zxs18261/GIM6010/1、SguanFOC库文件/docs/adr/0002-use-encoder-direction-as-mechanical-reference.md

# 以编码器方向作为机构机械正方向基准

编码器方向由安装关系决定，并可作为电机和最终机构统一的机械方向参考。项目决定装配校准以编码器定义的机械正方向为基准修正电机/PWM方向；相序、电流通道映射、Clarke/Park符号和电角度偏置仍作为独立变量验证，不能仅凭一次正向旋转同时推断全部方向正确。
