zxs18261/GIM6010/2、SguanFOC库文件/DOC/GIM6010.md

# GIM6010 关节控制器 — 总体设计文档

> **工程路径**：当前工作副本 `D:\Desktop\临时\2、SguanFOC库文件`
> **适用硬件**：GIM6010 V0.0 驱动板 + 伺泰威 GIM6010-8（24V 版）电机 + MT6816 磁编码器
> **文档版本**：v1.1（2026-09-05，四模式静态整改同步）
> **当前阶段目标**：通过 VOFA+/USART1 安全切换开环、电流/转矩、速度和位置四种模式；操作合同以工程根目录 `四模式上位机控制说明.md` 为准
> **验证边界**：本轮仅完成源码、文档和工程元数据静态复核；未重新构建、烧录或进行电机台架验证

---

## 目录

1. [项目目标与边界](#1-项目目标与边界)
2. [MCU 与软件环境](#2-mcu-与软件环境)
3. [硬件资源（原理图 + ioc 整理）](#3-硬件资源)
4. [功率级、PWM 与安全关断](#4-功率级pwm-与安全关断)
5. [电流、母线电压与温度采样](#5-电流母线电压与温度采样)
6. [电机与机械传动参数](#6-电机与机械传动参数)
7. [编码器与位置反馈](#7-编码器与位置反馈)
8. [三种角度、方向与零位约定](#8-三种角度方向与零位约定)
9. [控制架构与中断时基](#9-控制架构与中断时基)
10. [状态机设计](#10-状态机设计)
11. [代码框架（什么内容放什么文件、什么参数在哪定义）](#11-代码框架)
12. [串口与 FDCAN 协议](#12-串口与-fdcan-协议)
13. [单位与显示约定](#13-单位与显示约定)
14. [实施路线](#14-实施路线)

---

## 1. 项目目标与边界

| 项目 | 说明 |
|---|---|
| 用途 | 6 自由度机械臂关节控制器，**单板单轴**，全臂 6 板 6 电机 |
| 本期目标 | 通过 VOFA+/USART1 切换开环、电流/转矩、速度、位置四种模式，并完成单关节静态整改；闭环稳定性仍待台架验证 |
| 后续迭代 | 多轴 FDCAN 同步、重力矩前馈、性能整定、上机械臂联调 |
| 代码边界 1 | **不修改 CubeMX 生成代码**，所有代码写入 `USER CODE BEGIN/END` 段 |
| 代码边界 2 | SguanFOC 库主体结构保留；本次已对 `SguanFOC.c` 的四模式路由与失效安全路径做必要修正，后续改动须同步静态复审 |
| 允许 | 重新生成 CubeMX 工程（`GIM6010_V0.0.ioc`） |
| 状态机参考 | BTB 电机驱动工程（袁雷平台资料）概念 + **SguanFOC 库内置 24 态状态机**（实际采用后者） |

---

## 2. MCU 与软件环境

| 项目 | 配置 |
|---|---|
| MCU | STM32G431CBT6，LQFP48（ioc 实际 CPN，封装 LQFP48） |
| 主频 | 170 MHz（HSE 8 MHz 晶振 ×PLL：/2 ×85 /2） |
| 框架 | HAL 库，**裸机**（无 RTOS） |
| PWM 频率 | 20 kHz（TIM1 中心对齐，ARR=4249） |
| 调试接口 | SWD（PA13/PA14）+ USART1（PB6/PB7，921600-8N1），**共用 CN9 GH1.25-6P 接插件**（CLK/DIO/TX/RX/VCC/GND×2，见网表 CN9） |
| IDE | Keil MDK-ARM V5.32（工程 `MDK-ARM/`） |
| 代码风格 | 参照 SguanFOC：中文注释、`Sguan.xxx` 结构体化参数、static inline 用户层挂钩 |

---

## 3. 硬件资源

### 3.1 引脚分配表（以 ioc + 网表为准，★=关键信号）

| 引脚 | 网络名 | 方向 | 功能 | 外设 |
|---|---|---|---|---|
| PA8 | HIN_W | out | ★W 相上管 PWM | TIM1_CH1 |
| PA9 | HIN_V | out | ★V 相上管 PWM | TIM1_CH2 |
| PA10 | HIN_U | out | ★U 相上管 PWM | TIM1_CH3 |
| PB13 | LIN_W | out | ★W 相下管 PWM | TIM1_CH1N |
| PB14 | LIN_V | out | ★V 相下管 PWM | TIM1_CH2N |
| PB15 | LIN_U | out | ★U 相下管 PWM | TIM1_CH3N |
| PB1 | ADC_IV | in | ★V 相电流（INA181A2 输出） | ADC1_IN12（注入 Rank1） |
| PB0 | ADC_IW | in | ★W 相电流（INA181A2 输出） | ADC1_IN15（注入 Rank2） |
| PB11 | ADC_VBUS | in | ★母线电压（30k/3k 分压） | ADC1_IN14（注入 Rank3 + 规则 Rank1） |
| PA2 | ADC_NTC1 | in | ★板载 NTC（MOS 旁，3950/10k，上拉10k） | ADC1_IN3（规则 Rank2） |
| PA3 | ADC_NTC2 | in | ★电机内部 NTC（外接 P1 焊盘，上拉10k） | ADC1_IN4（规则 Rank3） |
| PB2 | ADC_IBUS | in | 母线电流（R2=5mΩ） | ADC2_IN12（规则） |
| PB3 | MT6816_SCK | out | 编码器 SPI 时钟 | SPI3_SCK（Mode3, 16bit, 5.3125Mbps） |
| PB4 | MT6816_MISO | in | 编码器 SPI 主入 | SPI3_MISO（DMA2_CH1） |
| PB5 | MT6816_MOSI | out | 编码器 SPI 主出 | SPI3_MOSI（DMA2_CH2） |
| PA15 | MT6816_CSN | out | ★编码器片选（软件 CS，经 U3 电平转换） | GPIO_Output（默认高） |
| PA4 | CSN | out | 备用片选（直连 CN47.5 外接编码器口） | GPIO_Output |
| PA12 | RGB | out | WS2812B RGB 灯 | TIM4_CH2（PWM+DMA1_CH1） |
| PA11 | KEY1 | in | 按键（SW2，10k 上拉） | GPIO_Input |
| PB6 | TX | out | 串口发送（CN9.3） | USART1_TX（DMA1_CH2） |
| PB7 | RX | in | 串口接收（CN9.2） | USART1_RX（DMA1_CH4） |
| PB8 | CAN_RX | in | FDCAN 数据（U9 收发器） | FDCAN1_RX |
| PB9 | CAN_TX | out | FDCAN 数据 | FDCAN1_TX |
| PA13/PA14 | SWDIO/SWCLK | — | SWD 调试（CN9.5/4） | SYS |
| PF0/PF1 | OSC | — | HSE 8 MHz 晶振 | RCC |

> **注意**：`TIM1_CH1=W、CH2=V、CH3=U`（引脚标签即丝印），FOC 输出比较映射时必须按此交换（见 `User_PwmDuty_Set`）。

### 3.2 电源架构（网表 U40/U4/U18）

```
VBUS(历史设计标称12~48V；当前台架仅允许24V标称, XT30:U116) ──► U40 Buck ──► 12V ──► U2 栅极驱动器供电
                                    │
                                    └──► U4 LDO ──► VCC 3.3V（MCU/编码器）
1.65V 基准：U18（供 INA181A2 差分基准，实现双向电流检测）
CAN 端接：R96=120Ω（CAN_H/CAN_L 与电源共用 XT30:U116 接插件）
```

### 3.3 调试/烧录接插件 CN9（GH1.25-6P）

| 脚位 | 信号 | 脚位 | 信号 |
|---|---|---|---|
| 1 | GND | 4 | SWCLK (PA14) |
| 2 | USART1_RX (PB7) | 5 | SWDIO (PA13) |
| 3 | USART1_TX (PB6) | 6 | VCC 3.3V |

---

## 4. 功率级、PWM 与安全关断

| 项目 | 参数 | 来源 |
|---|---|---|
| 额定母线电压 | 24 V；当前交付未验证且不允许按 48V 上电 | 24V 电机 + 当前 ADC 量程边界 |
| MOS 管 | VS1804GPH ×6（Q1/Q3/Q7 上管，Q2/Q4/Q13 下管） | 用户需求+网表（PDFN-8） |
| 栅极驱动器 | FD6288Q（U2，QFN-24），三分立自举（D1/D2/D3 + C8/C10/C11）；具体料号仍须以 BOM 与实物复核 | 原理图 PDF + 随附 FD6288 数据手册 |
| PWM 定时器 | TIM1，中心对齐模式 1，PSC=0，**ARR=4249** → **20 kHz** | ioc |
| 死区 | ioc `DeadTime=9`，tDTS=2/170MHz → **约 106 ns**（用户要求 200 ns 时改为 DT=17，待确认是否需要） | ioc 计算 |
| PWM 极性 | `PWM_Dir = -1`（高低电平对应经实测确定） | 旧工程实测 |
| MOE 安全关断 | 显式使能；停机/故障使用 `__HAL_TIM_MOE_DISABLE_UNCONDITIONALLY` 或直接清 BDTR.MOE；Break 未启用（ioc BreakState=DISABLE，后续可启用 BRK 输入） | ioc + 源码 |
| ADC 触发 | TIM1_CC4（PWM2 模式，CCR=ARR-40，**峰值前（下溢附近）触发** → 采样下桥臂电流） | ioc + 旧工程实测 |

> **安全关断路径**：显式停机、通信接收错误/队列溢出、ADC 注入链连续 5 ms 无心跳、20 kHz 电流环连续 3 个周期达到或超过 50 µs、SguanFOC 故障态以及 CPU Fault 均无条件清 TIM1 MOE，使三相桥进入高阻；普通 HAL `__HAL_TIM_MOE_DISABLE` 会因通道仍启用而拒绝清 MOE，本工程禁止将它用于安全停机。连续超期策略只在校准及正常控制状态内累计，恢复后必须重新连续累计 3 次。硬件 Break 尚未启用，仍需后续实机改版验证。

---

## 5. 电流、母线电压与温度采样

### 5.1 相电流采样（下桥臂双电阻 + INA181A2）

```
V相下管(Q2) ── R14(5mΩ) ──┐
W相下管(Q13) ─ R16(5mΩ) ─┼── IBUS+ ── R2(5mΩ) ── PGND
U相下管(Q4) ──────────────┘            │
                                       R17(0Ω) ── AGND（单点连接）

U15(INA181A2): IN+ = IV+(R14压降上端)  IN- = IBUS+  → ADC1_IN12 (V相电流)
U19(INA181A2): IN+ = IW+(R16压降上端)  IN- = IBUS+  → ADC1_IN15 (W相电流)
U16(INA181A2): IN+ = IBUS+             IN- = PGND   → ADC2_IN12 (母线电流)
基准 1.65V(U18) → 双向电流，ADC 中点 = 2048
```

| 参数 | 值 | 说明 |
|---|-----|---|
| 采样电阻 | 5 mΩ（R14/R16） | R1206 |
| 放大器 | INA181A2，**增益 ×20** | 旧工程实测采用 |
| ADC 量程换算 | `I = (ADC-2048)/4096 × 3.3V / (20×0.005Ω)` ≈ (ADC-2048)×0.00806 A | 库自动按 `Amplifier×Sampling_Rs` 计算 |
| 电流通道 | `Current_Num = 2`（BC 相 = IV+IW） | 库定义 0=AB,1=AC,2=BC |
| U 相电流 | 由 `Ia+Ib+Ic=0` 软件重构 | 库内部完成 |

### 5.2 母线电压采样（ADC1_IN14）

分压网络：`VBUS ── R20(30kΩ) ──┬── ADC1_IN14 ── R19(3kΩ) ── AGND`

- **分压比 1/11**：`VBUS = ADC/4096 × 3.3 × 11`
- ⚠️ **硬件量程限制**：ADC 3.3V 满量程对应母线约 **36.3 V**；48V 母线会使 ADC 节点理论上升至约 4.36V，已经超出当前采样链可测范围，禁止据此直接接入 48V。
- 软件阈值按既有配置为 **过压 50V / 欠压 10V**；驱动从约 35.45V（ADC 码 4000）起按过量程失效关断，为器差和噪声留出裕量。此时保护值和 Ch12 会显示 1000V 哨兵（不是实际物理电压），只能表达“已接近或超过量程边界”；若需 50V 定量检测必须修改分压网络并重新标定。

### 5.3 温度采样（双路 NTC 独立保护）

| 通道 | 引脚 | 位置 | 规格 | 过温阈值 | 故障策略 |
|---|---|---|---|---|---|
| 板载 NTC（位号 NTC2） | PA2 / ADC1_IN3 | **MOS 管旁**（板内焊接） | 3950 / 10kΩ / 0603，上拉 R3=10k→3.3V | **100 ℃**（用户要求） | 开路/短路 → 等效 **+120 ℃**（fail-safe 直接过温锁定） |
| 电机 NTC（外接 P1 焊盘） | PA3 / ADC1_IN4 | **电机绕组内部**（经连接器外接） | 暂按 3950/10k 假定（⚠️ 厂家未给规格，待确认），上拉 R4=10k→3.3V | **80 ℃**（电机额定工作温度上限，规格书 −20~+80℃） | 开路/短路/**未接** → **通道旁路**（不参与保护，台架可不接） |

- 换算（B 常数法，`T0=298.15K`，两路独立 B 值/R25 宏）：
  `R_ntc = 10k × Vadc/(3.3−Vadc)`；`T[K] = 1 / (1/298.15 + ln(R_ntc/R25)/B)`
- **库单比较点归一化**：SguanFOC 库只有一个 `Temp_MAX` 比较点 → `BSP_ADC_GetTemp()` 返回严重度归一化值：
  `severity = max( T_board×100/100 , T_motor×100/80 )`，库 `Temp_MAX=100` 时**任一通道达到自身阈值即触发过温锁定**
- 当前 24 通道 VOFA 帧不再直接显示两路物理温度；温度保护仍在运行。需要观测温度时应在受控调试固件中另加诊断通道，不能把当前 Ch21/Ch22（d/q 电流控制器输出）误当温度。
- ⚠️ 电机 NTC 实际 B 值/阻值拿到厂家规格后改 `BSP_ADC.h` 中 `BSP_ADC_NTC_MOTOR_*` 宏

### 5.4 采样调度

| 信号 | 通道 | 触发 | 频率 | 用途 |
|---|---|---|---|---|
| IV / IW / VBUS | ADC1 注入 Rank1-3 | TIM1_CC4 硬件触发 | 20 kHz | 电流环 + VBUS 快速监视 |
| VBUS / NTC1 / NTC2 | ADC1 规则 Rank1-3 | 主循环软件轮询（HAL tick 门控） | 100 Hz | 慢速保护（温升慢） |
| IBUS | ADC2 规则 | 软件按需 | 低 | 调试观测（本期不参与保护） |

---

## 6. 电机与机械传动参数

> 完整数据见 `资料/文档/GIM6010_电机参数规格书(24V).md`（厂家 24V 版），此处为直接引用摘要。

| 参数 | 值 | 参数 | 值 |
|---|-----|---|-----|
| 极对数 | **14** | 额定电压 | 24 V |
| 线电阻 Rs | 0.44 Ω | 额定功率 | 158.4 W |
| 线电感 Ld/Lq | 230.77 mH（厂家标称，疑似 230.77µH，待 LCR 实测） | 额定电流 | 6.6 A |
| 磁链 Flux | ≈0.02905 Wb（Kt=0.61/(1.5×14) 估算） | 堵转电流 | 30.47 A |
| 减速比 | **8:1** 行星（钢齿轮） | 输出轴背隙 | 15 arcmin |
| 转矩常数 Kt | 0.61 N·m/A | 额定/峰值转矩 | 4.85 / 12.39 N·m（输出轴） |
| 输出轴额定转速 | 245 rpm（25.66 rad/s） | 电机轴额定转速 | 1960 rpm（205.3 rad/s） |
| 速度上限（软件） | 输出轴 30.79 rad/s（额定×1.2） | 工作温度 | −20~+80 ℃（驱动板过温阈值另设 100℃） |

**换算关系**（单位约定见 §13）：
- 电机轴转速 = 输出轴转速 × 8
- 输出轴角度 = 电机轴角度 / 8
- 上位机单位：串口位置命令与 VOFA 角度通道使用 **rad**，串口速度命令使用输出轴 **rad/s**，VOFA/CAN 速度遥测使用输出轴 **rpm**；当前活动合同不使用 deg

---

## 7. 编码器与位置反馈

| 项目 | 配置 |
|---|---|
| 型号 | MT6816（磁编码器，安装在**电机转子轴**上，非减速器输出轴） |
| 接口 | SPI3（Mode3 CPOL=1/CPHA=2Edge，16bit 帧，5.3125 Mbps），CS = PA15 软件控制，经 U3 电平转换接 CN47 外接口 |
| 类型 | **绝对式、单圈** |
| 分辨率 | **14 bit = 16384 CPR**（ANGLE 寄存器有效位，手册确认） |
| 采样方式 | 主循环调用 `BSP_MT6816_PollBlocking()`，以 HAL tick 门控为约 **1 kHz**；每次阻塞完成 SPI 双帧（命令 0x3000/0x3100 + 数据回读），带奇偶校验 + 无磁检测 |
| 无第二编码器 | 输出轴位置 = 转子位置 ÷ 8（软件折算） |
| 数据缓存 | 阻塞读取完成后发布快照（角度/速度/多圈计数），**20 kHz 电流环 ISR 只读缓存，绝不轮询 SPI**；旧 DMA 请求/服务 API 仅保留为停用实验路径 |

> BSP 层（`BSP/BSP_MT6816.c`）提供 `mech_rad`（转子单圈 0~2π）、`mech_cont_rad`（连续角）、`elec_rad`（电角度）、`mech_omega_rpm`（转子 rpm）、`shaft_*`（输出轴折算量）全套接口，含 DWT 时戳与失效超时检测。活动路径是主循环约 1 kHz 阻塞读取后发布缓存，不得依据保留的 DMA API 注释恢复 ISR 投递。

---

## 8. 三种角度、方向与零位约定

### 8.1 三种角度定义

| 角度 | 符号 | 定义 | 来源 |
|---|---|---|---|
| 机械角（转子） | `Real_Rad` | MT6816 单圈原始角，**0~2π**，以 **MT6816 增大方向为正** | 编码器直读 |
| 机械角（连续/多圈） | `Real_Pos` | 机械角累计圈数展开，PLL 平滑 | 库 PLL |
| 电角度 | `Real_Erad` | `机械角 × 极对数(14)`，归一化 0~2π，供 Park/SVPWM | 库计算 |

- **一切以转子机械角度（MT6816 值）为准**：判断电机正/反转、判断电角度方向、判断零位。
- 单圈范围统一 **0~2π**；`Real_Pos` 多圈连续。
- 输出轴角度 = 转子角 / 8（仅用于上位机显示与关节层面命令，控制环内部始终用转子角）。

### 8.2 方向约定与相序校准流程

**正方向定义：MT6816 读数增大的方向 = 关节正方向。**

上电校准流程（首次带载验证时执行，流程写入 §10 应用状态机 CALIBRATE 态）：

1. 上电读 MT6816 原始角 → 记录 `enc_start`
2. 以小 Uq 开环拖动电机正转（`Motor_Dir=+1`）
3. 若 `enc_end > enc_start`（增加）→ **相序正确**，`Motor_Dir=+1`、`Encoder_Dir` 保持
4. 若 `enc_end < enc_start`（减少）→ **三相焊反**：物理调换任意两相线，或软件置 `Motor_Dir=-1`（临时），最终以硬件调线为准
5. 电流方向同理验证：正 Iq 应产生正转矩（编码器读数增大），否则翻转 `Current_Dir0/1`
6. 结果写入 `UserData_Motor.h` 并记录到本文档 §15 台架记录

### 8.3 电角度零位（编码器-转子对齐）

- 库 INITIALIZING/CALIBRATING 流程执行：经用户层缩放后的 `Ud = 0.04×VBUS` 拉 d 轴 → 保持 1200 ms → 采样 MT6816 角为 `Pos_offset` → 撤压并等待 800 ms
- `Real_Erad = (mech_rad − Pos_offset) × 14`，软件自动完成
- 零位值断电丢失（无 Flash 保存），每次上电重新对齐（绝对编码器使对齐过程确定性可重复）

---

## 9. 控制架构与中断时基

### 9.1 控制环结构（SguanFOC 三环）

```
主循环：BSP_MT6816_PollBlocking() 约1kHz → 发布角度/速度缓存
                               │
┌──────────────── 20 kHz（ADC 注入完成 ISR）──────────────────────────┐
│ 读编码器缓存 → PLL/角度；Clarke/Park → Id/Iq                         │
│ 电流环 PI(D/Q) 每周期执行 → Ud/Uq → Park逆 → SVPWM → TIM1 CCR       │
│ 速度环每 Response=20 周期执行一次：约 1 kHz                          │
│ 位置环每 Response²=400 周期执行一次：约 50 Hz                         │
└────────────────────────────────────────────────────────────────────┘
TIM2 ISR（1 kHz）：状态机、保护和 ADC High_Loop 心跳监视
主循环：VOFA JustFloat 发送（500 Hz）/ FDCAN / RGB / UART 命令解析 / 慢 ADC（100 Hz）
```

### 9.2 中断优先级（NVIC，ioc 已定）

| 优先级 | 中断 | 功能 | 频率 |
|---|---|---|---|
| 0 | ADC1_2_IRQn | 电流环 High_Loop | 20 kHz |
| 2 | TIM2_IRQn | Low_Loop（状态机、保护、ADC 心跳监视） | 1 kHz |
| 3 | USART1、DMA1 | 串口 VOFA 收发 | 500 Hz/921600bps |
| 0(未启) | TIM1_BRK 等 | 预留刹车保护 | — |

> TIM2 的 `Low_Loop` 负责状态机和保护，不直接执行速度/位置控制器。SPI3/DMA2 中断和旧异步 API 仍保留在工程中，但当前活动采样路径不投递 DMA 请求。

### 9.3 环路频率分配（库 Response=20 分频机制）

| 环 | 频率 | 驱动 |
|----|---|---|
| 电流环 | 20 kHz | ADC1 注入完成回调 |
| 编码器采样 | 约 1 kHz | 主循环 `BSP_MT6816_PollBlocking()`，HAL tick 自限速 |
| 速度环 | 1 kHz | 20kHz/Response(20) |
| 位置环 | 50 Hz | 20kHz/Response²(400) |
| 状态机+保护 | 1 kHz | TIM2 ISR |
| VOFA 上报 | 500 Hz | 主循环节拍 |

---

## 10. 状态机设计

### 10.1 两级状态机架构

```
┌────────────────────────────────────────────────────────────────┐
│ 应用层状态机 APP_JointState（APP/app_joint.c，主循环+命令驱动）     │
│  管理命令源(串口/CAN)、模式切换请求、标定流程触发、LED 主题           │
└───────────────┬────────────────────────────────────────────────┘
                │ 写 Sguan.mode / Sguan.status / Sguan.foc.Target_*
┌───────────────▼────────────────────────────────────────────────┐
│ FOC 内核状态机 Sguan.status（SguanFOC.c，1kHz Low_Loop 驱动，24态） │
│  保护转移(过压/欠压/过温/过流/编码器错) + 运行态细分                 │
└────────────────────────────────────────────────────────────────┘
```

应用层不重复实现保护逻辑（库已含），只做**命令仲裁 + 模式管理 + 上层协议**。

### 10.2 FOC 内核状态机（库内置，`Sguan_MotorStatus.h`，禁止修改）

| 编号 | 状态 | 含义 | 退出 |
|---|---|---|---|
| 0x00 | STANDBY | 待机（未初始化） | 解锁信号→0x01 |
| 0x01 | UNINITIALIZED | 等待初始化触发 | 自动→0x02 |
| 0x02 | INITIALIZING | 参数加载、外设启动、**编码器零位对齐** | 自动→0x03 |
| 0x03 | CALIBRATING | 校准（SVPWM 可用，转子校正） | 自动→0x04 |
| 0x04 | IDLE | 空闲（MOE 关闭，高阻等待目标） | 有效运动目标→运行态；模式0～2近零保持高阻，位置 `AO=0?` 也可有效 |
| 0x05/0x06 | TORQUE_INC/DEC | 力矩增大/减小中（电流模式） | 稳态→0x07 |
| 0x07 | TORQUE_CONTROL | 力矩保持（电流模式稳态） | — |
| 0x08/0x09 | ACC/DEC | 加/减速中（速度模式） | 稳态→0x0A |
| 0x0A | CONST_SPEED | 恒速（速度模式稳态） | — |
| 0x0B/0x0C | POSITION_INC/DEC | 位置增/减中（**位置模式**） | 到位→0x0D |
| 0x0D | POSITION_HOLD | 位置保持（**位置模式稳态**） | — |
| 0x0E | OVERVOLTAGE | 过压（**锁定**） | 手动解除→0x00 |
| 0x0F | UNDERVOLTAGE | 欠压（**锁定**） | 手动解除→0x00 |
| 0x10 | OVERTEMPERATURE | 过温>100℃（**锁定**） | 手动解除→0x00 |
| 0x11 | UNDERTEMPERATURE | 低温（锁定） | 手动解除→0x00 |
| 0x12 | OVERCURRENT | 过流（当前实现锁定并立即关 PWM） | 条件恢复后手动 `CO=1?` |
| 0x13 | ENCODER_ERROR | 编码器故障（锁定） | 手动解除→0x00 |
| 0x14 | SENSOR_ERROR | 传感器故障（锁定） | 手动解除→0x00 |
| 0x15 | PWM_CALC_FAULT | PWM 计算错误/连续 3 个 50 µs 周期超期（锁定） | 手动解除→0x00 |
| 0x16 | EMERGENCY_STOP | 急停（立即关 PWM，锁定） | 手动解除→0x00 |
| 0x17 | DISABLED | 软失能（缓慢停止） | 自动→0x00 |

**状态转移图（运行主线）**：

```
0x00 STANDBY ─解锁─► 0x01 ─自动─► 0x02 INITIALIZING(对齐Ud) ─► 0x03 CALIBRATING ─► 0x04 IDLE
                                                                    │
             ┌──────────────────────────────────────────────────────┤
             ▼                                                      ▼
模式=电流: 0x05/0x06 ⇄ 0x07        模式=速度: 0x08/0x09 ⇄ 0x0A     模式=位置(本期): 0x0B/0x0C → 0x0D
             │                                                      │
             └─────────── 任意运行态 ──► 故障态 0x0E~0x17 ◄──────────┘
                              故障态 ──条件消失后显式 CO=1? ──► 0x01（重新初始化/对齐）
```

### 10.3 应用层关节状态机（`APP/app_joint.c`，新增）

| 状态 | LED（WS2812B） | 进入条件 | 动作 |
|---|---|---|---|
| APP_INIT | 白色呼吸 | 上电 | 外设自检、FDCAN 上线、等待 500ms |
| APP_STANDBY | 绿色慢闪 | APP_INIT 完成 | **不自动使能闭环**（防首次闭环方向符号未知导致过流），等串口 `CO=1?` 或 CAN 使能 |
| APP_IDLE | 绿色呼吸 | FOC 0x04 | MOE 关闭，等待当前模式的显式目标 |
| APP_CALIBRATING | 黄色闪烁 | FOC 0x02~0x03 | 观察对齐过程（可扩展相序自检 §8.2） |
| APP_RUNNING | 青色呼吸 | FOC ≥0x04 且收到目标 | 按当前模式执行目标；位置命令与 Ch9 反馈均为电机轴 rad |
| APP_FAULT | 红色快闪 | FOC 故障态(0x0E~0x17) | 记录故障码，等待清除命令 |
| APP_DISABLED | 蓝色慢闪 | 收到失能命令 | 置 DISABLED 信号，FOC 软停 |

应用层命令由串口 VOFA 或 FDCAN 统一仲裁。串口使用 `BO=0..3?`、`AO=<有限十进制>?`、`VO=<有限十进制>?`、`CO=0/1?`；FDCAN 使用 §12.2 的模式/使能/停机位。位置零点只由显式初始化后的对齐建立，CAN bit5 保留且必须写 0。

---

## 11. 代码框架

### 11.1 目录结构（什么内容放在什么文件）

```
2、SguanFOC库文件/
├── GIM6010_V0.0.ioc          # CubeMX 工程（允许重新生成；引脚/外设/中断优先级唯一事实源）
├── Core/                     # CubeMX 生成代码 —— 只写 USER CODE 段
│   ├── Src/main.c            # [USER 2] 外设启动顺序+APP初始化；[WHILE] 主循环调 APP 层
│   ├── Src/fdcan.c           # Init 结构体配置 1Mbps 位时序 + 标准滤波器数量
│   ├── Src/stm32g4xx_it.c    # FDCAN IRQ 转交 HAL；CPU Fault 直接清 TIM1 MOE
│   └── Inc/main.h            # [USER] 引脚标签由 CubeMX 生成，extern 声明
├── APP/                      # 应用层（手写，业务逻辑）
│   ├── app_callbacks.c/.h    # ★HAL 回调聚合：TIM2(1kHz Low_Loop)、ADC注入(20kHz High_Loop)、
│   │                            UART(VOFA命令)、FDCAN(RX)——旧工程 Hardware/Timer.c 的角色
│   ├── app_joint.c/.h        # ★应用层关节状态机(§10.3)+命令仲裁+CAN/VOFA 单位边界
│   └── canfd.c/.h            # FDCAN 协议：节点ID、命令帧、遥测帧、多轴时隙
├── BSP/                      # 板级支持包（手写，与硬件一一对应）
│   ├── BSP_MT6816.c/.h       # 编码器：活动路径为主循环约1kHz阻塞采样；DMA实验接口停用保留
│   ├── BSP_WS2812B.c/.h      # RGB 灯效：PWM+DMA、呼吸/闪烁预设（旧工程恢复）
│   └── BSP_ADC.c/.h          # ★慢速采样：VBUS 分压换算、NTC 3950 温度换算、IBUS（本期新增）
├── SguanFOC v3.0.1/          # FOC 库（四模式与安全修正需同步复审）
│   ├── SguanFOC.c/h          # 三环计算+内核状态机+高低主循环
│   ├── Sguan_SVPWM/PID/PLL/STA/Filter/IQmath/MotorStatus/printf/Optimize  # 算法，只读
│   ├── UserData_Config.h     # ★功能开关+时基宏+GIM6010 机械常量；当前集成编译期禁止 Q31
│   ├── UserData_Motor.h      # ★电机实体参数+量化参数+安全阈值（本文件=电机身份证）
│   ├── UserData_Parameter.h  # ★三环 PID/滤波/PLL 参数
│   ├── UserData_Function.h   # ★HAL 绑定层：PWM启动/ADC读取/编码器角度/PWM映射/通信发送
│   ├── UserData_Status.h     # ★状态机挂钩：故障信号输入+各状态 LED/上报动作
│   └── UserData_UserControl.h# ★VOFA 实时调参(AO/BO/CO)+JustFloat 发送通道定义
├── DOC/GIM6010.md            # 本文档
├── MDK-ARM/                  # Keil 工程（源文件增删需同步 uvprojx）
├── VOFA控件/                 # 上位机控件
└── 资料/                     # 原厂手册、原理图、旧版整理文档（只读参考）
```

### 11.2 参数定义位置总表（什么参数在什么里面定义）

| 参数类别 | 定义位置 | 示例 |
|---|---|---|
| 引脚/外设配置/中断优先级 | `GIM6010_V0.0.ioc`（CubeMX 唯一事实源） | TIM1 ARR=4249、ADC 触发 T1_CC4 |
| 电机电气参数（极对数/Rs/Ld/Flux） | `UserData_Motor.h → Sguan.identify/Sguan.motor` | Poles=14, Rs=0.44 |
| 安全阈值（过压50V/欠压10V/过温100℃/过流30.47A/限幅） | `UserData_Motor.h → Sguan.safe.*` | VBUS_MAX=50 |
| 电流采样量化（增益/采样电阻/通道） | `UserData_Motor.h → Sguan.motor.*` | Amplifier=20, Rs=5mΩ |
| 三环 PID/滤波/PLL 参数 | `UserData_Parameter.h` | Position.Kp=7 |
| 环路频率/分频/Response | `UserData_Config.h` | USER_FOC_CONTROL_HZ=20000 |
| 减速比/额定值/软件限速等机械常量 | `UserData_Config.h` GIM6010_* 宏 | GEAR_RATIO=8 |
| NTC B值/分压比等 ADC 换算系数 | `BSP_ADC.h` 宏 | NTC_B_3950, VBUS_DIV=11 |
| CAN 节点号/波特率/帧 ID | `canfd.h` 宏 | CANFD_NODE_ID |
| VOFA 显示通道（角度 rad、输出轴速度 rpm） | `UserData_UserControl.h → User_UserTX` | Ch9/13/14=rad，Ch1/2=rpm，Ch15～23=电流诊断 |
| 应用状态机枚举/命令码 | `app_joint.h` | APP_JointState_t |
| LED 灯效预设 | `BSP_WS2812B.h` | BREATH_GREEN |

### 11.3 数据流与调用关系

```
main() [USER 2]
 ├─ APP_JointInit()            // app_joint: 状态机初值、CAN 滤波器、灯效
 ├─ APP_UartRxStart()          // VOFA ReceiveToIdle DMA 启动并检查结果
 └─ HAL_TIM_Base_Start_IT(&htim2)       // 1kHz Low_Loop 起点
while(1) [WHILE]
 ├─ SguanFOC_main_Loop()       // 库主循环(JustFloat 500Hz 发送→User_UserTX)
 └─ APP_JointPoll()            // UART命令+状态机+LED+慢ADC+FDCAN
      └─ BSP_MT6816_PollBlocking() // 编码器主循环阻塞直读，约1kHz自限速

ISR 层：
 TIM2(1kHz) ──► SguanFOC_Low_Loop()        // 状态机+保护+ADC心跳
 ADC1注入(20kHz) ──► SguanFOC_High_Loop()  // 电流环+SVPWM；分频执行速度/位置环
 UART idle ──► 完整数据块入队；主循环 APP_UartCommandPoll() 严格解析命令
 FDCAN RX ──► HAL handler→完整帧校验/入队；主循环 CANFD_Poll() 顺序解析
```

---

## 12. 串口与 FDCAN 协议

### 12.1 串口 VOFA（调试通道，USART1 921600）

**下行（PC→板）SguanFOC 原生格式 `XX=数值?`**：

| 命令 | 功能 | 单位 |
|---|---|---|
| `BO=3?` | 切模式：0开环/1电流/2速度/**3位置** | — |
| `AO=1.57?` | 目标值（位置模式=目标位置） | rad（电机轴） |
| `VO=30?` | 辅助目标（开环=输出轴速度） | rad/s |
| `CO=0?` / `CO=1?` | 精确 `0`=任意时刻停机清零；精确 `1` 在 Ch0=1～3 时忽略，否则先关桥清目标，STANDBY/可清故障态重新初始化、IDLE/运行态只回 IDLE；其他数值拒绝 | — |

`BO`/`CO` 必须采用上表所示的单个 ASCII 数字格式；小数、正负号和科学计数法只适用于 `AO`/`VO` 中允许的有限十进制值。

**上行（板→PC）JustFloat 500Hz**（通道定义 `User_UserTX`，遵守 §13 单位约定）：

| Ch | 含义 | 单位 | Ch | 含义 | 单位 |
|----|---|---|----|---|---|
| 0 | 状态机编号 | — | 12 | 母线电压 | V |
| 1 | 输出轴实测速度 | rpm | 13 | 实际电角度 | rad |
| 2 | 输出轴目标速度 | rpm | 14 | MT6816 单圈机械角 | rad |
| 3/4 | Id / Iq | A | 15/16 | IV / IW 原始 ADC（故障冻结） | count |
| 5 | U 相 CCR | count | 17/18 | IV / IW 偏置（故障冻结） | count |
| 6 | High_Loop 计数低16位 | count | 19/20 | 两路采样换算电流（故障冻结） | A |
| 7 | Uq | V | 21/22 | d / q 电流控制器输出（故障冻结） | V |
| 8 | Ia | A | 23 | Iq 目标（故障冻结） | A |
| 9 | PLL 连续位置（电机轴） | rad |  |  |  |
| 10 | 零位偏置 Pos_offset | rad |  |  |  |
| 11 | 控制模式 0~3 | — |  |  |  |

### 12.2 FDCAN（多轴总线，1 Mbps 经典帧，本期实现基础子集）

| 帧 | ID 规则 | DLC | 载荷 | 方向 |
|----|---|-----|---|---|
| 位置命令 | `0x100+节点号` | 8 | `int32 位置µrad(输出轴) + int16 速度rpm限幅 + uint16 模式/使能位` | 主→从 |
| 状态遥测 | `0x200+节点号` | 8 | `int32 位置µrad + int16 转速rpm + uint16 状态/故障码` | 从→主(500Hz) |
| 广播同步 | `0x7FF` | 0 | — | 主→从(预留) |

- 节点号：拨码/Flash 参数（本期 `CANFD_NODE_ID` 编译期宏，默认 1）
- 波特率 1Mbps：在 `fdcan.c [USER FDCAN1_Init 1]` 覆盖（170M/(10×(1+12+4))，采样点 76.5%）
- 连续位置超过 int32 微弧度范围（约 +2147.483647/-2147.483648 rad）时遥测饱和、不回绕；转速同样按 int16 rpm 饱和，非有限位置/速度编码为 0 并保留状态字。

---

## 13. 单位与显示约定

| 量 | 内部/串口命令 | VOFA JustFloat | FDCAN 载荷 |
|----|---|---|---|
| 角度 | rad；`AO` 位置目标为电机轴连续角 | Ch9/13/14 均为 rad | 位置命令/遥测为输出轴 rad×10⁶ 后的 int32 µrad |
| 角速度 | 内部为电机轴 rad/s；`VO`/速度模式 `AO` 为输出轴 rad/s | Ch1/2 为输出轴 rpm | `speed_rpm` 为输出轴 rpm |
| 电流 | A | A | 模式1目标为 mA 整数 |
| 电压 | V | V | 模式0 Uq 目标为 mV 整数 |
| 温度 | ℃ | 当前 24 通道不直接显示 | 未编码 |

- **正方向**：MT6816 读数增大方向（§8.2）
- VOFA 单位映射集中在 `User_UserTX()`，CAN 编解码集中在 `canfd.c`；当前活动上位机合同不使用 deg。不得把度数直接作为位置模式 `AO` 发送

---

## 14. 实施路线

### 本期（位置环打通）

1. ✅ 恢复 BSP_MT6816、BSP_WS2812B 与 UserData 用户层资产；MT6816 当前采用约 1 kHz 主循环阻塞读取，旧 DMA 链仅保留待后续台架定位
2. ✅ 本文档（状态机+代码框架）
3. ✅ `UserData_*` 按阈值更新：配置过压上限 50V/欠压 10V/过温 100℃，并对 VBUS ADC 原始码 ≥4000（名义约35.45V）使用过量程哨兵立即关断；默认开环且 APP 层上电保持高阻，必须手动 `CO=1?` 初始化
4. ✅ 新增 `BSP_ADC.c/h`：VBUS(÷11) + NTC(3950/10k) 换算，接入 `User_VBUS_DataGet/User_Temperature_DataGet`（20kHz 注入 Rank3 快速通道 + 100Hz 规则组 NTC）
5. ✅ 新增 `APP/app_callbacks.c`（移植旧 Hardware/Timer.c + VBUS 快速喂给 + FDCAN RX）、`APP/app_joint.c`（应用状态机+LED 主题）、`APP/canfd.c`（1Mbps 基础协议：命令帧/遥测帧）
6. ✅ `main.c [USER 2/WHILE]` 挂接；FDCAN 位时序在 `HAL_FDCAN_Init` 前通过 Init 结构体配置为 1Mbps，并启用 RX IRQ
7. ℹ️ 历史基线曾记录 Keil 0 Error / 0 Warning；本次整改按约束未重新构建，不能将该记录视为当前源码的编译证明
8. ⬜ 台架：方向校准(§8.2)→电流环→速度环→**位置环**（Kp=7 起步，VOFA `BO=3?`+`AO=位置?`）

### 不改算法文件的等价实现（设计说明）

| 旧工程做法（改 SguanFOC.c） | 本工程做法（纯用户层） |
|---|---|
| 对齐电压 0.3×VBUS 改宏 | `User_PwmDuty_Set` 在 CALIBRATING 态按 `USER_ALIGN_UD_RATIO` 缩放占空比 |
| High_Loop 编码器失联检查 | `UserData_Status.h` 的 `ENCODER_ERROR_Signal` 钩子返回缓存超时标志 |
| Printf TX DMA 双缓冲+限速 | `User_CorrespondSet` 内 500Hz 限速 + 忙丢弃（原版库协议不变） |
| VBUS_MIN 拼写修正 | 沿用库内 `VBUS_MIM` 成员名（内部自洽） |

### 后续迭代

- 位置环整定（Kp/Kd 扫参、前馈重力矩）
- FDCAN 六轴同步控制（广播同步帧、遥测时隙、节点号 Flash 持久化）
- CAN 速度限幅字段接入速度环、CAN 完整命令协议
- 转矩模式关节空间控制、抱闸接口（预留）
- 死区确认 200ns（DT=17）与 Break 刹车输入启用评估

---

## 15. 历史构建环境记录（非当前操作指令）

> 下表来自旧主机调试记录，其中 `C:\Users\18261\...` 等绝对路径不属于当前工作副本，也未在本轮确认存在。本轮按任务边界没有构建；后续应在实际主机重新确认 Keil/ARMCC5/DFP 路径后再执行构建，不能照抄旧绝对路径。

| 项 | 配置 |
|----|---|
| 历史曾使用的 UV4 | `C:\Users\18261\AppData\Local\Keil_v5\UV4\UV4.exe`（旧主机记录：V5.42；当前主机待确认） |
| 编译器 | ARM Compiler **V5.06u7**（工程 uAC6=0；库内 AC5 半主机段已在 Sguan_printf.c 用户段关闭） |
| 旧主机不兼容记录 | `C:\Keil_v5\UV4` 与 `D:\Keil_v5\UV4` 的 V5.39 曾报 `Device not supported by Toolchain`；不代表当前主机探测结果 |
| 历史命令格式 | `UV4.exe -b GIM6010_V0.0.uvprojx -o build_log.txt`；仅供重新确认工具链后参考，本轮未执行 |
| 旧主机环境问题 | `C:\Users\18261\AppData\Local\Arm\Packs\pack.idx` 曾损坏；该记录不代表当前主机状态 |
| Keil 工程改动 | Groups 增加 `Application/User/APP`、`Application/User/BSP`、`SguanFOC` 三组；IncludePath 增加 `../APP;../BSP;../SguanFOC v3.0.1`；RTE 组件清空（直接使用 Drivers/CMSIS 头文件路径） |

---

## 16. 台架记录（随调试追加）

| 日期 | 事项 | 结果 |
|---|---|---|
| 2026-08-30 | 文档建立、旧资产恢复、框架设计 | — |
| 2026-08-30 | 全部代码实现 + Keil 编译 | **0 Error / 0 Warning**，Code=40940B |
| 2026-08-30 | 温度保护改为双路 NTC 独立策略（板载100℃ fail-safe / 电机内部80℃ 可旁路），VOFA 增 Ch21/22 物理温度 | **0 Error / 0 Warning**，Code=41088B |
| 2026-08-30 | **首次上电**：Ch0=19编码器锁定、VBUS=23.1V✓、模式3✓、双NTC=-50✗。定位并修复三处缺陷：①主循环未调`BSP_MT6816_Service()`（改由APP_JointPoll调度）②规则组轮询与EOC_SEQ语义冲突（改逐通道单序列读）③增Ch23=编码器DMA错误计数 | **0 Error / 0 Warning**，Code=41352B |
| 2026-08-30 | **二次上电**：NTC修复✓(板载33.2℃/电机31.4℃缓升)、零位3.486rad✓，但Ch0仍=19、Ch6冻结、Ch23=754。**两个真根因**：①`HAL_ADC_Stop`源码会停掉规则+注入两组并`ADC_Disable`——NTC轮询第一次调用即把20kHz电流采样链永久杀死（Ch6冻结/编码器断供/19锁定全链条解释）②TIM4为CubeMX占位配置(ARR=65535/半字DMA)，RGB严格自检不过→灯全黑（旧工程后期同因，非灯坏） | — |
| 2026-08-30 | 修复④：BSP_ADC改纯LL寄存器级单通道读（ADSTART→EOC→DR，无ADSTP/ADDIS，注入链路零影响）；修复⑤：BSP_RGB_Init先重配TIM4(PSC=0/ARR=211)+DMA字对齐再自检 | **0 Error / 0 Warning**，Code=40780B |
| 2026-08-30 | **三次上电（修复④⑤后）**：编码器/ADC 链修复生效→首次真正进入闭环→**上电即电源OCP（限流6A）**。定位：闭环方向符号（Current_Dir等）从未被闭环验证（旧工程仅开环），符号接反→电流环正反馈→饱和±12V→~27A→OCP；对齐电流已核实被限到~2.2A（SVPWM_Tick→User_PwmDuty_Set 链路验证）| 修复⑥：上电改 STANDBY 待命（不自动使能），手动 `CO=1?` 才进闭环，**0 Error/0 Warning** Code=40824B |
| 2026-08-30 | **四次上电（修复⑥后）**：STANDBY 待命生效，但库 main_Loop 仅在 status>3/≥19 发送 VOFA → 待命态无遥测、电机无反应（用户报告无任何反应）。修复⑦：APP 层在 status≤3 时补发 JustFloat（Printf_Init 提前到 APP_JointInit；调库公开 API User_UserTX+Printf_Loop，不改算法） | **0 Error / 0 Warning**，Code=41180B |
| 2026-08-30 | **五次上电**：待命遥测生效但全 0（Ch12=0/Ch21=+120/Ch14=0不变）。根因：待命态 ADC 未使能（使能在 FOC 流程内）、MT6816 未初始化、无采样请求源。修复⑧：LL 读取按需 LL_ADC_Enable（ADRDY 等待）；修复⑨：APP_JointInit 提前 BSP_MT6816_Init + 待命态 1kHz 投递采样请求；User_InitialInit 校准前先 LL_ADC_Disable 防冲突 | **0 Error / 0 Warning**，Code=41272B |
| 2026-08-30 | **方向标定（§8.2 第0步完成）**：从控制器端看顺时针 = Ch14 增大 = 关节正方向 ✅。据此修正 `Encoder_Dir: -1 → +1`（库内控制角=(BSP角−零位)×Encoder_Dir，-1 会使闭环正方向=逆时针，与约定相反） | **0 Error / 0 Warning**，Code=41272B |
| 2026-08-30 | **阶梯第1步执行**：`BO=1?`✓(Ch11=1)、`CO=1?` 后电源 OCP。帧解码：Ch0=15(欠压,VBUS塌到2.8V)、**Uq=-12V饱和**、**Ch14=3.631冻结**、**Ch23=13566且停增**、Ch6每帧+40✓、双NTC=25.6/25.2℃✓。**根因：使能后编码器DMA链全灭→电角度冻结→电流环失控饱和→OCP**（待命态同链路正常，失败关联'使能后20kHz中断投递+DMA完成链'）。修复⑩：弃用DMA链，改`BSP_MT6816_PollBlocking()`主循环1kHz阻塞直读（与DMA完成同发布路径，User_Delay/待命/运行统一），ISR不再投递 | **0 Error / 0 Warning**，Code=39416B |
| 2026-08-30 | **修复⑩验证成功**：`BO=1?`+`CO=1?` 对齐完成进电流模式运行态(Ch0=6)不OCP：VBUS=23.17V✓、Uq=-0.002V✓、零位3.483rad✓、Ch14在线✓、Ch23=0✓、双NTC✓。**随后 `AO=0.3?` → 电源短路保护**：Iq=0时环路静止于不稳定平衡点未暴露，加目标即正反馈雪崩 → 判定电流采样极性反。修复⑪：`Current_Dir0/1: +1→-1`；台架保险：电流环电压上限 ±12V→±6V（校准后恢复） | **0 Error / 0 Warning** |
| 2026-08-31 | **数据A/B解码**：所谓"稳定4.2A/1.3A"实为**冻结输出锁死态**——库回 STANDBY 时不清零 PWM，功率级以最后矢量持续输出（Ch0=0+Ch5=2741非零矢量+电机温度24.6→56.8℃铁证）；数据B中 Uq 精确顶在−3.0V 饱和、母线1.3A 与 3V/0.44Ω 完全吻合。修复⑫：APP 层冻结安全网（运行中回 STANDBY→强制 EMERGENCY_STOP 清零）；映射试验#1：`User_ReadADC_Raw` ch0/ch1 互换（±3V 诊断顶仍在） | **0 Error / 0 Warning** |
| 历史待办（已废止） | 旧版曾计划用 `AO=0.3?` 直接判断映射；该步骤已被 §17.4/§17.6 的独立初始化、微小阶跃和显式停机流程替代，不得继续照此执行 | — |
| 待办 | 上电先确认白灯呼吸(500ms)→绿色慢闪(STANDBY、MOE关闭)；再显式发送 `BO=<模式>?`、`CO=1?` 后观察黄灯对齐→绿灯呼吸(IDLE) | — |
| 历史待办（已废止） | 旧版曾计划直接发送 `AO=6.28?`；现改为 §17.3 的 ±0.25 rad 以内小阶跃，并在每组测试后 `CO=0?` | — |
| 待办 | 方向校准 §8.2（开环正转+编码器读数方向）确认 Motor_Dir/Current_Dir | — |
| 待办 | 确认电机内部 NTC 规格（B值/R25）→ 修正 `BSP_ADC_NTC_MOTOR_*` 宏 | — |

---

## 17. 烧录后快速测试指南（上电→转电机）

### 17.0 测试前准备（30秒检查）

| 项 | 要求 |
|----|---|
| 电源 | 使用电机铭牌对应的 **24V** 电源并限流 3A；当前约 35.45V 起按 ADC 过量程关断，禁止按旧说明直接使用 48V |
| 电机 | 三相线接好，**空载**、输出轴不连接机械臂 |
| 编码器 | SPI 线接好（CN47），电机转子轴上磁铁就位 |
| 调试器 | CN9 接 SWD+串口（PA13/14 + PB6/7），串口 921600-8N1 |
| 上位机 | VOFA+：串口连接 → 协议选 **JustFloat**，通道数 24 |

### 17.1 上电与显式初始化时序（必须结合上位机状态）

```
上电 ─► 白色呼吸(500ms) ─► 绿色慢闪(STANDBY，MOE关闭)
     ─► 发送 BO=<模式>?、CO=1? ─► 黄色闪烁(初始化/对齐) ─► Ch0=4、绿色呼吸(IDLE，MOE仍关闭)
```

- **绿色慢闪只表示 STANDBY；绿色呼吸只表示 IDLE。两者都不代表位置环已经带电保持。**
- 黄色闪烁/对齐只会在显式 `CO=1?` 后出现；对齐期间不要触碰电机轴，也不要重复发送启动命令
- ❌ 红色快闪 = 故障锁定，查 §17.5 故障码表

### 17.2 STANDBY 静态体检（不发运动命令）

| 检查项 | VOFA 通道 | 正常值 | 异常处理 |
|---|---|---|---|
| 母线电压 | Ch12 | ≈ 电源电压（÷11 换算） | 偏差大 → 查 R19/R20 焊接；<10V 欠压锁定 |
| 编码器 | Ch14(rad) | **手转电机轴，数值在 0~2π 内连续变化并正确跨零** | 不变 → SPI 线/磁铁；跳变 → 干扰 |
| 高频环计数 | Ch6 | STANDBY 不要求 20kHz 递增；初始化后相邻 500Hz 帧增量约 40 | 初始化后冻结 → 查 ADC 触发/IRQ |
| 状态机 | Ch0 | 上电待命为 0 (STANDBY) | 未发 `CO=1?` 不应自动变为 1~4 |
| 功率桥 | 示波器/逻辑分析仪 | STANDBY 无门极脉冲、TIM1 MOE=0 | 有脉冲立即断电排查 |

### 17.3 位置环点动测试（限流、空载）

先显式选择位置模式并初始化，等待 Ch0=4 后再从小角度目标开始：

```
BO=3?
CO=1?
（等待 Ch0=4）
AO=0.25?      ← 电机轴连续角先做小正阶跃
AO=-0.25?     ← 再做小负阶跃
AO=0?         ← 回到本次对齐零位
CO=0?         ← 完成后立即关 MOE、清目标
```

观察：Ch9（电机轴连续 Real_Pos）向 AO 目标靠近；Ch0 从 4→0x0B/0x0C(11/12)→0x0D(13 位置保持)，LED 变青色呼吸。当前 24 通道没有单独的目标位置通道，应同时记录已发送命令。
> AO 单位是**电机轴 rad**；输出轴角度 = 电机轴角度 / 8。不得把度数直接作为 AO 发送。

### 17.4 速度/电流/开环测试（按需）

以下三组均按“从 STANDBY 独立启动”书写：先选模式、发送 `CO=1?`，等待 Ch0=4 后再发目标，结束立即 `CO=0?`。不要把括号内说明文字发送到串口。

```text
# 速度模式：输出轴 0.5 rad/s
BO=2?
CO=1?
（等待 Ch0=4）
AO=0.5?
（观察完成）
CO=0?

# 电流/力矩模式：Iq=0.01 A 微小阶跃
BO=1?
CO=1?
（等待 Ch0=4）
AO=0.01?
（观察完成）
CO=0?

# 开环：输出轴速度与 Uq 均显式给定
BO=0?
CO=1?
（等待 Ch0=4）
VO=1?
AO=0.2?
（观察完成）
CO=0?
```

以 `#` 开头的说明和括号内等待/观察文字都不是串口命令，不要发送到电机控制器。

**方向校准（若怀疑三相焊反/方向不对，DOC §8.2）**：完成显式初始化后发送 `BO=0?`、`VO=1?`，再从 `AO=0.2?` 小步增加；看 Ch14 与 Ch1 趋势并记录物理转向。不要仅凭一次观察直接改相线或方向宏，须同时核对电流极性与电角度；校准后先 `CO=0?`。

### 17.5 故障码速查（Ch0 / 红灯快闪时）

| Ch0 | 含义 | 常见原因 | 恢复 |
|-----|---|---|---|
| 14 | 过压 | 电源 >36V 读数饱和/分压故障 | 降电源，`CO=1?` |
| 15 | 欠压 | 电源 <10V / 掉电瞬间 | `CO=1?` |
| 16 | 过温 | 板载 NTC >100℃ 或显示+120(虚焊)；电机 NTC >80℃ | 冷却/补焊，`CO=1?` |
| 17 | 低温 | NTC 读数 <−20℃ | 查 NTC |
| 18 | 过流 | 堵转/加速度过大 | `CO=1?` |
| 19 | 编码器故障 | SPI 线松/磁铁丢/缓存超时 | 查线，`CO=1?` |
| 21 | PWM 计算错误 | 中断超载 | `CO=1?` |
| 22 | 急停 | — | `CO=1?` |

`CO=1?` = 故障复位并重新初始化（重新对齐）→ 回绿灯。

### 17.6 首次闭环安全校准阶梯（重要！防 OCP）

每一组都必须从 **STANDBY（Ch0=0、MOE 关闭）独立启动**：选择模式，发送 `CO=1?`，等待 Ch0=4 后再给一个微小目标，观察完成后立即 `CO=0?`。不得把下一组的 `BO`/`AO` 直接接在上一组运行状态之后，也不得一次连发初始化与目标。

```
0. 静态检查
   上电等待 Ch0=0；手转电机，确认 Ch14 在 0~2π 内连续且方向已记录。

1. 电流/转矩模式
   BO=1?
   CO=1?
   （等待 Ch0=4）
   AO=0.01?
   （只观察 Ch3/Ch4、Ch7、Ch15~Ch23 和物理方向；稳定后才可小步增至 0.02/0.05 A）
   CO=0?

2. 速度模式（重新从 Ch0=0 开始）
   BO=2?
   CO=1?
   （等待 Ch0=4）
   AO=0.5?
   （观察 Ch1/Ch2、Ch3/Ch4；确认低速正方向和无发散）
   CO=0?

3. 位置模式（重新从 Ch0=0 开始）
   BO=3?
   CO=1?
   （等待 Ch0=4）
   AO=0.05?
   （观察 Ch9 向 0.05 rad 靠近及 Ch0 进入 11/12/13；Ch18 是 IW 偏置，不是位置）
   AO=0?
   （位置零目标仍是有效带电目标；确认回零后必须继续执行下一行）
   CO=0?
```

任一组出现反向、振荡、蜂鸣、电流突升、OCP 或故障码时立即停机/断电并保留 Ch15～Ch23 首次冻结快照；一次异常观察不足以直接决定翻转 `Motor_Dir`、`Current_Dir0/1` 或交换相线，必须结合编码器方向、电流极性和 U/V/W 映射共同复核。

### 17.7 首次上电风险提示

- 若绿灯后电机**剧烈振荡/飞转**：立即断电！→ 多为环路方向符号问题（旧工程只验证过开环），按 §8.2 校准 `Motor_Dir`/`Current_Dir`（必要时把 `app_joint.h` 的 `APP_DEFAULT_MODE` 临时改 0 先跑开环）
- 首次对齐时电源若 OCP 跳保护：把 `UserData_Config.h` 的 `USER_ALIGN_UD_RATIO` 从 0.04 再调小（如 0.02）
- 位置环 Kp=7 是保守起步值，整定流程见 §14 后续迭代
