zxs18261/GIM6010/3、SguanFOC库文件/01_需求确认/电机参数_GIM6010.md

# GIM6010-8 电机参数（24V 版，已换算）

> 来源：用户提供官方参数表（24V/48V 两版），本项目默认 **24V 版**。

## 一、原始参数表（24V 版，已记录）
| 项 | 值 |
|---|---|
| 额定电压 | 24 V（范围 12–48 V） |
| 额定功率 | 158.4 W |
| 额定扭矩 | 4.85 N·m（减速后） |
| 堵转扭矩 | 12.39 N·m |
| 减速后额定转速 | 245 rpm（电机端 ≈1960 rpm） |
| 减速后最大转速 | 291.2 rpm（电机端 ≈2329.6 rpm） |
| 额定电流 | 6.6 A |
| 堵转/峰值电流 | 30.47 A |
| 线电阻 | 0.44 Ω |
| 线电感 | 230.77 mH（⚠ 判断应为 µH，见下） |
| 转速常数 Kv | 11.54 rpm/V（输出轴） |
| 扭矩常数 Kt | 0.61 N·m/A（输出轴） |
| 极对数 | **14 对** |
| 减速比 | 8:1（行星，背隙 15 arcmin） |
| 工作温度 | -20 ~ +80 ℃ |

## 二、换算为 SguanFOC UserData_Motor.h 参数（24V）
| 参数 | 换算值 | 依据/假设 |
|---|---|---|
| Poles（极对数） | **14** | 直接（⚠ 注意：旧迁移计划写的 7，以本表 14 对为准） |
| VBUS | **24.0 V** | 额定 24V |
| Rs（相电阻） | **0.22 Ω** | 线电阻 0.44 / 2（Y 接，线=2×相） |
| Ld = Lq（相电感） | **115.4 µH = 1.154e-4 H** | 线电感 230.77/2；**单位按 µH**（见 §三） |
| Flux（磁链） | **≈0.003 Wb（3 mWb，估算）** | 由额定扭矩/电流推得，上机微调（见 §三） |
| Amplifier | **20 V/V** | INA181 A1（硬件已确认） |
| Sampling_Rs | **0.005 Ω** | 5 mΩ 采样电阻（硬件已确认） |
| Current_Num | **2**（BC 相 = IV/IW） | 硬件只采 V/W 相（迁移计划确认） |
| Dcur_MAX / Qcur_MAX | **15 A**（建议） | 量程 ±16.5A，留裕量（见 §三） |
| safe.VBUS_MAX / MIM | **26 V / 20 V** | 24V 系统保护窗（建议，可改） |
| safe.Temp_MAX | **80 ℃** | 工作温度上限 |
| Motor_Dir / PWM_Dir / Encoder_Dir / Current_Dir0/1 | 初值占位，**标定学习后写入 Flash** | 需求① 相序自学习 |

## 三、需确认/说明的 3 点
1. **线电感单位（关键）**：原表"230.77 mH"若按 mH，相电感 115 mH 在 24V/14 极对电机上不合理（额定转速下感抗电压会到上千伏）。**判断应为 230.77 µH**，相电感 = 115.4 µH。请确认原表单位是否为 µH。
2. **磁链 Flux 为估算**：≈3 mWb。规格表 Kv/Kt 存在内部不一致，磁链无法精确反推，先按估算写，**上电后用 SguanFOC 参数辨识/开环校准再微调**。
3. **峰值电流超出采样量程**：电机堵转电流 30.47 A，但本板电流采样量程仅 **±16.5 A**（INA181×20、5 mΩ、1.65V 中点）。→ 电流环实际最大钳位约 15~16 A，无法用到 30 A 峰值。如需更大电流需改采样（换小增益 INA181 或更小采样电阻，属硬件改动）。

## 四、GIM4310 / GIM4305（后续补充）
- 默认用 GIM6010-8；另两款参数待你提供后再补本文件。
