zxs18261/GIM6010/1、SguanFOC库文件/docs/foc/recording-policy.md

# 调试记录与经验沉淀规则

## 目的

让参数、实验和问题解决过程可以追溯，同时避免把某一台电机的偶然现象写成所有FOC工程都必须遵循的规则。

## 信息流

```text
源码/仪表/VOFA/示波器/用户实物反馈
  → 单次调试或校准记录
  → 当前项目档案与阶段状态
  → 在另一工程或有意义差异硬件上复验
  → 用户明确批准后提升到STM32_FOC_Debugging Skill
```

## 记录到哪里

- 固件实际使用的参数：源码配置或有效Flash记录。
- 参数的来源、单位、参考轴和验证状态：[项目配置档案](project-profile.md)。
- 串口和上位机兼容合同：[VOFA通信契约](vofa-contract.md)。
- 一个问题的现象、假设、实验、根因和回归：`debug-records/YYYY-MM-DD-<slug>.md`。
- 一套具体电机/控制板/接线的Flash方向与偏置：`calibrations/<controller-id>-<motor-id>.md`。
- 目前完成到哪个FOC阶段：[阶段状态](stage-status.md)。
- 难以逆转且存在真实取舍的长期决策：`docs/adr/NNNN-<slug>.md`。
- 跨项目通用流程：个人`STM32_FOC_Debugging` Skill；不得保存本项目具体常量。
- 会话交接：`handoff`生成的临时摘要，只链接权威文档，不成为新的事实来源。

## 何时立即更新

- 确认或更正电机、编码器、控制板、极对数、减速比、方向、单位、引脚、频率、限幅或协议。
- 完成一次编译、烧录、带电测试、故障复现、假设否定或回归验证。
- 修改会影响PWM、ADC、母线、Flash、校准、模式、命令或VOFA通道的代码。
- 用户提供新的VOFA、示波器、电源、温度、负载或机械行为证据。
- 更换电机、控制板、编码器安装、三相接线、功率级或FOC库。

如果用户在当前请求中明确“只分析、不修改任何文件”，则本轮不写文档，只在回答中列出应记录的候选项。否则，用户已经授权的代码/实验工作完成后，应同步更新相应文档。

## 证据最低要求

一次台架记录至少包含：日期和操作者、控制板/电机/编码器身份、Git提交与脏差异、构建标识、母线和限流、负载与机械固定、控制模式、命令、仪器与通道、预期信号、实际观测、原始数据路径、结果、停止条件、结论和适用范围。

“能够运行”“比较稳定”“方向正常”不能单独作为证据，必须附数值、波形、日志、重复次数或清晰可复查的观察条件。

## 提升与降级

- `source-confirmed`只有完成当前硬件验证后才能升为`bench-verified`。
- 旧修订台架结果在控制路径、采样、方向、校准或Flash变化后应降为“待当前回归”。
- 一条经验只有跨至少一个有意义变量复验，且写明安全失败行为和适用边界，才能标为`generalized`。
- 后续实验推翻结论时，不删除历史记录；将其标记为`rejected`或`superseded`并链接新证据。
