zxs18261/GIM6010/1、SguanFOC库文件/docs/foc/stage-status.md

# FOC调试阶段状态

最后整理：2026-08-25。状态以当前源码、Git历史和用户反馈综合判断；缺少当前修订台架证据的阶段不得标记完成。

## 当前结论

- HEAD `8928aed`提交信息为“能够开环运行”，并有用户确认该修订曾经能够开环运行：**user-reported / bench evidence incomplete**。
- HEAD之后的脏工作区增加或修改了20 kHz ADC调度、MT6816 DMA缓存、母线测量、首次母线上电校准、Flash持久化和相关安全门控：**source-confirmed**。
- 当前工作区不能继承旧提交的完整实物结论，必须重新进行受限开环回归。

## Stage 0：范围、安全与身份

状态：**部分通过**。

已确认电机、电压、极对数、减速比、编码器侧、速度接口和部分限幅。仍缺控制板唯一身份、当前电机实例身份、实验电源限流、急停能力及允许机械转向的正式记录。

## Stage 1：构建、烧录与可观测性

状态：**源码与历史产物存在，当前工作区待重新验证**。

USART1 921600、36通道VOFA和Keil/EIDE工程均存在；2026-08-25已用Arm Compiler 6.23完成0错误、0警告全量构建，HEX SHA-256为`10368D03DFBD9E6111E8F10F2C0222C0D43DE2D1924D84C27C208F07A07FD644`，仍需与实际烧录记录关联。

## Stage 2：PWM与功率级

状态：**source-confirmed，bench pending**。

TIM1 20 kHz、中心对齐、ARR=4249及PWM失能路径可从源码确认；互补极性、死区、门极驱动使能、Break和硬件故障停机仍需示波器/实物证据。

## Stage 3：ADC、电流与母线

状态：**source-confirmed，bench pending**。

ADC注入Rank、电流拓扑和母线分压可从源码确认；电流偏置、比例、符号、相映射、采样时刻以及母线万用表对比尚未通过。

## Stage 4：编码器反馈

状态：**source-confirmed，bench pending**。

MT6816 14 bit、SPI3 DMA、4 kHz缓存、陈旧检测和角度预测已实现；方向、跨零连续性、速度比例、错误计数和4 kHz实际完成率仍需当前台架数据。

## Stage 5：开环FOC

状态：**旧修订用户确认，当前修订待回归**。

当前实现符合`Ud=0`、AO→Uq、VO→输出轴速度、电角度积分和取模的纯开环FOC语义。下一步必须在限流、低指令、机械安全条件下验证启动、停机、正反转、速度上限、角度连续性和编码器观测方向。

## Stage 6：装配校准与持久化

状态：**source-confirmed，bench反馈未通过，根因待判定**。

母线门控、800 ms对齐、正反电角周期方向检查、PWM释放、Flash签名/CRC/commit和epoch已实现。需验证首次上母线、掉电重载、换固件失效、换电机失效、失败停机和重复性。

2026-08-24用户反馈烧录后未观察到预定位动作、电机轴未动。源码审计表明有效Flash记录会直接进入Ch0=4并主动跳过预定位，而母线未通过10～48 V门控会停在Ch0=3；当前缺少Ch0/Ch12数据，不能把任一候选原因标为根因。详见[故障记录](debug-records/2026-08-24-calibration-no-visible-motion.md)。

后续台架数据为复位后Ch0=`15 → 0`（约2 s），Ch12最终23.15 V、万用表约24 V。状态15是欠压、0是待机；结合首次校准最短约3.2 s，证据支持旧Flash校准记录被加载并跳过预定位。源码同时确认欠压恢复条件方向错误：仍欠压时反而退出到待机。首次低于12 V的ADC样本来源尚待捕获，Stage 6继续判为未通过。

2026-08-25源码已修正上述缺陷：欠压连续20 ms确认、过压最多1 ms、恢复带1 V滞环并稳定1 s；High Loop只允许4～13，14以上故障和自动STANDBY统一清零并关闭MOE。新增Ch21～Ch35用于区分新校准与Flash加载并核对故障零输出。编译已通过，仍须烧录后验证首次新校准、Ch34=0、Ch21结果码和掉电重载。

## Stage 7～9：电流、速度、位置闭环

状态：**未通过**。

源码含控制器参数和模式入口，但电气参数、电流采样、方向、稳定性、带宽、抗饱和、负载和热性能尚无完整当前证据。机械限位归零属于后续机械臂应用层。

## Stage 10～11：系统验证与新工程移植

状态：**未开始**。

需要完成故障注入、热与负载、耐久测试，并在至少一个不同FOC库、板卡、电机或编码器组合的新工程中从零移植，才可将`STM32_FOC_Debugging`提升为稳定版本。

## 下一单步目标

在不修改算法的前提下，先固定当前Git差异和构建产物身份，完成真实编译审计；随后编写一条当前修订的受限开环台架记录，明确母线、限流、AO/VO步进、VOFA通道、通过标准和立即停机条件。
