zxs18261/GIM6010/1、SguanFOC库文件/资料/文档/GIM6010_SguanFOC库设计逻辑框图.md

# GIM6010 SguanFOC 库设计逻辑框图

> **历史参考提示（2026-08-25）**：本文保留2026-08-02时的架构说明，其中约10 kHz高频环、旧状态范围和旧VOFA通道等内容已被后续实现替代。当前20 kHz/1 kHz/4 kHz调度、36通道、装配校准和安全门控见[`docs/foc/ai-development-handoff.md`](../../docs/foc/ai-development-handoff.md)及当前源码。

> 工程：`E:\github\GIM6010\SguanFOC库文件`  
> 库目录：`SguanFOC/`  
> 目的：用「简单 + 复杂」两套框图说明 SguanFOC 的整体设计思路  
> 修订：2026-08-02

---

## 目录

1. [一句话总览](#1-一句话总览)
2. [图一：简单逻辑框图](#2-图一简单逻辑框图)
3. [图二：复杂逻辑框图](#3-图二复杂逻辑框图)
4. [库文件分工](#4-库文件分工)
5. [四档控制模式](#5-四档控制模式)
6. [与开环 / VOFA 的对应关系](#6-与开环--vofa-的对应关系)
7. [修订记录](#7-修订记录)

---

## 1. 一句话总览

SguanFOC 的核心设计是：

**用户只填写 `UserData_*` 硬件接口与参数；库通过三档周期任务完成「采样 → 控制 → SVPWM → 保护/通信」。**

| 任务 | 典型频率 | 入口函数 | 职责 |
|---|---|---|---|
| 主循环 | 尽量快转 | `SguanFOC_main_Loop()` | 上电初始化 + JustFloat 上报 |
| 高频环 | ~10 kHz | `SguanFOC_High_Loop()` | 角度/电流计算 + 模式控制 + SVPWM |
| 低频环 | ~1 kHz | `SguanFOC_Low_Loop()` | 母线/温度保护 + 状态机 |
| 串口事件 | Idle 触发 | `SguanFOC_Printf_Loop()` | 解析 AO/BO/CO 等下行命令 |

全局数据对象：`Sguan`（类型 `SguanFOC_System_STRUCT`，定义于 `SguanFOC.h`，实例在 `SguanFOC.c`）。

---

## 2. 图一：简单逻辑框图

适合先建立整体印象：**用户层 ↔ 内核三任务 ↔ 硬件**。

```mermaid
flowchart TB
    subgraph User["你要对接的部分 UserData_*"]
        UF["UserData_Function.h<br/>读电流/角度/写PWM/串口"]
        UM["UserData_Motor.h<br/>电机参数·模式"]
        UP["UserData_Parameter.h<br/>PID/STA"]
        UC["UserData_UserControl.h<br/>AO调参·VOFA通道"]
    end

    subgraph Core["SguanFOC 内核"]
        MAIN["SguanFOC_main_Loop<br/>初始化 + 上报"]
        HIGH["SguanFOC_High_Loop<br/>约 10kHz：算角度电流 + 控制 + SVPWM"]
        LOW["SguanFOC_Low_Loop<br/>约 1kHz：保护 + 状态机"]
        PRT["SguanFOC_Printf_Loop<br/>串口收命令"]
    end

    subgraph HW["板级硬件"]
        ENC["编码器"]
        ADC["电流ADC"]
        PWM["三相PWM"]
        UART["USART"]
    end

    UF --> ENC & ADC & PWM & UART
    UM & UP --> Core
    UC --> MAIN & PRT

    MAIN --> HIGH
    HIGH -->|"Duty"| UF
    UF -->|"角度/电流"| HIGH
    LOW --> MAIN
    UART --> PRT
    PRT -->|"AO/BO/CO"| UC
    MAIN -->|"JustFloat"| UART
```

### 读法

1. **左边**：你填的“插头”（板级差异都收敛在这里）。  
2. **中间**：库用不同频率切分实时控制与慢速逻辑。  
3. **右边**：电机与通信硬件。  
4. **开环**：High_Loop 使用 `Uq_in` + 电角度做 SVPWM。  
5. **闭环**：同一骨架内增加 PID/STA，不改整体调度结构。

---

## 3. 图二：复杂逻辑框图

适合深入理解：**文件模块、上电流程、High/Low 内部数据流、通信**。

```mermaid
flowchart TB
    subgraph Files["库文件分工"]
        F1["SguanFOC.c/h<br/>总调度·四模式控制"]
        F2["Sguan_SVPWM<br/>逆Park + SVPWM"]
        F3["Sguan_PID / Sguan_STA<br/>电流环/速度环"]
        F4["Sguan_PLL / Sguan_Filter<br/>速度观测·滤波"]
        F5["Sguan_MotorStatus<br/>状态机编号与回调"]
        F6["Sguan_printf<br/>JustFloat 收发"]
        F7["Sguan_IQmath<br/>可选 Q31 定点"]
        F8["Sguan_Optimize<br/>MTPA/弱磁等可选"]
        F9["Sguan_Config ← UserData_Config<br/>周期·开关宏"]
    end

    subgraph Boot["上电 / main_Loop"]
        B0["status = UNINITIALIZED"]
        B1["User_InitialInit<br/>开 PWM/ADC/编码器"]
        B2["User_MotorSet / User_ParameterSet"]
        B3["LPF·PID·PLL Init"]
        B4["电流偏置·定位·角度偏置"]
        B5["status = IDLE 可运行"]
        B0 --> B1 --> B2 --> B3 --> B4 --> B5
    end

    subgraph High["High_Loop ≈10kHz 实时路径"]
        H1["Sguan_Calculate_Loop"]
        H1a["User_Encoder_ReadRad<br/>→ 机械角/电角度/速度"]
        H1b["User_ReadADC_Raw<br/>→ Clarke/Park → Id/Iq"]
        H2["Sguan_GeneratePWM_Loop"]
        H2a["User_UserControl 读给定"]
        H2b{"Sguan.mode"}
        H2c0["0 开环：保留 Uq_in"]
        H2c1["1 电流环：Id/Iq PID → Ud/Uq"]
        H2c2["2 速度环：速度外环→Iq* →电流环"]
        H2c3["3 位置环：位置→速度→电流"]
        H3["SVPWM_Tick<br/>Ud/Uq + sin/cos → Duty"]
        H4["User_PwmDuty_Set"]
        H1 --> H1a & H1b --> H2
        H2 --> H2a --> H2b
        H2b --> H2c0 & H2c1 & H2c2 & H2c3
        H2c0 & H2c1 & H2c2 & H2c3 --> H3 --> H4
    end

    subgraph Low["Low_Loop ≈1kHz 慢路径"]
        L1["User_VBUS / Temp<br/>Data_Protection"]
        L2["Status_Switch<br/>过压欠压过流等"]
        L3["Status_RUN + MotorStatus_Loop<br/>UserData_Status 回调"]
        L1 --> L2 --> L3
    end

    subgraph Comm["通信"]
        C1["main_Loop: User_UserTX → Printf_Loop → UART"]
        C2["UART Idle: Printf_Adjust<br/>AO/BO/CO → User_*_Adjust"]
    end

    B5 -->|"status∈运行区"| High
    B5 --> Low
    B5 --> Comm
    F1 --- High & Low & Boot
    F2 --- H3
    F3 --- H2c1 & H2c2 & H2c3
    F4 --- H1a
    F5 --- L2 & L3
    F6 --- Comm
```

### 设计要点

#### （1）分层清晰

| 层 | 内容 | 原则 |
|----|---|---|
| 用户层 | `UserData_*.h` | 板级差异、参数、调参；不碰库算法内核 |
| 算法/调度层 | `Sguan_*.c` | FOC、滤波、状态机、通信协议 |
| 硬件层 | HAL / BSP | 由用户在 `UserData_Function` 或 BSP 中封装 |

#### （2）时间切片

- **High**：必须短；用 `PWM_Calc` 标志做互斥/看门狗，超时可进 `PWM_CALC_FAULT`。  
- **Low**：保护与状态机，可稍慢；若 High 正在算则本次 Low 可跳过。  
- **main**：初始化一次 + 持续 JustFloat 发送。

#### （3）模式用函数表分发

`SguanFOC.c` 内 `Control_Tick[mode]`：

| mode | 宏 | 控制函数 |
|:----:|----|---|
| 0 | `Velocity_OPEN_MODE` | `Control_Velocity_OPEN` |
| 1 | `Current_SINGLE_MODE` | `Control_Current_SINGLE` |
| 2 | `VelCur_DOUBLE_MODE` | `Control_VelCur_DOUBLE` |
| 3 | `PosVelCur_THREE_MODE` | `Control_PosVelCur_THREE` |

四种模式算完 `Ud_in/Uq_in` 后，**共用** `SVPWM_Tick` → `User_PwmDuty_Set`。

#### （4）状态机门槛

High 中真正跑控制的条件（概念上）：

```text
status > 3 && status < 19   → 运行区（含 IDLE、各运行态、部分保护态处理）
status < 4                  → 未就绪，开环会把 Uq 清零等
status 故障锁定区           → 电压给定清零、停转逻辑
```

常见状态定义见 `Sguan_MotorStatus.h`（如 `UNINITIALIZED=1`、`IDLE=4`）。

#### （5）全局对象 `Sguan`

主要子结构：

| 成员 | 含义 |
|---|---|
| `motor` | 极对数、VBUS、Duty、方向等 |
| `identify` | Ld/Lq/Rs/Flux |
| `foc` | Target_*、Ud/Uq、Duty_u/v/w |
| `current` | Id/Iq、偏置、相电流 |
| `encoder` | 角度、速度、偏置 |
| `safe` | VBUS_MAX/MIN、过流阈值等 |
| `control` | PID/STA 实例 |
| `TXdata` | JustFloat 12 通道 |
| `status` / `mode` | 状态机 / 控制模式 |

---

## 4. 库文件分工

| 文件 | 职责 |
|---|---|
| `SguanFOC.c` / `.h` | 总入口、Calculate/GeneratePWM、四模式、High/Low/main |
| `Sguan_SVPWM.c` | 逆 Park、扇区、占空比 |
| `Sguan_PID.c` | 电流/速度/位置 PI（可选） |
| `Sguan_STA.c` | 速度环超螺旋/STA（可选） |
| `Sguan_PLL.c` | 角度相关速度观测 |
| `Sguan_Filter.c` | 低通等滤波 |
| `Sguan_MotorStatus.c` | 状态码与 `MOTOR_STATUS_xxx_Loop` 分发 |
| `Sguan_printf.c` | JustFloat 帧、AO/BO/CO 解析 |
| `Sguan_IQmath.c` | Q31 定点（`Open_Q31_Calculate`） |
| `Sguan_Optimize.c` | MTPA/弱磁等可选优化 |
| `Sguan_Config.h` | 由 `UserData_Config.h` 宏导入 |
| `UserData_Function.h` | **必须对接**：ADC/编码器/PWM/串口/延时 |
| `UserData_Motor.h` | 电机与安全参数 |
| `UserData_Parameter.h` | 控制器参数 |
| `UserData_UserControl.h` | 实时给定、VOFA 通道、AO/BO/CO |
| `UserData_Status.h` | 状态机信号与各状态回调（灯效等） |
| `UserData_Config.h` | 控制周期 `TIM_T`、Debug/PI/Q31 开关 |

---

## 5. 四档控制模式

```text
给定
  │
  ├─ mode0 开环 ─────────────► Uq_in（人工/VOFA）
  ├─ mode1 电流环 ───────────► Target_Iq → 电流PID → Uq
  ├─ mode2 速度-电流 ────────► Target_Speed → 速度环 → Iq* → 电流PID → Uq
  └─ mode3 位置-速度-电流 ───► Target_Pos → … → Uq
                    │
                    ▼
              SVPWM_Tick(Ud,Uq,θ)
                    │
                    ▼
              User_PwmDuty_Set(Du,Dv,Dw)
```

开环调试时：重点保证「角度可读 + PWM 可写 + `Uq_in` 可设」，电流环接口可后补。

---

## 6. 与开环 / VOFA 的对应关系

### 6.1 开环数据路径

```text
Sguan.mode = Velocity_OPEN_MODE
Sguan.foc.Uq_in = 2.4f   （或 VOFA AO=2.4?）
        │
        ▼
High_Loop
  → Sguan_Calculate_Loop   （User_Encoder_ReadRad → 电角度）
  → Control_Velocity_OPEN  （运行态下保持 Uq_in）
  → SVPWM_Tick
  → User_PwmDuty_Set       （必须实现，否则不转）
```

### 6.2 VOFA 上下行

```text
上行：main_Loop → User_UserTX → Printf_Loop → UART TX DMA → VOFA
下行：UART Idle → Printf_Adjust → User_AO_Adjust → Sguan.foc.Uq_in
```

开环时 VOFA 建议关注：

| 通道 | 典型内容 |
|:----:|---|
| Ch7 | `Uq_in` |
| Ch9/10 | 机械角 rad/deg |
| Ch11 | `mode`（开环应为 0） |
| Ch0 | `status`（运行后应 ≥ IDLE=4） |

### 6.3 常见断点（对照复杂图）

| 断点 | 结果 |
|---|---|
| `User_PwmDuty_Set` 为空 | SVPWM 算了但电机不转 |
| ADC 注入未启动，High_Loop 不进 | 控制环不刷新 |
| `User_AO_Adjust` 未实现 | VOFA 发 AO 无效 |
| `status` 一直 &lt; 4 | 开环会把 `Uq_in` 清零 |
| 编码器未 Init / 读角失败 | 电角度错，抖动或不转 |

---

## 7. 修订记录

| 日期 | 说明 |
|---|---|
| 2026-08-02 | 初版：简单/复杂两套 Mermaid 框图 + 文件分工与开环/VOFA 对照 |

---

<p align="center"><b>SguanFOC：UserData 接硬件，三环任务跑控制，模式表切换开环到三环</b></p>
