zxs18261/GIM6010/1、SguanFOC库文件/资料/文档/GIM6010_电机参数规格书(24V).md

# GIM6010 电机参数规格书（24V 版）

> 数据来源：电机厂家参数表「电机参数 Motor Parameters」  
> 适用型号：**24V 版本**（本工程使用）  
> 文档路径：`E:\github\GIM6010\SguanFOC库文件\资料\文档`

---

## 目录

1. [基本信息](#1-基本信息)
2. [电气参数](#2-电气参数)
3. [机械与减速器参数](#3-机械与减速器参数)
4. [编码器与通信](#4-编码器与通信)
5. [物理尺寸与负载](#5-物理尺寸与负载)
6. [环境与防护](#6-环境与防护)
7. [SguanFOC 参数映射建议](#7-sguanfoc-参数映射建议)
8. [与当前工程默认值对比](#8-与当前工程默认值对比)
9. [修订记录](#9-修订记录)

---

## 1. 基本信息

| 项目 | 24V 版 | 48V 版（参考，本工程不用） |
|---|---|---|
| 额定电压 | **24 V** | 48 V |
| 电压范围 | **12 ~ 48 V** | 12 ~ 48 V |
| 通信协议 | **CAN** | CAN |

> 本工程 GIM6010 使用 **24V 版本**，母线电压建议按 24V 额定配置，安全范围 12~48V。

---

## 2. 电气参数

| 参数 | 英文 | 24V 版数值 | 单位 | 说明 |
|---|---|---|---|---|
| 额定功率 | Rated power | **158.4** | W | |
| 额定扭矩 | Rated torque | **4.85** | N·m | 输出轴（减速后） |
| 堵转扭矩 | Peak torque | **12.39** | N·m | 最大峰值扭矩 |
| 额定电流 | Rated current | **6.6** | A | |
| 堵转电流 | Peak current | **30.47** | A | 最大峰值电流 |
| 线电阻 | Line resistance | **0.44** | Ω | 相线电阻（厂家标称） |
| 线电感 | Line inductance | **230.77** | mH | 相线电感（厂家标称） |
| 转速常数 | Speed constant | **11.54** | rpm/V | 见下方说明 |
| 扭矩常数 | Torque constant | **0.61** | N·m/A | |
| 极对数 | Number of pole pairs | **14** | 对 | FOC 核心参数 |

### 转速常数说明

厂家标称 **11.54 rpm/V**，结合减速后额定转速 245 rpm（24V）推算，该常数 likely 指**输出轴侧**转速与电压的关系：

```
245 rpm / 24 V ≈ 10.2 rpm/V（接近 11.54 rpm/V 量级）
```

电机轴侧（减速前）额定转速：

```
245 rpm × 8（减速比）= 1960 rpm
```

---

## 3. 机械与减速器参数

| 参数 | 英文 | 数值 | 单位 | 说明 |
|---|---|---|---|---|
| 减速比 | Gear rate | **8 : 1** | — | 行星减速 |
| 减速后额定转速 | Rated speed after reduce | **245** | rpm | 输出轴 |
| 减速后最大转速 | Max speed after reduce | **291.2** | rpm | 输出轴 |
| 减速器类型 | Gear type | Planetary | — | 行星齿轮 |
| 减速器齿轮材料 | Reducer gear material | STEEL | — | 钢齿轮 |
| 减速器齿轮背隙 | Reducer gear backlash | **15** | arcmin | 15 角分 |

### 转速换算

| 位置 | 额定转速 | 最大转速 |
|---|---|---|
| 输出轴（减速后） | 245 rpm | 291.2 rpm |
| 电机轴（减速前） | 1960 rpm | 2329.6 rpm |
| 输出轴角速度 | 25.66 rad/s | 30.50 rad/s |
| 电机轴角速度 | 205.3 rad/s | 244.0 rad/s |

---

## 4. 编码器与通信

| 参数 | 英文 | 数值 | 说明 |
|---|---|---|---|
| 通信协议 | Communication | **CAN** | 电机模块对外通信 |
| 板载编码器精度 | Resolution of encoder on driver | **16 bit** | 电机模块内置编码器 |
| 是否支持单独编码器 | Separate encoder | **NO** | 不支持外接独立编码器 |
| 第二编码器（输出轴） | Second encoder on output shaft | **Optional** | 可选配 |
| 定制抱闸 | Custom brakes | **YES** | 支持 |

### 与本工程硬件的关系

| 项目 | 电机规格 | 本工程 PCB | 备注 |
|---|---|---|---|
| 板载编码器 | 16 bit（电机模块内） | MT6816 14 bit 磁编（SPI3） | 若使用 PCB 上 MT6816，分辨率为 2^14 = 16384 |
| 通信 | CAN | FDCAN1（PB8/PB9） | 与规格一致，需实现 CAN 协议 |
| 减速比 | 8:1 | 软件需配置 | 速度/位置环需区分电机轴 vs 输出轴 |

---

## 5. 物理尺寸与负载

| 参数 | 英文 | 数值 | 单位 |
|---|---|---|---|
| 电机重量（不带驱动） | Motor weight without driver | 370.0 | g |
| 电机重量（带驱动） | Motor weight with driver | 388.0 | g |
| 电机尺寸（不带驱动） | Size without driver | Ø80 × 29.5 | mm |
| 电机尺寸（带驱动） | Size with driver | Ø80 × 40 | mm |
| 轴向最大负载 | Max. Axial load | 200 | N |
| 径向最大负载 | Max. Radial load | 800 | N |

---

## 6. 环境与防护

| 参数 | 英文 | 数值 |
|---|---|---|
| 噪音 | Noise | < 60 dB |
| 防水防尘等级 | Protection grade | IP54 |
| 工作温度范围 | Working temperature | -20 ~ +80 °C |

---

## 7. SguanFOC 参数映射建议

以下是将厂家参数映射到 `UserData_Motor.h` / `UserData_Config.h` 的建议值。

### 7.1 UserData_Motor.h — 电机实体参数

```c
// 电机实体参数（24V GIM6010）
Sguan.identify.Ld  = 0.23077f;      // H，线电感 230.77mH（Ld≈Lq，表贴/内嵌需实测区分）
Sguan.identify.Lq  = 0.23077f;      // H
Sguan.identify.Rs  = 0.44f;         // Ω，线电阻
Sguan.identify.Flux = 0.02905f;     // Wb，由 Kt 估算：ψ ≈ Kt / (1.5 × P) = 0.61 / (1.5 × 14)

Sguan.motor.Poles  = 14;            // 极对数（⚠️ 原默认 7 错误）
Sguan.motor.VBUS   = 24.0f;         // V，额定母线（⚠️ 原默认 12 错误）
Sguan.motor.Duty   = 4250;          // 与 TIM1 ARR 一致
```

### 7.2 安全限幅建议

```c
// 安全保护（基于 24V 规格）
Sguan.safe.VBUS_MAX = 48.0f;        // 电压范围上限
Sguan.safe.VBUS_MIN = 12.0f;        // 电压范围下限
Sguan.safe.Dcur_MAX = 30.47f;       // 堵转电流（峰值）
Sguan.safe.Qcur_MAX = 30.47f;
Sguan.safe.Current_limit = 6.6f;    // 额定电流
Sguan.safe.Speed_limit = 25.66f;    // rad/s，输出轴额定角速度 (245rpm)
```

### 7.3 减速比与编码器换算

```c
// 软件常量（建议新建或在 UserData 中定义）
#define GIM6010_GEAR_RATIO      8.0f    // 减速比
#define GIM6010_ENCODER_BITS    14      // MT6816 实际位数（PCB）
// 若使用电机模块 16bit 编码器，改为 16

// 输出轴转速 = 电机轴转速 / GEAR_RATIO
// 输出轴角度 = 电机轴角度 / GEAR_RATIO
```

### 7.4 磁链估算过程

```
扭矩常数 Kt = 0.61 N·m/A
极对数 P = 14

表贴永磁同步电机近似：
  ψ = Kt / (1.5 × P)
    = 0.61 / (1.5 × 14)
    = 0.02905 Wb
    ≈ 29.05 mWb
```

> 磁链建议通过实测反电势或 SguanFOC 参数辨识进一步校准。

### 7.5 电流环 PID 初值参考

基于 $L = 230.77\,\text{mH}$，$R = 0.44\,\Omega$，控制周期 $T_s = 100\,\mu\text{s}$（10 kHz）：

| 参数 | 估算思路 | 建议初值 |
|---|---|---|
| 电流环带宽 | $f_{bw} = R / (2\pi L) \approx 0.3\,\text{Hz}$（很低，电机为大电感） | 需实测调整 |
| Kp | $L \times 2\pi f_{cc} / 1.5$ | 先用厂家/例程默认，再调 |
| Ki | $R \times T_s / 1.5$ | 同上 |

> **注意：** 230.77 mH 电感较大，电流环带宽会较低，响应较慢。若实物测试发现参数偏差大，建议用 LCR 表或 SguanFOC 辨识功能重新测量 L/R。

---

## 8. 与当前工程默认值对比

`UserData_Motor.h` / `UserData_Config.h` 已按本文 §7 写入 24V 规格（2026-08-02）。

| 参数 | 工程当前值 | 24V 规格书 |
|---|---|---|
| 极对数 Poles | 14 | 14 |
| 母线电压 VBUS | 24.0 V | 24.0 V |
| 线电阻 Rs | 0.44 Ω | 0.44 Ω |
| 线电感 Ld/Lq | 0.23077 H | 230.77 mH |
| 磁链 Flux | 0.02905 Wb | ≈29.05 mWb |
| 过流 D/Qcur_MAX | 30.47 A | 堵转 30.47 A |
| 电压限幅 | 12~48 V | 12~48 V |
| PWM Duty | 4250 | 对齐 TIM1 ARR |
| 减速比宏 | `GIM6010_GEAR_RATIO=8` | 8:1 |

---

## 9. 修订记录

| 日期 | 版本 | 说明 |
|---|---|---|
| 2026-08-02 | v1.1 | 参数写入 `UserData_Motor.h` / `UserData_Config.h` / `UserData_Parameter.h` |
| 2026-07-28 | v1.0 | 初版，整理 24V 电机参数表数据 |

**数据来源：** 用户提供的电机参数规格表截图（Motor Parameters，24V/48V 对比表）

---

<p align="center"><b>GIM6010 24V 电机参数 — SguanFOC 配置直接引用本文档</b></p>
