zxs18261/GIM6010/1、SguanFOC库文件/资料/文档/GIM6010_首次母线上电预定位与Flash持久化修改说明.md

# GIM6010 首次母线上电预定位与 Flash 持久化修改说明

## 1. 本次修改结果

当 Flash 中没有与当前固件匹配的校准数据时，控制器上弱电后进入 `MOTOR_STATUS_CALIBRATING`，但三相 PWM 主输出保持关闭，电机不会动。实测功率母线连续高于 10 V 达 200 ms 后，才会执行预定位、相序检查和 Flash 保存。

校准成功后：

- `Ud=0`、`Uq=0`，所有电流/速度/位置目标同时清零。
- TIM1 `MOE` 关闭，三相桥高阻，避免“DQ 为零但 PWM 仍开启”形成动态制动，此时电机应可轻松手动转动。
- 状态进入 `MOTOR_STATUS_IDLE` (`Ch0=4`)。
- 后续上电只重做 ADC 电流零偏采样，直接从 Flash 加载编码器偏置和电机映射，不再转动电机。
- 选定控制模式后，只有实际 `|Ud|` 或 `|Uq|` 达到 0.02 V 时才重新开启 PWM 主输出；两轴都回到零附近时再次进入高阻。

## 2. 完整启动逻辑

```text
MCU 上弱电
  ↓
启动 ADC / TIM / 编码器，关闭 PWM MOE
  ↓
每次上电采集电流零偏
  ↓
读取 0x0801F800 校准记录
  ├─ 魔数/版本/固件签名/数据校验全部通过
  │    ↓
  │  加载 Pos_offset、Encoder_Dir、Motor_Dir、PWM_Dir、电流映射
  │    ↓
  │  DQ/目标清零 + MOE 关闭 → IDLE
  │
  └─ 无记录或校验失败
       ↓
     CALIBRATING，等待 VBUS ≥ 10 V 且稳定 200 ms
       ↓
     固定电角度 0，Ud=0.04×额定 VBUS，保持 800 ms
       ↓
     电角度 0→2π，再 2π→0，根据编码器位移检查相序
       ├─ 方向正确：继续
       ├─ 方向相反：翻转 Motor_Dir，重新拉齐并复测
       └─ 位移不可信：关 PWM，进入 SENSOR_ERROR，不写 Flash
       ↓
     解绕平均编码器角度，得到 Pos_offset
       ↓
     Ud=0、Uq=0，释放 400 ms，关闭 MOE
       ↓
     写 Flash 并回读校验
       ↓
     IDLE
```

## 3. 相序自检的作用与边界

相序检查以 `Encoder_Dir` 定义的机械正方向为基准。固定 d 轴电压不变，强制电角度在 800 ms 内正向走一个电周期，然后反向返回。只有满足下列条件才接受结果：

- 正、反向编码器位移均不小于 0.01 rad。
- 两次位移符号相反。
- 往返位移绝对值的比例不超过 4:1。
- 如果首次方向相反，程序仅翻转 `Motor_Dir`，然后必须复测成功才允许保存。

`Motor_Dir` 在当前 SguanFOC 库中同时控制 SVPWM 的 U/V 交换和 `Ia/Ib/Ic` 映射，因此翻转后的参数是一组一致变更。

这一步能处理“三相线的两相对调”造成的旋转方向相反，但不是完整的电机参数辨识，不会自动识别极对数、电阻、电感或编码器安装零偏以外的故障。

## 4. Flash 数据设计

- MCU：STM32G431CBTx，内部 Flash 128 KiB。
- 程序链接区：`0x08000000 ~ 0x0801F7FF`，Keil IROM 长度由 `0x20000` 改为 `0x1F800`。
- 校准页：第 63 页，`0x0801F800 ~ 0x0801FFFF`，大小 2 KiB。
- 记录内容：编码器偏置、编码器方向、电机相序、PWM 极性、两路电流方向、电流相映射、极对数。
- 有效性：魔数 + 格式/epoch + 当前程序区 FNV-1a 签名 + 记录校验 + 最后提交标志。
- 断电安全：先写数据，最后写 checksum/commit 双字；写到一半断电的记录不会被加载。

程序区内容变化后，固件签名变化，旧校准会自动失效。如果给同一芯片重复烧录完全相同的 HEX，运行时无法从 Flash 内容区分“重新烧录”和“普通重启”。更换电机或要强制重做时，将 `UserData_Config.h` 中 `USER_CALIBRATION_EPOCH` 递增后重新编译烧录，或在下载器中做全片擦除。

## 5. 母线电压采样

主板母线检测网络为 PB11 / ADC1_IN14，R20=30 kΩ，R19=3 kΩ，软件换算为：

```text
VBUS = ADC_raw × 3.3 / 4095 × 11
```

VBUS 现在作为 ADC1 注入组 Rank3，在 20 kHz PWM 采样窗口与 IV/IW 一起锁存，并通过 `alpha=0.01` 的一阶滤波得到母线电压。实物电阻误差、ADC 参考误差会带来比例偏差，台架上应用万用表对比 `VOFA Ch12`，必要时修正 `BSP_VBUS_DIVIDER_GAIN`。

## 6. VOFA 观察与指令门控

当前通讯固定使用 USART1、921600-8N1 和36个JustFloat通道；Ch0～Ch20保持原定义，Ch21～Ch35为后续追加的校准/安全诊断。本次相关的观察量为：

- `Ch0=3`：没有有效 Flash 校准，正在等待母线或执行预定位。
- `Ch0=4`：校准已加载/保存，当前空闲。
- `Ch0=19`：编码器样本超时或错误。
- `Ch0=20`：相序检查位移不可信，或 Flash 保存/回读失败。
- `Ch6`：以20 kHz High_Loop为时基，按相邻两次成功启动UART DMA的间隔换算实际VOFA数据帧发送频率[Hz]，首帧为0；36通道、500 Hz约占921600链路带宽80.3%。
- `Ch10`：当前使用的编码器 `Pos_offset` [rad]。
- `Ch12`：母线显示值[V]；ADC无有效样本时仍回退配置24 V，必须结合Ch25判断。
- `Ch21`：校准结果；3表示本次校准保存成功，4表示从Flash加载并跳过转动。
- `Ch22/Ch23/Ch24`：实际对齐Ud[V]、相序结果、Flash有效标志。
- `Ch25/Ch26`：母线ADC有效标志、复位后未滤波母线最小值[V]。
- `Ch27～Ch35`：方向/相映射、极对数、MOE和当前Ud。

在 `Ch0<=3` 或故障状态时，`AO`、`BO`、`VO` 命令会被忽略，不会预存到校准后执行。`CO=0?` 始终会清零全部目标、进入 `STANDBY` 并关闭 PWM，避免位置环再次恢复输出。原有对 `%f`、`NaN`、`Inf` 和非法命令的拒绝逻辑保持不变。

## 7. 主要修改文件

- `SguanFOC/UserData_Calibration.c/.h`：新增 Flash 记录、固件签名、校验、擦写与回读。
- `SguanFOC/SguanFOC.c`：启动状态机、母线等待、预定位、相序复测、角度解绕平均、DQ/MOE 门控。
- `SguanFOC/UserData_Config.h`：新增母线门限、相序检查参数、PWM 开启阈值与校准 epoch。
- `SguanFOC/UserData_Function.h`：新增真实 VBUS 读取和 TIM1 MOE 开/关接口。
- `SguanFOC/UserData_UserControl.h`：校准/故障期命令拒绝，`CO=0` 高阻停机，Ch12 显示实测 VBUS。
- `BSP/BSP_ADC.c/.h`、`Hardware/Timer.c/.h`、`Core/Src/adc.c`、`GIM6010_V0.0.ioc`：VBUS 注入采样链路。
- `MDK-ARM/GIM6010_V0.0.uvprojx`：加入校准源文件，并从 IROM 中预留最后 2 KiB。
- `MDK-ARM/.eide/eide.yml`：同步加入校准源文件，并将 EIDE 的 IROM 上限设为 `0x1F800`。

## 8. 首次台架验证步骤

1. 电机脱离负载，机械臂未组装，直流电源设置保守电流限制。
2. 烧录新固件，只上弱电。确认 `Ch0=3`、`Ch12≈0 V`，电机不转且手拧无明显制动。
3. 上 24 V 功率母线。电机应先拉齐，然后小角度正转/反转；如需翻转相序，此流程会复测一次。
4. 等待 `Ch0=4`，确认 `Ch7(Uq)=0`，手动转动电机应轻松。
5. 不重新烧录，断电再上电。应直接进入 `Ch0=4`，不再发生拉齐和正反转。
6. 先发 `BO=0?`设置开环模式，再从小值开始发 `AO`/`VO`。例如 `AO=1.5?`、`VO=1.0?`，确认动作方向与编码器正方向一致。

## 9. 编译验证

已使用 EIDE 配置的 ARM Compiler 6 完整重建：

```text
Program Size: Code=52042 RO-data=2814 RW-data=52 ZI-data=5084
Build successfully, 0 warning
```

链接映射中 `LR_IROM1 Max=0x0001F800`，校准页 `0x0801F800` 未被程序段占用。
