zxs18261/GIM6010/2、SguanFOC库文件/资料/文档/GIM6010_引脚与外设对照表.md

# GIM6010 引脚与外设对照表

> 本文档基于硬件网表（`Netlist_Schematic1_1_2026-07-11.tel`）、原理图（`SCH_Schematic1_1_2026-07-11.pdf`）及当前 CubeMX 工程（`GIM6010_V0.0.ioc`）整理。  
> 目的：记录每个 MCU 引脚的硬件连接、功能用途及 CubeMX 配置，后续开发无需重复查阅原始文件。

---

## 目录

1. [芯片与板卡概述](#1-芯片与板卡概述)
2. [引脚总表（按 GPIO 排序）](#2-引脚总表按-gpio-排序)
3. [功能模块详解](#3-功能模块详解)
4. [CubeMX 外设配置速查](#4-cubemx-外设配置速查)
5. [SguanFOC 移植映射](#5-sguanfoc-移植映射)
6. [外部连接器定义](#6-外部连接器定义)
7. [时钟与电源](#7-时钟与电源)
8. [待确认 / 移植注意事项](#8-待确认--移植注意事项)
9. [修订记录](#9-修订记录)

---

## 1. 芯片与板卡概述

| 项目 | 值 |
|---|-----|
| MCU | **STM32G431CBT6** |
| 封装 | LQFP-48 |
| 系统时钟 | HSE 8MHz → PLL → **170 MHz** |
| 硬件版本 | Schematic1_1（2026-07-11） |
| CubeMX 工程 | GIM6010_V0.0.ioc |
| 固件包 | STM32Cube FW_G4 V1.6.3 |

### 板载主要芯片

| 位号 | 功能 | 说明 |
|---|---|---|
| **U1** | STM32G431CBT6 | 主控 MCU |
| **U2** | 栅极驱动器（QFN-24） | 接收 HIN/LIN 信号，驱动三相 MOSFET |
| **U3** | MT6816 | 14 位磁编码器，SPI 接口 |
| **U9** | CAN 收发器（HVSON-8） | FDCAN 物理层 |
| **U15** | 电流采样运放 | V 相电流 → ADC1_IN12 |
| **U16** | 电流采样运放 | 母线 IBUS → ADC2_IN12 |
| **U19** | 电流采样运放 | W 相电流 → ADC1_IN15 |
| **U18** | 1.65V 基准 | 电流采样运放参考电压 |
| **U40** | 电源管理 | 12V → VBUS 降压 |
| **Q1~Q4, Q7, Q13** | N-MOSFET | 三相全桥 |
| **R2, R14, R16** | 5mΩ 采样电阻 | 电流检测 shunt |
| **X1** | 8MHz 晶振 | HSE 外部时钟 |

---

## 2. 引脚总表（按 GPIO 排序）

| LQFP 引脚 | GPIO | 网络名 / 标签 | 连接到（硬件） | 功能说明 | CubeMX 配置 | 代码宏定义 |
|:---:|:----:|:---|:---|:---|:---|:---|
| 5 | PF0 | O_IN | X1（8MHz 晶振） | HSE 外部时钟输入 | RCC → HSE External | — |
| 6 | PF1 | O_OUT | X1（8MHz 晶振） | HSE 外部时钟输出 | RCC → HSE External | — |
| 7 | NRST | NRST | SW1 复位按键 | 系统复位 | 默认 | — |
| 12 | PA2 | ADC1_IN3 | NTC2（板载温度） | 温度采样 1 | ADC1 IN3 Single-Ended | `ADC_NTC1_Pin` |
| 13 | PA3 | ADC1_IN4 | P1 外部接口 | 温度采样 2 / 外部 NTC | ADC1 IN4 Single-Ended | `ADC_NTC2_Pin` |
| 14 | PA4 | CSN | CN47 Pin5 | 外部 SPI 片选 | GPIO_Output | `CSN_Pin` |
| 15 | PA5 | SCK | CN47 Pin4 | 外部 SPI 时钟 | SPI1_SCK | `SCK_Pin` |
| 16 | PA6 | MISO | CN47 Pin3 | 外部 SPI 数据入 | SPI1_MISO | `MISO_Pin` |
| 17 | PA7 | MOSI | CN47 Pin2 | 外部 SPI 数据出 | SPI1_MOSI | `MOSI_Pin` |
| 18 | PB0 | ADC1_IN15 | U19（IW 相电流运放） | W 相电流采样 | ADC1 IN15 Single-Ended | `ADC_IW_Pin` |
| 19 | PB1 | ADC1_IN12 | U15（IV 相电流运放） | V 相电流采样 | ADC1 IN12 Single-Ended | `ADC_IV_Pin` |
| 20 | PB2 | ADC2_IN12 | U16（IBUS 运放） | 母线电流采样 | ADC2 IN12 Single-Ended | `ADC_IBUS_Pin` |
| 22 | PB11 | ADC1_IN14 | R19/R20 分压 | 母线电压 VBUS 采样 | ADC1 IN14 Single-Ended | `ADC_VBUS_Pin` |
| 26 | PB13 | LIN_W | U2 Pin3（驱动器 W 低侧） | W 相低侧 PWM | TIM1_CH1N | `LIN_W_Pin` |
| 27 | PB14 | LIN_V | U2 Pin2（驱动器 V 低侧） | V 相低侧 PWM | TIM1_CH2N | `LIN_V_Pin` |
| 28 | PB15 | LIN_U | U2 Pin1（驱动器 U 低侧） | U 相低侧 PWM | TIM1_CH3N | `LIN_U_Pin` |
| 29 | PA8 | HIN_W | U2 Pin24（驱动器 W 高侧） | W 相高侧 PWM | TIM1_CH1 | `HIN_W_Pin` |
| 30 | PA9 | HIN_V | U2 Pin23（驱动器 V 高侧） | V 相高侧 PWM | TIM1_CH2 | `HIN_V_Pin` |
| 31 | PA10 | HIN_U | U2 Pin22（驱动器 U 高侧） | U 相高侧 PWM | TIM1_CH3 | `HIN_U_Pin` |
| 32 | PA11 | GPIO_KEY | SW2 用户按键 | 用户按键 KEY1 | GPIO_Input | `KEY1_Pin` |
| 33 | PA12 | RGB | LED1 RGB 灯 | 状态指示灯 PWM | TIM4_CH2 | `RGB_Pin` |
| 34 | PA13 | DIO | CN9 Pin5 | SWD 数据线 / 调试口 | SYS_JTMS-SWDIO | — |
| 35 | PA14 | CLK | CN9 Pin4 | SWD 时钟线 / 调试口 | SYS_JTCK-SWCLK | — |
| 36 | PA15 | GPIO_CSN3 | U3 Pin1（MT6816 CSN） | 磁编码器片选 | GPIO_Output | `MT6816_CSN_Pin` |
| 37 | PB3 | MT6816_SCK | U3 Pin7 | 磁编码器 SPI 时钟 | SPI3_SCK | `MT6816_SCK_Pin` |
| 38 | PB4 | MT6816_MISO | U3 Pin6 | 磁编码器 SPI 数据入 | SPI3_MISO | `MT6816_MISO_Pin` |
| 39 | PB5 | MT6816_MOSI | U3 Pin5 | 磁编码器 SPI 数据出 | SPI3_MOSI | `MT6816_MOSI_Pin` |
| 40 | PB6 | TX | CN9 Pin3 | 串口发送 | USART1_TX | — |
| 41 | PB7 | RX | CN9 Pin2 | 串口接收 | USART1_RX | — |
| 42 | PB8 | CAN_RX | U9 Pin4（CAN 收发器） | CAN 接收 | FDCAN1_RX | — |
| 43 | PB9 | CAN_TX | U9 Pin1（CAN 收发器） | CAN 发送 | FDCAN1_TX | — |

### 未使用的 MCU 引脚

| GPIO | 状态 |
|---|---|
| PA0, PA1 | 未连接（LQFP-48 未引出或未用） |
| PB10, PB12 | 未使用 |
| PC13, PC14, PC15 | LQFP-48 未引出 |

---

## 3. 功能模块详解

### 3.1 三相 PWM 驱动（TIM1 → 栅极驱动器 U2）

```
MCU TIM1                    栅极驱动 U2              MOSFET 半桥
─────────────────────────────────────────────────────────────────
PA8  TIM1_CH1  (HIN_W)  →  U2.24  →  HOW  →  W 相上桥
PA9  TIM1_CH2  (HIN_V)  →  U2.23  →  HOV  →  V 相上桥
PA10 TIM1_CH3  (HIN_U)  →  U2.22  →  HOU  →  U 相上桥
PB13 TIM1_CH1N (LIN_W)  →  U2.3   →  LOW  →  W 相下桥
PB14 TIM1_CH2N (LIN_V)  →  U2.2   →  LOV  →  V 相下桥
PB15 TIM1_CH3N (LIN_U)  →  U2.1   →  LOU  →  U 相下桥
TIM1_CH4 (无输出)       →  触发 ADC 注入采样
```

| 参数 | 值 | 说明 |
|---|-----|---|
| 计数模式 | Center Aligned Mode 1 | 中心对齐，适合 FOC |
| Prescaler | 0 | 无预分频 |
| Period (ARR) | 4250 | 满占空比基准 |
| Dead Time | 9 | 死区时间 |
| CH4 模式 | PWM2，无引脚输出 | 用于 TRGO → ADC 触发 |
| Master Output | TIM_TRGO_OC4REF | 触发 ADC1 注入转换 |
| PWM 频率 | ≈ 20 kHz | 170MHz / (2×4250) |

**SguanFOC 对应：**
- `User_PwmDuty_Set()` → 写 TIM1 CH1/CH2/CH3 比较值
- `Sguan.motor.Duty = 4250`（`UserData_Motor.h`）
- `SguanFOC_High_Loop()` → 挂 TIM1 更新/比较中断

---

### 3.2 电流采样（双电阻 + 母线检测）

采用**下桥臂双电阻采样**方案：采 V 相、W 相电流，U 相由 $I_U = -(I_V + I_W)$ 推算。

| ADC 通道 | GPIO | 采样信号 | 硬件来源 | 转换类型 | 触发方式 |
|---|---|---|---|---|---|
| ADC1_IN12 | PB1 | IV | U15 运放（V 相 shunt R14） | **注入** Rank1 | TIM1_CC4 上升沿 |
| ADC1_IN15 | PB0 | IW | U19 运放（W 相 shunt R16） | **注入** Rank2 | TIM1_CC4 上升沿 |
| ADC2_IN12 | PB2 | IBUS | U16 运放（母线 shunt R2） | 常规 Rank1 | 软件触发 |
| ADC1_IN14 | PB11 | VBUS | R19/R20 电阻分压 | 常规 Rank1 | 软件触发 |
| ADC1_IN3 | PA2 | NTC1 | NTC2 热敏电阻 | 常规 Rank2 | 软件触发 |
| ADC1_IN4 | PA3 | NTC2 | P1 外部 NTC | 常规 Rank3 | 软件触发 |

**电流采样硬件参数（默认值）：**

| 参数 | 值 | 位置 |
|---|-----|---|
| 采样电阻 | 5 mΩ | R2 / R14 / R16 |
| 运放增益 | 10 倍 | U15 / U16 / U19 |
| ADC 精度 | 12 位 (4096) | — |
| ADC 基准 | 3.3 V | MCU VDDA |
| 运放参考 | 1.65 V | U18 产生 |
| 电流通道配置 | `Current_Num = 1` | 1 = AC 相（Iv + Iw） |

**SguanFOC 对应：**
```c
// User_ReadADC_Raw 映射建议
case 0: return ADC1_InjectedRank1;  // Iv (PB1, ADC1_IN12)
case 1: return ADC1_InjectedRank2;  // Iw (PB0, ADC1_IN15)
```

---

### 3.3 磁编码器 MT6816（SPI3）

| 信号 | GPIO | 连接到 | 说明 |
|---|---|---|---|
| CSN | PA15 | U3 Pin1 | 软件片选，低有效 |
| SCK | PB3 | U3 Pin7 | SPI3 时钟 |
| MISO | PB4 | U3 Pin6 | SPI3 数据输入 |
| MOSI | PB5 | U3 Pin5 | SPI3 数据输出 |

| 参数 | 当前 CubeMX 值 | **建议值（移植时修改）** |
|---|---|---|
| SPI 模式 | Master | Master |
| 数据位宽 | **4 Bit** ⚠️ | **16 Bit** |
| 时钟极性 | CPOL=Low | CPOL=Low |
| 时钟相位 | CPHA=1Edge | CPHA=1Edge |
| 预分频 | /4 (42.5MHz) | /8 ~ /16（MT6816 最高 25MHz） |
| NSS | Soft | Soft（PA15 手动控制） |

**SguanFOC 对应：**
- `User_Encoder_ReadRad()` → SPI3 读 MT6816 14 位角度 → 转换为 0~2π 弧度
- `Sguan.motor.Encoder_Dir` → 根据实物方向设为 1 或 -1

---

### 3.4 外部 SPI 接口（SPI1 → CN47）

| 信号 | GPIO | CN47 引脚 | 说明 |
|---|---|---|---|
| MOSI | PA7 | Pin2 | 数据出 |
| MISO | PA6 | Pin3 | 数据入 |
| SCK | PA5 | Pin4 | 时钟 |
| CSN | PA4 | Pin5 | 片选 |

用于外接 SPI 设备扩展，与 MT6816 独立。

---

### 3.5 串口调试（USART1 → CN9）

| 信号 | GPIO | CN9 引脚 | 说明 |
|---|---|---|---|
| TX | PB6 | Pin3 | 发送 |
| RX | PB7 | Pin2 | 接收 |

| 参数 | 值 |
|---|-----|
| 波特率 | 921600 |
| 数据位 | 8 |
| 停止位 | 1 |
| 校验 | 无 |
| DMA | TX → DMA1_Ch1，RX → DMA1_Ch2 |

**用途：** SguanFOC JustFloat 上位机调试、printf 重定向。

---

### 3.6 CAN 通信（FDCAN1 → U9 → U116）

| 信号 | GPIO | 连接到 | 说明 |
|---|---|---|---|
| RX | PB8 | U9 Pin4 | CAN 接收 |
| TX | PB9 | U9 Pin1 | CAN 发送 |

| 参数 | 值 |
|---|-----|
| 帧格式 | Classic CAN |
| 波特率 | ≈ 3.54 Mbps（Nominal） |
| 终端电阻 | R96 = 120Ω（CAN_H / CAN_L） |
| 外部接口 | U116（XT30 4P 连接器） |

**用途：** 后期 CAN 总线通信，FOC 首启阶段建议暂不使用。

---

### 3.7 用户 IO

| 信号 | GPIO | 硬件 | CubeMX | 用途 |
|---|---|---|---|---|
| KEY1 | PA11 | SW2 按键 | GPIO_Input | 用户按键 |
| RGB | PA12 | LED1 RGB | TIM4_CH2 PWM | 状态指示灯 |
| NRST | Pin7 | SW1 按键 | — | 硬件复位 |

---

## 4. CubeMX 外设配置速查

### 4.1 外设启用列表

| 外设 | 状态 | 用途 |
|---|---|---|
| ADC1 | ✅ | 电流注入采样 + VBUS/NTC 常规采样 |
| ADC2 | ✅ | IBUS 常规采样 |
| TIM1 | ✅ | 三相 PWM + ADC 触发 |
| TIM4 | ✅ | RGB LED PWM（**低频环需另配或改 Period**） |
| SPI1 | ✅ | 外部 SPI（CN47） |
| SPI3 | ✅ | MT6816 磁编码器 |
| USART1 | ✅ | 调试串口 + DMA |
| FDCAN1 | ✅ | CAN 总线 |
| DMA | ✅ | USART1 TX/RX |

### 4.2 ADC1 详细配置

```
模式：Independent（独立模式）
分辨率：12 Bit
扫描：Enable（常规通道扫描）

【注入通道 — FOC 电流环】
  Rank1: ADC1_IN12 (PB1) → Iv
  Rank2: ADC1_IN15 (PB0) → Iw
  触发：TIM1_CC4 上升沿
  采样时间：47.5 Cycles

【常规通道 — 慢速采样】
  Rank1: ADC1_IN14 (PB11) → VBUS
  Rank2: ADC1_IN3  (PA2)  → NTC1
  Rank3: ADC1_IN4  (PA3)  → NTC2
  触发：软件启动
  采样时间：47.5 Cycles
```

### 4.3 TIM1 详细配置

```
Mode：Center Aligned Mode 1
Prescaler：0
Period：4250
Clock Division：DIV2
Dead Time：9
Break：Disable
Automatic Output：Enable

CH1/CH1N：PWM Generation → HIN_W / LIN_W
CH2/CH2N：PWM Generation → HIN_V / LIN_V
CH3/CH3N：PWM Generation → HIN_U / LIN_U
CH4：PWM2 No Output → ADC Trigger (OC4REF)

Master Output Trigger：OC4REF
中断：BRK / UP / TRG_COM / CC 均已 Enable
```

### 4.4 TIM4 详细配置

```
Mode：Up Counter
Prescaler：0
Period：65535
CH2：PWM → RGB LED (PA12)

⚠️ 当前 TIM4 未配置为 SguanFOC 低频环定时器。
   移植时需修改 Period 产生 1kHz 左右中断，或改用其他定时器。
   建议：Prescaler=169, Period=999 → 170MHz/170/1000 = 1kHz
```

### 4.5 SPI 详细配置

```
SPI1（外部 SPI）：
  Mode: Master, Full-Duplex, Soft NSS
  Prescaler: /4, DataSize: 4Bit ⚠️

SPI3（MT6816）：
  Mode: Master, Full-Duplex, Soft NSS
  Prescaler: /4, DataSize: 4Bit ⚠️
  → 移植时必须改为 16Bit
```

### 4.6 USART1 详细配置

```
Mode: Asynchronous
BaudRate: 921600
Word Length: 8 Bits
Stop Bits: 1
Parity: None
DMA: TX=DMA1_Ch1, RX=DMA1_Ch2
```

### 4.7 FDCAN1 详细配置

```
Frame Format: Classic CAN
Mode: Normal
Nominal Prescaler: 16
Nominal TimeSeg1: 1, TimeSeg2: 1
→ 计算波特率 ≈ 3.54 Mbps
```

### 4.8 RCC 时钟树

```
HSE：8 MHz（X1 晶振）
PLL：M=÷2, N=×85, R=÷2
SYSCLK：170 MHz（PLL）
AHB：170 MHz
APB1：170 MHz（Timer 时钟 = 170 MHz）
APB2：170 MHz（Timer 时钟 = 170 MHz）
ADC12 Clock：SYSCLK
```

### 4.9 NVIC 中断优先级

| 中断 | 优先级 | 用途 |
|---|---|---|
| ADC1_2 | 1 | ADC 转换完成 |
| TIM1_BRK / UP / TRG / CC | 0 | **SguanFOC 高频环** |
| DMA1_Ch1 / Ch2 | 0 | USART DMA |
| SysTick | 15 | HAL 时基 |

---

## 5. SguanFOC 移植映射

### 5.1 UserData_Function.h 接口对照

| 库函数 | 硬件实现 | 引脚/外设 |
|---|---|---|
| `User_InitialInit()` | 启动 TIM1 PWM、SPI3、ADC 注入 | TIM1, SPI3, ADC1 |
| `User_ReadADC_Raw(0)` | 读注入 Rank1 | PB1 → Iv |
| `User_ReadADC_Raw(1)` | 读注入 Rank2 | PB0 → Iw |
| `User_Encoder_ReadRad()` | SPI3 读 MT6816 | PA15(CSN) + PB3/4/5 |
| `User_PwmDuty_Set(u,v,w)` | 写 TIM1 CCR1/2/3 | PA8/9/10 + PB13/14/15 |
| `User_VBUS_DataGet()` | 读 ADC1_IN14 常规 | PB11 |
| `User_Temperature_DataGet()` | 读 ADC1_IN3 常规 | PA2 |
| `User_Delay(ms)` | HAL_Delay | — |

### 5.2 中断挂接

| SguanFOC 函数 | 挂接中断 | 频率建议 |
|---|---|---|
| `SguanFOC_High_Loop()` | TIM1_UP_TIM16_IRQHandler | 10~20 kHz |
| `SguanFOC_Low_Loop()` | TIM4_IRQHandler（需改 Period） | 1 kHz |
| `SguanFOC_Printf_Loop()` | USART1_IRQHandler | 事件触发 |
| `SguanFOC_main_Loop()` | main while(1) | 后台循环 |

### 5.3 电机参数默认值（UserData_Motor.h）

| 参数 | 默认值 | 说明 |
|---|---|---|
| Poles | 7 | 极对数，需与 GIM6010 电机一致 |
| VBUS | 12.0 V | 母线电压 |
| Duty | 4249 | PWM 满量程 ≈ TIM1 ARR |
| Current_Num | 1 | AC 相采样（Iv + Iw） |
| Sampling_Rs | 0.005 Ω | 5 mΩ shunt |
| Amplifier | 10.0 | 运放增益 |
| ADC_Precision | 4096 | 12 位 ADC |
| MCU_Voltage | 3.3 V | ADC 基准 |

---

## 6. 外部连接器定义

### 6.1 CN9 — 调试/通信接口（6P JST 1.25mm）

| Pin | 信号 | GPIO | 说明 |
|-----|---|---|---|
| 1 | AGND | — | 地 |
| 2 | RX | PB7 | USART1 接收 |
| 3 | TX | PB6 | USART1 发送 |
| 4 | CLK | PA14 | SWD 时钟 |
| 5 | DIO | PA13 | SWD 数据 |
| 6 | VCC | — | 3.3V |

### 6.2 CN47 — 外部 SPI 接口（6P JST 1.25mm）

| Pin | 信号 | GPIO | 说明 |
|-----|---|---|---|
| 1 | AGND | — | 地 |
| 2 | MOSI | PA7 | SPI1 数据出 |
| 3 | MISO | PA6 | SPI1 数据入 |
| 4 | SCK | PA5 | SPI1 时钟 |
| 5 | CSN | PA4 | SPI1 片选 |
| 6 | VCC | — | 3.3V |

### 6.3 U116 — 电源接口（XT30 4P）

| Pin | 信号 | 说明 |
|-----|---|---|
| 1 | VBUS | 电源正（经 U40 降压） |
| 2 | PGND | 功率地 |
| 3 | CAN_L | CAN 低 |
| 4 | CAN_H | CAN 高 |

### 6.4 电机相线接口

| 测试点 | 相线 | 连接到 |
|---|---|---|
| P3 | V | Q1/Q2 MOSFET 中点 |
| P4 | W | Q7/Q13 MOSFET 中点 |
| P5 | U | Q3/Q4 MOSFET 中点 |

---

## 7. 时钟与电源

### 7.1 电源轨

| 电源 | 电压 | 来源 | 用途 |
|---|---|---|---|
| 12V | 12 V | 外部输入 / U116 | 驱动器电源 |
| VBUS | ~12 V | U40 降压输出 | 电机母线 |
| VCC | 3.3 V | LDO | MCU / 数字逻辑 |
| AVCC | 3.3 V | 经 L2 滤波 | MCU 模拟供电 |
| 1V65 | 1.65 V | U18 | 电流运放参考 |

### 7.2 时钟

| 时钟源 | 频率 | 用途 |
|---|---|---|
| HSE (X1) | 8 MHz | 主时钟源 |
| PLL | 170 MHz | SYSCLK |
| HSI | 16 MHz | 备用 |
| HSI48 | 48 MHz | USB/CAN 可选 |

---

## 8. 待确认 / 移植注意事项

### ⚠️ 必须在移植时修改

| 项目 | 当前状态 | 需要改为 |
|---|---|---|
| SPI3 DataSize | 4 Bit | **16 Bit**（MT6816 要求） |
| SPI1 DataSize | 4 Bit | 按外设需求设置 |
| TIM4 Period | 65535（仅 RGB） | 改为 1kHz 低频环定时 |
| main.c | 无 SguanFOC 调用 | 添加 `SguanFOC_main_Loop()` |
| stm32g4xx_it.c | 无 SguanFOC 中断 | 挂接 High/Low/Printf Loop |
| UserData_Function.h | 注释模板 | 实现全部硬件接口 |

### ⚠️ 需实物确认

| 项目 | 说明 |
|---|---|
| 电机极对数 | 默认 7，需与 GIM6010 电机一致 |
| 编码器方向 | `Encoder_Dir = ±1`，上电后测试 |
| 电流采样方向 | `Current_Dir0/1 = ±1`，手动转轴验证 |
| PWM 方向 | `PWM_Dir = ±1`，开环测试确认 |
| VBUS 分压比 | R19/R20 决定，`User_VBUS_DataGet()` 需标定 |
| 驱动器使能 | 网表中 U2 可能无需 MCU 控制 SD 脚，需确认原理图 |

### 📋 CubeMX 重新生成时注意

- 修改 `.ioc` 后重新 Generate Code，**USER CODE 区域内容会保留**
- 不要手动改 `tim.c` / `adc.c` 等生成文件，统一在 CubeMX 中修改
- SPI DataSize 和 TIM4 Period 建议在 CubeMX 中一次性改好

---

## 9. 修订记录

| 日期 | 版本 | 说明 |
|---|---|---|
| 2026-07-28 | v1.0 | 初版，基于网表 + CubeMX 工程整理 |

**数据来源：**
- `资料/硬件资料/硬件电路板相关文件/Netlist_Schematic1_1_2026-07-11.tel`
- `资料/硬件资料/硬件电路板相关文件/SCH_Schematic1_1_2026-07-11.pdf`
- `GIM6010_V0.0.ioc`
- `Core/Inc/main.h`

---

<p align="center"><b>GIM6010 引脚对照表 — 一次整理，后续开发直接查阅本文档</b></p>
