zxs18261/GIM6010/1、SguanFOC库文件/docs/foc/README.md

# GIM6010 FOC文档中心

这里保存GIM6010电机控制器的当前项目事实和可追溯调试证据。新AI或新工程师先读接入交接，再按任务读取权威文档；不要先从历史聊天或旧专项指南推断当前实现。

## 文档导航

- [AI快速接入与开发交接](ai-development-handoff.md)：五分钟接入、当前设计流程、关键源码索引、开发验证闭环和下一位AI请求模板。
- [项目术语](CONTEXT.md)：统一电机轴、输出轴、电角度、开环转矩作用量等词义。
- [项目配置档案](project-profile.md)：硬件、电机、编码器、采样、控制频率、限幅及未知项。
- [VOFA通信契约](vofa-contract.md)：921600串口、命令语义、36个JustFloat通道和带宽。
- [控制与源码映射](control-and-library-map.md)：SguanFOC数据流、时基、模式及源码入口。
- [阶段状态](stage-status.md)：当前最高可信阶段、已验证项和下一阶段门控。
- [记录与沉淀规则](recording-policy.md)：何时更新参数、问题、校准、ADR和Skill。
- [Skill使用说明](skill-usage.md)：自动触发、显式调用、多Skill组合和授权边界。
- [调试记录](debug-records/README.md)：现象、假设、实验、根因和回归证据。
- [装配校准记录](calibrations/README.md)：Flash实例与电机/控制板/接线身份。
- [记录模板](templates/)：阶段、故障和校准记录模板。

## 单一事实来源

- 运行时配置：当前源码、`GIM6010_V0.0.ioc`和有效Flash记录。
- 项目参数解释及验证状态：[项目配置档案](project-profile.md)。
- 串口与通道合同：[VOFA通信契约](vofa-contract.md)。
- 当前调试完成度：[阶段状态](stage-status.md)。
- 单次现象与原始证据：`debug-records/`及其中引用的VOFA/示波器文件。
- 长期不可轻易更改的理由：`docs/adr/`。
- AI始终需要知道的简短路由：`.cursor/rules/`，规则只链接这里，不复制全部参数。

## 既有详细资料

以下文件保留专项背景和实现细节；使用时仍需与当前源码及本目录的证据状态核对：

- [24V电机参数规格书](<../../资料/文档/GIM6010_电机参数规格书(24V).md>)
- [VOFA调试对接指南](../../资料/文档/GIM6010_VOFA调试对接指南.md)
- [MT6816调试问题与经验总结](../../资料/文档/GIM6010_MT6816调试问题与经验总结.md)
- [首次母线上电预定位与Flash持久化修改说明](../../资料/文档/GIM6010_首次母线上电预定位与Flash持久化修改说明.md)
- [SguanFOC库设计逻辑框图（历史参考）](../../资料/文档/GIM6010_SguanFOC库设计逻辑框图.md)
- [SguanFOC AI辅助移植操作指南（历史参考）](../../资料/文档/GIM6010_SguanFOC_AI辅助移植操作指南.md)
- [CubeMX引脚与外设配置指南](../../资料/文档/GIM6010_CubeMX引脚与外设配置指南.md)
- [引脚与外设对照表](../../资料/文档/GIM6010_引脚与外设对照表.md)
- [BSP板级支持编写指南](../../资料/文档/GIM6010_BSP板级支持编写指南.md)
- [位置环稳定运行计划与性能评估](../../资料/文档/GIM6010_位置环稳定运行实施计划与性能优化评估.md)

## 证据标签

- **bench-verified**：在写明的硬件、固件和供电条件下重复通过。
- **source-confirmed**：当前源码或配置明确如此，但尚未完成当前修订实物验证。
- **user-reported**：用户确认曾在某一修订观察到，尚缺完整原始条件或当前回归。
- **hypothesis**：有预测和验证方法，尚无结论。
- **rejected**：实验已否定，保留以免重复走弯路。
- **hardware-specific**：只适用于指定板、电机、编码器安装或接线。
- **generalized**：至少跨一个有意义差异的工程复验，且适用边界明确。

## 更新触发

- 修改参数、单位、方向、引脚、频率、限幅或协议：同步更新项目档案及相关契约。
- 完成一次带电实验：新增调试或阶段记录，并更新阶段状态。
- 生成或失效一份Flash校准：新增校准实例记录。
- 确认一个难以逆转且存在真实取舍的决策：新增或替代ADR。
- 发现跨项目可复用经验：先记录候选；只有用户明确要求且完成复验后才更新个人Skill。
