zxs18261/GIM6010/3、SguanFOC库文件/02_设计文档/01_CAN协议帧编码表.md

# 01 CAN 协议帧编码表（草案 v1，待确认）

> 这是最容易写乱的部分，请逐行确认。确认后据此写代码并冻结到 `03_工程归档`。

## 一、基本约定
| 项 | 约定 |
|---|---|
| 外设 | FDCAN1，经典 CAN（非 FD），**1 Mbps** |
| 帧格式 | 11 位标准帧，**DLC 固定 = 8** |
| 节点号 | 0..31（宏 `CAN_MAX_NODES=32`），**节点 0 = 协调者 COORDINATOR** |
| 字节序 | 多字节数值一律**小端**（与 STM32 / JustFloat 一致） |
| 心跳 | **必须发**（ID 冲突检测与在线诊断的基础，不砍） |

## 二、ID 规划
统一规则：`CAN_ID = (功能码 << 5) | 节点号`，功能码 0~8，节点号 0~31。

| 帧类型 | 功能码 | ID | 方向 | 周期 / 触发 |
|---|---|---|---|---|
| 请求 Request | 0 | 0x000（广播） | 任意节点 → 总线 | 按键/上电无 ID 时 |
| 授予 Grant | 1 | 0x020（广播） | 协调者 → 总线 | 收到请求 |
| 拒绝 Reject | 2 | 0x040（广播） | 协调者 → 总线 | 总线满 / 冲突 |
| 协调者心跳 CoordHB | 3 | 0x060（广播） | 协调者 → 总线 | **100 ms** |
| 节点心跳 NodeHB | 4 | 0x080+N | 节点 N → 总线 | **500 ms** |
| 冲突通知 Conflict | 5 | 0x0A0+N | 节点 N → 总线 | 检测到冲突 |
| 业务下发 CMD | 6 | 0x0C0+N | 协调者 → 节点 N | 上位机指令 |
| 业务回传 TELE | 7 | 0x0E0+N | 节点 N → 协调者 | 500 ms / 按需 |
| 管理 MGMT | 8 | 0x100+N | 协调者 → 节点 N | 上位机指令 |

## 三、各帧数据区（Byte0~7，小端）

### Request（0x000，广播）
| B0 | B1..B2 | B3..B7 |
|---|---|---|
| 0x01 | 随机请求 token（16bit，用于回显关联） | 0 |

### Grant（0x020，广播）
| B0 | B1 | B2..B3 | B4..B5 | B6 | B7 |
|---|---|---|---|---|---|
| 0x02 | 新分配 ID | 请求 token 回显 | 会话 token（协调者分配，存 Flash） | 0xAA 有效 | 0 |

### Reject（0x040，广播）
| B0 | B1 | B2..B3 | B4..B7 |
|---|---|---|---|
| 0x03 | 原因（1=总线满，2=ID 冲突） | 请求 token（若有） | 0 |

### CoordHB（0x060，广播，来自节点 0）
| B0 | B1 | B2..B5 | B6 | B7 |
|---|---|---|---|---|
| 0x04 | 协调者状态（0 正常） | 在线节点掩码（32bit 小端，bitN=节点 N 在线） | 心跳计数（自增） | 已分配节点数 |

### NodeHB（0x080+N）
| B0 | B1 | B2 | B3 | B4 | B5..B6 | B7 |
|---|---|---|---|---|---|---|
| 0x05 | 状态（0运行/1故障/2标定中/3学习中/4未分配） | 错误码 | 心跳计数（自增） | 当前模式 | 会话 token | 0 |

### Conflict（0x0A0+N）
| B0 | B1 | B2 | B3..B7 |
|---|---|---|---|
| 0x06 | 冲突的 ID | 本节点 ID | 0 |

### CMD（0x0C0+N，协调者→节点）
| B0 | B1 | B2..B5 | B6 | B7 |
|---|---|---|---|---|
| 0x07 | 目标类型 | float 目标值（小端） | 模式 | 序列号 |

目标类型（B1）：`0=电流Iq` `1=速度` `2=位置` `3=使能(停)` `4=触发标定` `5=恢复出厂` `6=进PID调参`

### TELE（0x0E0+N，节点→协调者）
| B0 | B1 | B2..B5 | B6 | B7 |
|---|---|---|---|---|
| 0x08 | 状态 | float 实际值（小端，模式相关：速度/位置） | 模式 | 序列号 |

### MGMT（0x100+N，协调者→节点）
| B0 | B1 | B2..B7 |
|---|---|---|
| 0x09 | 子命令（1=触发标定，2=清除ID，3=恢复出厂） | 参数/0 |

## 四、冲突检测机制
1. 协调者在 Grant 时为每个节点生成唯一**会话 token**（16bit），存于协调者表 + 节点 Flash。
2. 节点每次 NodeHB 携带该 token；协调者维护 `ID → token` 表。
3. 协调者收到 `ID=n` 心跳，若 token 与表内不一致 → 判定**两节点同 ID 冲突** → 广播 Reject(原因=2)，冲突节点回 UNASSIGNED 重申请。

## 五、待确认清单（请你逐项回复 OK / 改）
1. ID 规划（功能码 0~8、`(FUNC<<5)|NODE`）是否 OK？
2. DLC 固定 8 是否 OK？（可改按需 DLC）
3. 心跳周期 100ms/500ms、离线判定 3 周期，是否 OK？
4. 会话 token 16bit 是否够用（6~8 节点）？
5. 业务 float 用 4 字节小端、B1 目标类型编码，是否 OK？
