zxs18261/GIM6010/3、SguanFOC库文件/02_设计文档/README_索引.md

# 02_设计文档 索引

需求已冻结。本目录存放 AI 产出的设计文档（草案 → 你确认 → 冻结 → 据此写代码）。

| 文件 | 内容 | 状态 |
|---|---|---|
| 01_CAN协议帧编码表.md | CAN 帧 ID 规划 + 每帧数据区 + 冲突检测 | ✅ 已确认 |
| 02_CAN_ID分配状态机.md | 节点状态机 + 上电流程 + 分配/冲突 + 宏参数 | ✅ 已确认 |
| 03_首上电自学习与相序校正.md | 标定流程 + 存储项 + 重标定/恢复出厂 | ✅ 已确认 |
| 04_Flash存储布局.md | 末 2 页双备份 + config_t 结构 + 接口 | ✅ 已确认 |
| 05_VOFA通道表与上位机命令.md | 19 通道定稿 + AO/BO/CO/CAL/FAC/PID | ✅ 已确认 |
| 06_上位机调试步骤_VOFA.md | VOFA 接线/通道/命令/标定/三环/CAN组网 逐步操作手册 | ✅ 已产出 |
| 07_代码修改清单.md | 新增/修改文件 + 关键决策 + 遗留TODO | ✅ 已产出 |

> 每份文档你确认后，我会把"待确认"改为"已确认"，并记录到 `03_工程归档\问题与解决记录.md`。
