zxs18261/GIM6010/1、SguanFOC库文件/docs/adr/0001-use-output-shaft-rad-s-at-external-interface.md

# 对外速度接口统一使用输出轴rad/s

GIM6010带8:1减速器，用户和机械臂关心减速器输出侧，而SguanFOC内部速度量以电机轴为主。项目决定VOFA速度命令、限幅和面向应用的遥测统一使用输出轴机械角速度rad/s，在进入库内部时明确乘以减速比；这样避免rpm/rad/s和电机轴/输出轴混用，代价是每个内部接口都必须标明参考轴并检查换算恰好一次。
