zxs18261/GIM6010/3、SguanFOC库文件/01_需求确认/附图_原理图与硬件资料/README_附图登记.md

# 附图放置区（原理图 / 手册 / 实物照片）

> 把需要 AI 识别的图片/PDF 放进**本文件夹**，然后在
> `..\GIM6010控制器_需求清单.md` 的 **附录 A** 表里登记"文件名 ↔ 对应问题编号"。
> 我会读取/识别后，把识别结果回填到对应章节，并和你逐项核对。

建议按下面命名，方便对应：
- `原理图_功率与采样.png`（对应 R1-4 / 附录A）
- `原理图_CAN与按键.png`（对应 R4-1 / R4-5）
- `电机参数_GIM6010.png`（对应 1.4 / 2.4）
- `上位机界面_VOFA.png`（对应 R2-2）
- `编码器安装.jpg`（对应 1.4）
- `多板串联接线.jpg`（对应 4.5）

可接受格式：PNG / JPG / WEBP / PDF（PDF 我会逐页读）。

已放置文件登记：

| 文件名 | 对应问题 | AI 识别状态 |
|---|---|---|
| （待你放入） | | |
