zxs18261/GIM6010/手搓与AI编写/参考文件和说明文件/设计需求文件/软件设计需求.docx

设计一款关节电机控制器，该硬件电路板可以适配GIM6010-8电机，实际应用时需要通过CAN进行通讯，控制电机旋转至对应角度，调试阶段，可以根据串口进行关键数据的发送（可以通过VOFA平台或者其他软件平台，可视化看数据波形）

1、 由于可以安装在不同参数型号的电机后面，需要根据不同电机参数进行修改
2、 电机相线由于焊接时候，并不会特意按照线序进行焊接，最终程序中在第一次上电的时候，需要确定电机旋转方向与编码器方向是否一致
3、 每一个外设电路需要分别设计一个BSP文件，以方便模块化更改，并且需要在关键代码处加必要的注释，在每个文件的开头需要写注释列出该文件的作用，以及如何应用，方便其他平台的移植
4、 CubeMX的配置已经生成，但是仅仅将引脚配置成什么模式确定了，每个模式下的具体参数还没有进行配置，最终生成一个配置好的CubeMX的ioc文件，并且列出文档，说明每个外设如何配置，每个参数分别什么作用。编写代码的时候，需要注意在生成的代码中的对应位置进行代码放置，防止重新生成代码的时候，将手写代码覆盖。
5、 外设电路：母线电压采样使用两个电阻串联分压后再输出到MCU引脚上；电机温度采样也是两个电阻分压，热敏电阻为电机内部的电阻，需要找资料确定内部电阻阻值与温度的关系，或者参考开源平台上的相应代码；MOS管的温度采样也是使用两个电阻进行串联分压，其中热敏电阻接在MCU引脚和GND之间，使用型号为KNTC0603/10KF3950 (https://item.szlcsc.com/3124166.html?fromZone=s_s__%22C2892547%22)；RGB灯使用型号为XL-3528RGBW-2812B (https://item.szlcsc.com/3114290.html?fromZone=s_s__%22C2890364%22)；CAN通讯使用的芯片为TJA1051TK/3/1J。
6、 RGB三色灯在MCU正常运行的时候，不同颜色渐变效果，以方便观察其在正常运行没有跑飞或者损坏，当进入到不同中断的时候，会让这个灯亮不同的颜色，灯的亮度需要可控。
7、 编写FOC代码，需要实现电流环、转速环、转矩环、位置环、开环运行、VF强拖等，MT6816编码器的数据反馈转子角度信息，电流信息，使用MCU内部的运放配合外围电路进行电流采样，当没有电流的时候，ADC部分采集的电压值应该为1.65V，实际可能有一点偏差，不运行电机时采集对应的值并记录，后续在代码中减去对应的值。
8、 代码要求：可以不在CUbeMX上修改就能手动修改PWM波的载波频率，以及死区时间、占空比，可以手动修改电流环、转速环、位置环、转矩换的频率，以上需要经常修改的参数，需要放在一个单独的文件里面方便整体调试，还包括各环的PID

9、完成代码编写后，最终需要生成一个操作文档，以方便在硬件电路上运行的时候能更快判断该部分代码或者硬件是否有问题
