zxs18261/GIM6010/3、SguanFOC库文件/资料/硬件资料/电机参数/电机参数.docx

该控制器尺寸和结构可以适配GIM6010-8电机，以下列出电机参数可以在什么网站上找到

GIM6010-8：GIM6010-8 - 江西伺泰威自动化设备有限公司 (https://www.steadywin.cn/h-pd-115.html)

该电机为24V电机

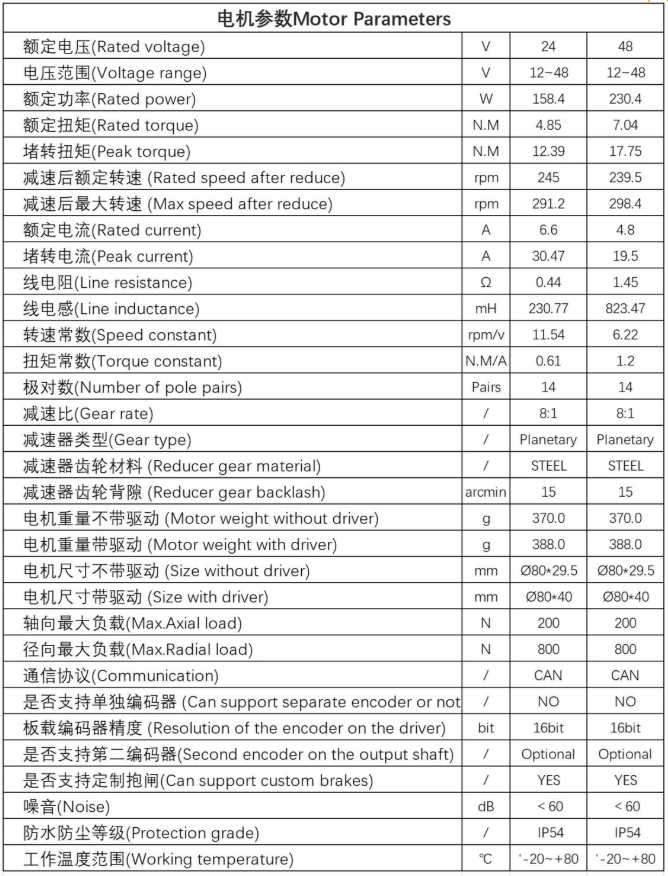
[picture p1: figure]
