zxs18261/GIM6010/3、SguanFOC库文件/03_工程归档/README_索引.md

# 03_工程归档（代码 / 快照 / 编译记录）

本文件夹用于存放"生成代码"阶段的可交付工程产物，避免污染源工程根目录：

- `需求快照_vN.md` — 每轮确认后的定稿快照（若 R0-3 选择"是"）
- `代码变更包\` — 我生成/修改的源文件副本（按目录镜像：APP/BSP/Core/SguanFOC V3.0.1/...），供你审查后再合入
- `编译日志\` — 编译验证输出与错误修复记录（R0-2）
- `烧录与使用说明.md` — 最终如何编译、烧录、首上电流程

> 注意：源工程本体在根目录（Core/BSP/APP/SguanFOC V3.0.1/MDK-ARM），
> 我生成的正式代码会直接落在根目录对应位置；这里放的是**可追溯副本与日志**。

当前内容：
| 文件/目录 | 说明 | 状态 |
|---|---|---|
| （待需求冻结后填充） | | |
