zxs18261/GIM6010/3、SguanFOC库文件/03_工程归档/问题与解决记录.md

# 问题与解决记录（Issue Log）

> 用途：**只增不删**，记录开发过程中遇到的每个问题、判断依据与最终解决。
> 快照只保留最新版（旧版删除），但本日志永久保留，作为决策与踩坑追溯。

| # | 日期 | 类别 | 问题描述 | 解决 / 结论 | 状态 |
|---|---|---|---|---|---|
| I1 | 第一轮 | 引脚 | 用户称 CAN 120Ω 由 PA15 经 TS5A3159 切换，但网表(2026-07-11)里 PA15=MT6816 编码器片选、120Ω(R96)直连 CAN_H/L、无 TS5A3159 | 确认 PA15=编码器 CS；本控制器 CAN 不做软件切换，软件框架按"可切换"预留（见 I2） | ✅ |
| I2 | 第二轮 | 框架 | CAN 终端 120Ω 是否需软件切换 | 本控制器不用切换；**框架按可切换写**（宏开关 + CAN_TermCtrl(on/off) + 可配 GPIO），其它控制器原理图有切换时才启用 | ✅ |
| I3 | 第二轮 | 引脚 | 网表有 2 个按键 SW1/SW2，用户原话"所有按键都是 NRST 引脚" | SW1(NRST/PG10)=ID 分配按键；SW2(PA11/KEY1)=预留未用 | ✅ |
| I4 | 第三轮 | 引脚 | 温度通道答复"驱动器=PB11、电机=PC43"，但本板 PB11=母线电压 VBUS，PC43 在 G431CBT6 不存在 | ✅ 以原理图 PDF 标签+网表+ioc 三方确认：**驱动器温度=PA2(ADC_NTC1=ADC1_IN3, 板载 NTC2)、电机温度=PA3(ADC_NTC2=ADC1_IN4, 外部 P1)** | ✅ |
| I5 | 第四轮 | 参数 | 电机电气参数缺失；图片视觉全链路不可用（siliconflow 402/claude-cli/opencode auth 均失败） | ✅ 用户直接打字提供官方参数表，换算见 `01_需求确认\电机参数_GIM6010.md` | ✅ |
| I6 | 第三轮 | 带宽 | VOFA 24 通道(19 实+5 备用)@1kHz = 100kB/s 超 921600 上限 92.16kB/s | ✅ 用户选**方案 A**：保持 921600，实际发送 19 通道@1kHz（80B，占 86.8%），5 备用通道做成编译宏默认不发送 | ✅ |
| I7 | 第二轮 | 硬件注意 | 多板 CAN 若每板 120Ω 都常连，6~8 板并联后总线终端≈15~20Ω，影响信号 | 建议仅总线两端板保留 120Ω（R96），中间板摘除；本控制器不改软件，作为硬件使用注意项记录 | 📌 注意 |
| I8 | 第一轮 | 配置 | 按键用 NRST 引脚(PG10)，但该脚默认是复位脚，读不到电平 | 需设 Option Byte `NRST_MODE=GPIO`（OB_NRST_MODE_GPIO），已列入 CubeMX 清单 C-8 | ⬜ 待用户执行 |
| I9 | 第一轮 | 位置 | 单圈编码器+8:1 减速+无物理限位，输出轴角多圈回绕 | 位置环先按"输出轴 0~2π/8 范围 + 上电以当前角为参考"实现，限位加上后再定绝对零点 | ✅ |
| I10 | 第四轮 | 参数 | 线电感标"230.77 mH"，按 mH 相电感 115mH 在 24V/14对极上不合理 | ✅ 用户确认按 **µH**：Ld=Lq=**115.4 µH** | ✅ |
| I11 | 第四轮 | 参数 | 磁链 Flux 无法从规格表精确反推（Kv/Kt 内部不一致） | 按估算 **Flux≈0.003 Wb**，上电用参数辨识/开环校准微调 | ✅ 按估算 |
| I12 | 第四轮 | 量程 | 电机堵转电流 30.47A 超出本板采样量程 ±16.5A | 电流环钳位 ~15A（Qcur/Dcur_MAX=15）；要更大电流需改采样硬件 | 📌 硬件限制 |

## 待办汇总
- 代码：✅ 已全部编写（见 `02_设计文档\07_代码修改清单.md`）；⬜ 待用户 Keil GUI 编译并反馈报错（沙箱内 UV4 无头编译挂起）
- 上机联调后：相序6排列自学习、NTC 常数校准、Flux 辨识、TIM_T 频率核对、MIT模式、位置限位（见 07 文档 TODO）
- GIM4310 / GIM4305 参数（后续再补，默认 GIM6010）
