zxs18261/GIM6010/2、SguanFOC库文件/tmp/mt6816_render/page20-20.png

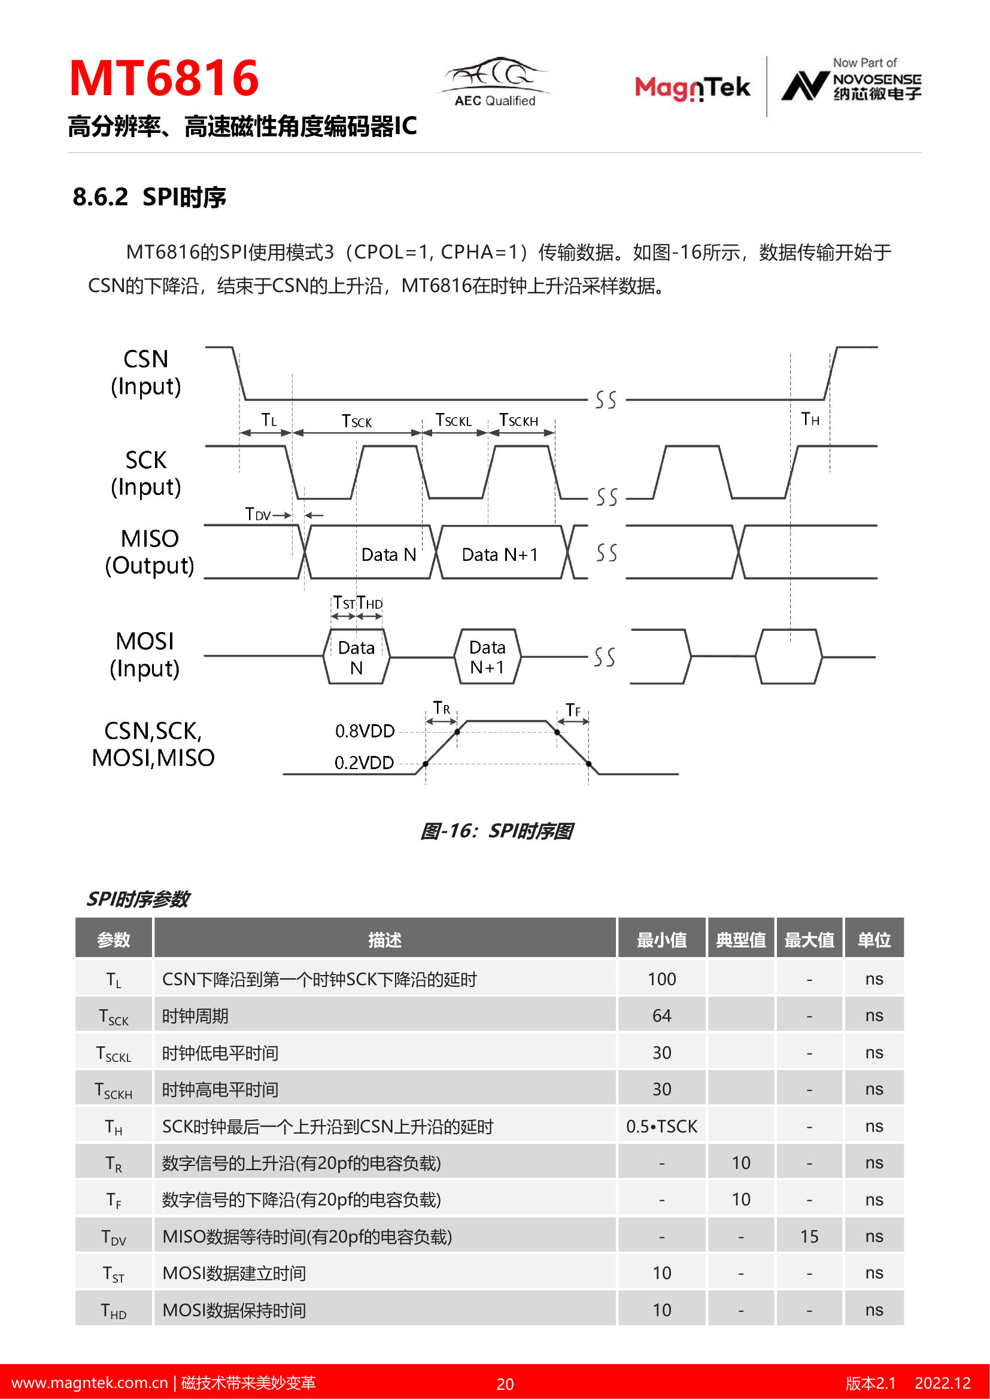
2、SguanFOC库文件/tmp/mt6816_render/page20-20.png
