zxs18261/GIM6010/2、SguanFOC库文件/tmp/mt6816_render/page23-23.png

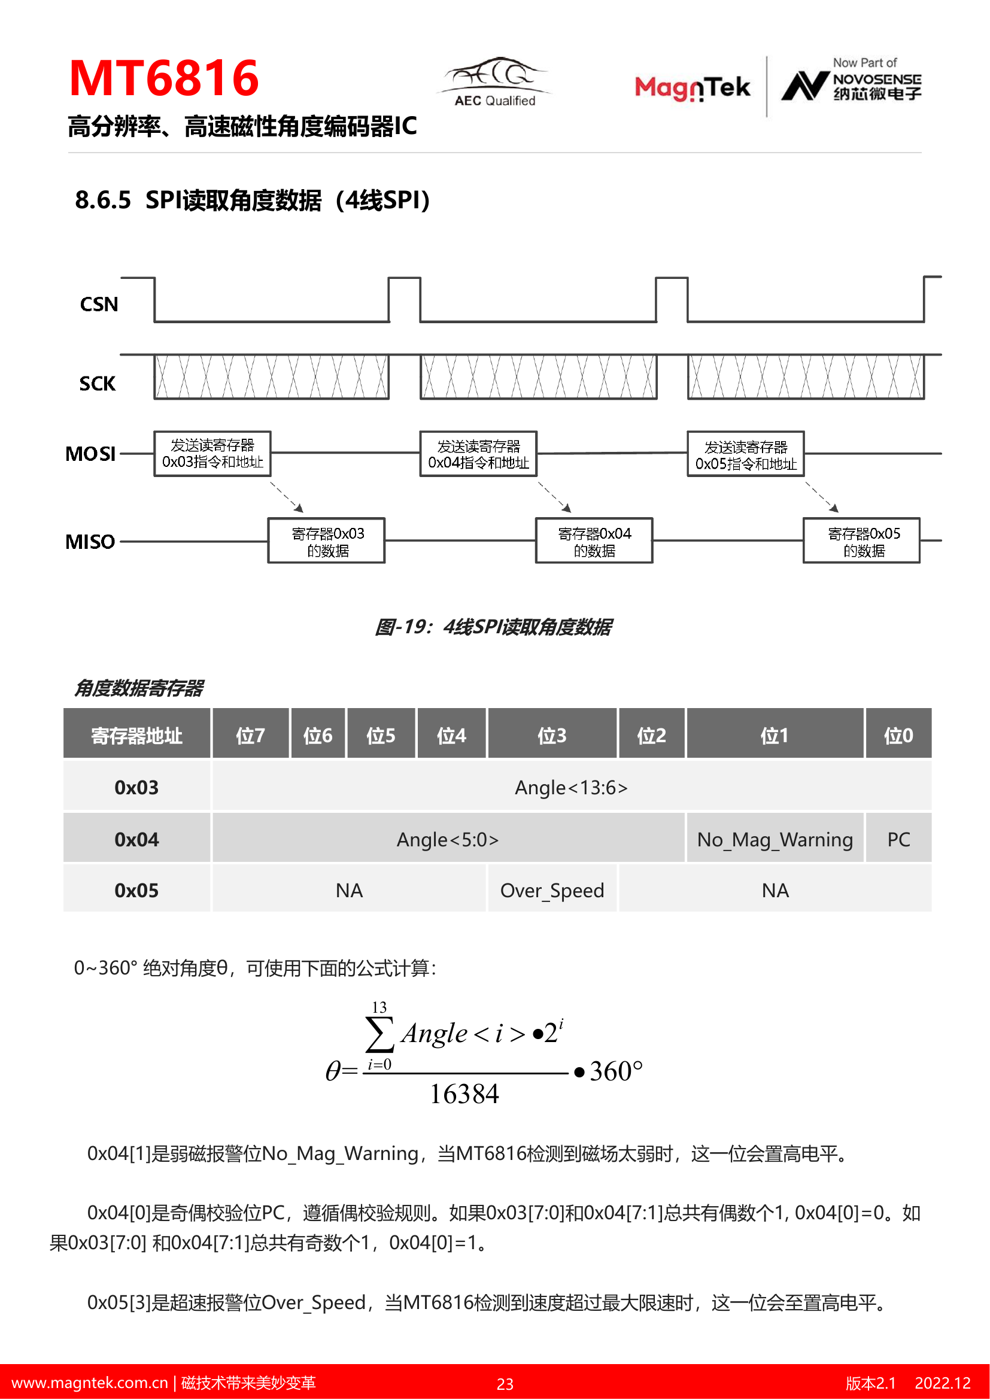
2、SguanFOC库文件/tmp/mt6816_render/page23-23.png
