zxs18261/GIM6010/2、SguanFOC库文件/tmp/schematic_render/schematic-1.png

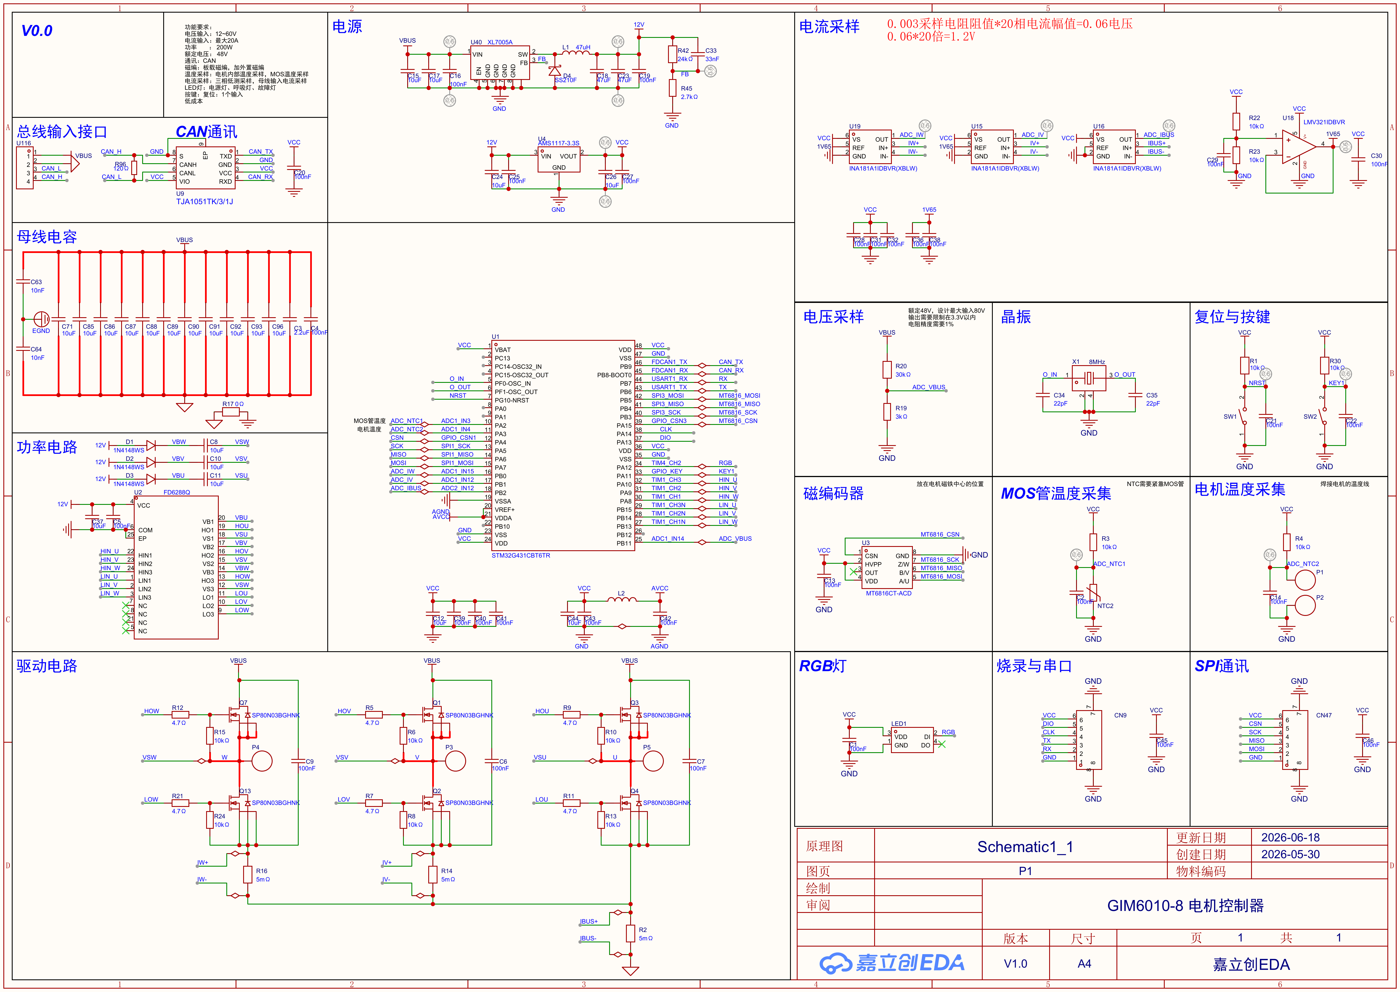
2、SguanFOC库文件/tmp/schematic_render/schematic-1.png
