zxs18261/GIM6010/2、SguanFOC库文件/资料/移植编译Snipaste_2026-07-28_22-15-29.png

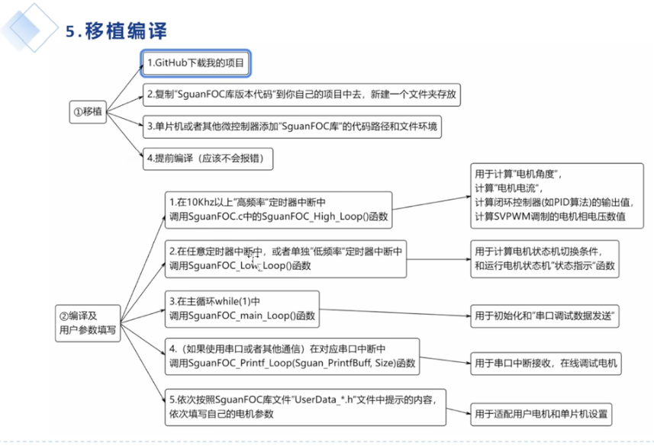
2、SguanFOC库文件/资料/移植编译Snipaste_2026-07-28_22-15-29.png
