zxs18261/GIM6010/3、SguanFOC库文件/资料/硬件资料/电机参数/GIM6010-8电机参数Snipaste_2026-09-07_23-24-05.png

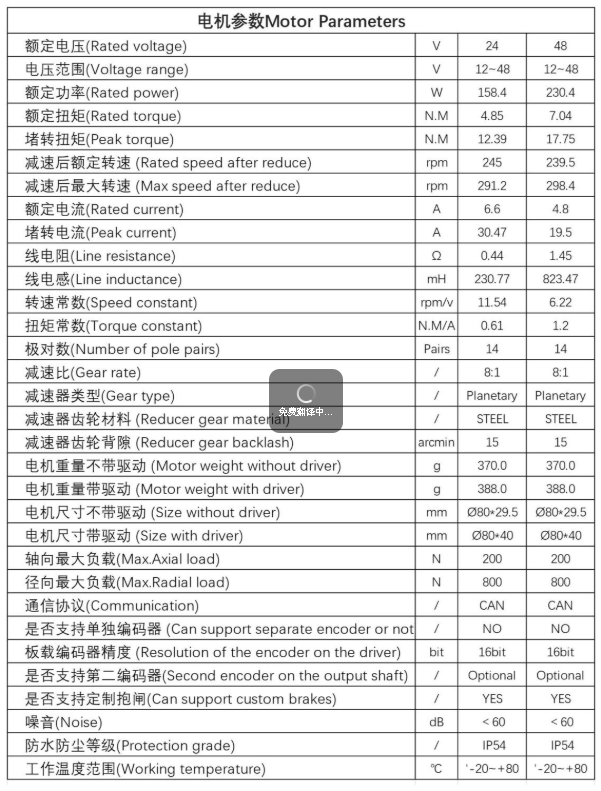
3、SguanFOC库文件/资料/硬件资料/电机参数/GIM6010-8电机参数Snipaste_2026-09-07_23-24-05.png
