zxs18261/GIM6010/3、SguanFOC库文件/01_需求确认/GIM6010控制器_需求清单.md

# GIM6010 关节控制器 — 代码需求清单（待逐轮确认）

> 版本：v0.1（首次发出，等待填写）
> 用途：这是**唯一的“需求输入口”**。你把下面所有 `⬜`/`【待填】`/`【选项】` 项回答完（可直接在本文件里改，也可以回复我说"按默认"），我们逐轮确认。
> **代码冻结规则**：只有当你明确说 **“开始生成代码”** 之后，我才会动代码。此前我只整理文档、问问题、识别你给的附图。
> 填写方式：能确定的直接改文字；需要从原理图/手册确认的，把图放进 `01_需求确认\附图_原理图与硬件资料\`，注明对应哪个问题编号，我会用 AI 识别后回填并再与你核对。

---

## 图例

| 符号 | 含义 |
|---|---|
| ✅ 已确认 | 我已根据现有工程/资料预填，请你**核对**，如不对直接改 |
| ⬜ 待你填写 | 必须由你提供的信息（可写"按默认"） |
| ☐ 选项 | 单选/多选，勾选你的答案 |
| 📎 附图 | 需要你提供原理图/手册/照片，放到附图文件夹 |

---

# 第 0 章 项目基线与交付方式（先确认这 3 条）

### R0-1 代码改动落点 ⬜
当前工程根目录即 `3、SguanFOC库文件\`（CubeMX 生成 + Keil 工程 + SguanFOC V3.0.1 库）。
我生成的代码将**就地修改/新增**在：
- `BSP\`（板级驱动：ADC、MT6816、WS2812B 等）
- `APP\`（应用层：控制调度、上位机命令、CAN 节点逻辑）—— 目前是空目录
- `Core\Src\main.c` 等的 **USER CODE BEGIN/END 段内**（只加少量调用行）
- `SguanFOC V3.0.1\UserData_*.h`（用户配置区）

⬜ 请确认：就在本目录改？（还是希望我另建一份干净工程再改？默认：本目录）

### R0-2 编译验证方式 ⬜
我这边无法保证装了 Keil/ARMCC，需要你选一种：
- ☐ A：你告诉我 Keil 安装路径（如 `C:\Keil_v5\UV4\UV4.exe`），我用命令行 `UV4 -b` 自动编译并回报错误
- ☐ B：我用你工程已有的 EIDE/VSCode 配置尝试命令行编译（不确定可用）
- ☐ C：我只做代码生成 + 静态自检（查类型/查未定义符号），由你在 Keil 里编译并把报错贴回给我迭代
（推荐 A 或 C。若选 C，我会尽量把"可能出现编译错误的地方"提前排查）

### R0-3 每轮确认后是否要生成"确认快照" ⬜
- ☐ 是：每轮确认后我把已定内容归档到 `03_工程归档\需求快照_vN.md`（推荐，方便回溯）
- ☐ 否：只在最终冻结时归档一次

---

# 第 1 章 需求①：首次上电自学习 + 相线错接自动校正

### 1.1 你想要的最终效果（我已按你的描述理解为）⬜ 请确认或补充
> 控制器**第一次上电（或按触发）时自动驱动电机做一次"预定位/标定"**，把结果（编码器零位偏移、旋转方向、相序重映射等）**存入单片机内部 Flash**；之后每次上电直接加载该结果。
> **目的**：即使电机相线没有按 U/V/W 焊一致，标定后电机也按你的指令方向正常转，不反转、不失控。

### 1.2 物理原理说明（供你理解选项，不需要你填）
电机三相任意接线共有 6 种排列，其中 2 种是"有效相序"（一正一反），4 种会造成堵转/反转/大电流。
软件可以做到的是：**标定阶段试探性地小电流驱动，判断"期望正转 vs 实际转向"，然后把 PWM 三相输出做通道重映射（相当于软件把两根相线交换）+ 存方向标志**，从而覆盖任意接法。边界条件：
- 标定需要电机轴**可自由转动（空载/轻载）**，且电源**限流**（建议 12V、1~2A 起步，见附图确认电源能力）；
- 若机械负载锁死，标定无法完成，需进入错误提示。

### 1.3 待确认项

| 编号 | 问题 | 选项/默认 | 你的答复 |
|---|---|---|---|
| R1-1 | 标定触发方式 | ☐ 仅首次上电自动执行一次 ☐ 每次上电先标定 ☐ 长按按键触发标定 ☐ 上位机命令触发标定<br>默认：**首次上电自动 + 可按键/指令重标定** | |
| R1-2 | 校正能力范围 | ☐ A 仅"方向+编码器零位"自学习（相线按说明书接）<br>☐ B **相序自动校正**（任意接法都能转对方向，推荐，工作量+约 1 个标定流程） | |
| R1-3 | 标定时电机是否可带动负载 | ☐ 空载标定（推荐）☐ 带固定负载标定 ☐ 不确定（按空载设计并提示） | |
| R1-4 | 标定供电条件 | ⬜ 最高电压/限流电流（默认按 24V 设计，但要求 **12V/2A 限流电源** 完成首次标定） | |
| R1-5 | 存储内容（将写入 Flash） | ☐ 编码器零位偏移 Pos_offset ☐ Motor_Dir ☐ PWM_Dir ☐ Encoder_Dir ☐ Current_Dir0/1 ☐ 相序重映射表 ☐ 标定完成标志+CRC ☐ 标定日期/版本<br>默认：**以上全部** | |
| R1-6 | Flash 存储区 | 默认：STM32G431CBT6（128KB，2KB/页），用**最后 2 页 0x0801F000~0x0801FFFF**，先擦后写、带备份页<br>⬜ 若你板上有外部 EEPROM/其它占用，告诉我 | |
| R1-7 | 标定失败处理 | 默认：RGB 灯红闪 + 串口打印错误码，禁止启动电机，等按键重试 | |
| R1-8 | 多电机（CAN 组网后） | 每节点各自保存各自的标定结果（默认如此） | |
| R1-9 | 是否需要"恢复出厂/清除标定"手段 | ☐ 长按按键 N 秒清除 ☐ 上位机命令清除 ☐ 不需要<br>默认：长按按键清除 + 上位机命令清除 | |

### 1.4 需要你提供的附图 📎
- 电机铭牌/官网参数页截图（相数、极对数、额定电流/电压、是否带减速箱及减速比）
- 驱动器功率部分原理图（电机端子、采样电阻、INA181 接线、栅极驱动）
- 电机与编码器机械安装说明（编码器是否轴端直装、是否有减速齿轮）

---

# 第 2 章 需求②：三环控制 + 上位机模式切换

### 2.1 运行模式（库原生模式，沿用）✅ 请核对

| 模式值 | 名称 | 含义 |
|---|---|---|
| 0x00 | Velocity_OPEN_MODE | 速度开环（Uq 给定，仅调试/相线测试用） |
| 0x01 | Current_SINGLE_MODE | 电流单闭环（力矩控制，Target_Iq） |
| 0x02 | VelCur_DOUBLE_MODE | 速度-电流串级闭环（Target_Speed） |
| 0x03 | PosVelCur_THREE_MODE | 位置-速度-电流三环（Target_Pos） |

⬜ 问题 R2-1：模式集合是否就用上面 4 个？是否需要去掉开环（0x00）或加"停止/待机"（可复用库状态机 STANDBY，默认保留）？

### 2.2 上位机如何"切换模式 + 给目标" ⬜（这决定协议，最重要）
现状（库自带）：USART1 上行发送 **JustFloat 数据帧**（供 VOFA 绘图）；下行接收 **ASCII 命令** `AO=数值?`、`BO=数值?`、`CO=数值?`（VOFA 文本发送区可直接发）。
库的示例语义：`BO=1?`→切模式0x01；`AO=1.5?`→按当前模式设目标（如 0x03 时设 Target_Pos）。
- ☐ A：**沿用 AO/BO/CO 文本指令**（改动最小，VOFA 可直接用，推荐 v1）
- ☐ B：自定义二进制下行帧（更稳、可扩展，但 VOFA 需用 Hex 发送，且我要定义格式）
- ⬜ 问题 R2-2：你的**具体上位机流程期望**是什么？例如："VOFA 里输 `BO=2?` 切速度环，再输 `AO=3.0?` 让电机转到 3.0rad"，还是你想要**一套固定按钮/预设波形**（例如上位机界面点击按钮）？请描述或附图 📎（上位机界面截图更好）。

### 2.3 各模式"给定"单位与目标来源 ⬜
| 模式 | 给定变量 | 建议单位 | 问题 |
|---|---|---|---|
| 0x01 电流环 | Target_Iq（默认 Id=0） | A（安培） | R2-3：最大允许给定？默认 ±(电流量程保护窗内)，建议默认 ≤ ±5A 起步可配 |
| 0x02 速度环 | Target_Speed | rad/s（机械角速度） | R2-4：是否需要 rpm 显示换算？默认只做 rad/s |
| 0x03 位置环 | Target_Pos | rad（机械角度） | R2-5：位置环控制的是**电机轴**还是**减速后输出轴**？（见 2.4） |

R2-6 ☐ 目标来源：☐ 仅上位机实时给定 ☐ 需要内部轨迹（梯形/S曲线点动）☐ 后续由 CAN 主站给定（第 4 章）

### 2.4 减速比（决定"轴端角度/位置环"刻度）⬜ 关键
你提到"减速齿轮后的轴端角度"。请提供：
- R2-7 ⬜ 减速比 = __ : 1（如 36:1、100:1…）
- R2-8 ☐ 输出轴是否带限位/挡块？☐ 是否需要多圈计数（单圈编码器+齿轮 → 输出轴 1 圈=齿轮比圈）
- R2-9 ⬜ 电机端 vs 输出轴端的方向关系（正转是顺时针/逆时针，从哪端看）——若没有说明书，标定时学习方向即可，此项可选填

### 2.5 安全与切换策略 ⬜
- R2-10 ☐ 模式切换时策略：默认 **先停止（目标归零/减速到零）再切模式**，还是允许带速度热切换？
- R2-11 ☐ 急停输入：板上有没有独立急停 IO？⬜ 引脚？若无，默认用上位机 `CO=0?` 停 / `CO=1?` 使能（库示例语义），请确认
- R2-12 ☐ 是否要"在线调 PID 参数"：☐ 需要（我要加 P/KI/KP 指令或数组下发）☐ 不需要（参数写死在配置头文件，你改完重新编译烧录）——默认先**写死可配**，避免协议膨胀

### 2.6 交付物（写代码后我会给你，本条先确认你要哪些）
- ☐ 上位机调试步骤文档（VOFA 从接线→打开→绘图→切模式→调环的逐步操作）
- ☐ VOFA 配置文件（`.json`/导入模板）
- ☐ 参数调节表（哪个指令调哪个环、默认值、安全边界）

---

# 第 3 章 需求③：VOFA 高速数据通道（通道清单，勾选定稿）

### 3.1 现状基线 ✅
- 上行：USART1 @921600 8N1；帧 = N 个 float(4B) + JustFloat 帧尾 `00 00 80 7F`；库宏 `CH_COUNT`（当前=12）
- 库每帧上限受 `Sguan_PrintfBuff[200]` 限制，float 最多约 48 个
- 帧率：波特率 921600 → 理论字节率 ≈ 92160 B/s；N 通道一帧 = 4N+4 字节

| 通道数 N | 帧长 | 理论最大帧率 | 建议实际使用 |
|---|---|---|---|
| 8 | 36B | ~2560Hz | 高帧率场景 |
| 12 | 52B | ~1770Hz | 常用（库默认） |
| 16 | 68B | ~1350Hz | 推荐折中 |
| 24 | 100B | ~920Hz | 信息全但帧率降 |

⬜ R3-1 请确认/选择：最终要 **N=____ 通道**，目标发送频率 **____ Hz**（我按此定宏与发送节拍；默认建议 N=16 @ 1kHz，若你只要基础信号可用 12@1~2kHz）

### 3.2 候选通道表（勾选你要的；"名称"以库/我的代码最终实现为准，含义如下）

| # | 通道含义 | 对应变量（参考） | 单位 | 建议 | 选 |
|---|---|---|---|---|---|
| 1 | 控制器心跳计数（**单调递增，防呆/防死机判定**） | 自增 uint32→float | 1 | 必选 | ☐ |
| 2 | 库状态机状态 | Sguan.status | 枚举 | 必选 | ☐ |
| 3 | 当前运行模式 | Sguan.mode | 枚举 | 必选 | ☐ |
| 4 | 电角度（电子角） | Sguan.encoder.Real_Erad | rad | 必选 | ☐ |
| 5 | 机械角（电机轴单圈） | Sguan.encoder.Real_Rad | rad | 必选 | ☐ |
| 6 | 减速后输出轴角度 | Real_Rad / gear（我加） | rad | 推荐 | ☐ |
| 7 | 实际机械角速度 | Sguan.encoder.Real_Speed | rad/s | 推荐 | ☐ |
| 8 | 实际 D 轴电流 | Sguan.current.Real_Id | A | 推荐 | ☐ |
| 9 | 实际 Q 轴电流 | Sguan.current.Real_Iq | A | 必选 | ☐ |
| 10 | D 轴给定电流 | Sguan.foc.Target_Id | A | 推荐 | ☐ |
| 11 | Q 轴给定电流 | Sguan.foc.Target_Iq | A | 推荐 | ☐ |
| 12 | D 轴给定电压 | Sguan.foc.Ud_in | V | 可选 | ☐ |
| 13 | Q 轴给定电压 | Sguan.foc.Uq_in | V | 可选 | ☐ |
| 14 | A 相电流 | Sguan.current.Real_Ia | A | 可选 | ☐ |
| 15 | B 相电流 | Sguan.current.Real_Ib | A | 可选 | ☐ |
| 16 | C 相电流 | Sguan.current.Real_Ic | A | 可选 | ☐ |
| 17 | α 轴电流 | Sguan.current.Real_Ialpha | A | 可选 | ☐ |
| 18 | β 轴电流 | Sguan.current.Real_Ibeta | A | 可选 | ☐ |
| 19 | PWM 占空比 U | Sguan.foc.Duty_u | 计数 | 可选 | ☐ |
| 20 | PWM 占空比 V | Sguan.foc.Duty_v | 计数 | 可选 | ☐ |
| 21 | PWM 占空比 W | Sguan.foc.Duty_w | 计数 | 可选 | ☐ |
| 22 | 母线电压实测 | Sguan.foc.Real_VBUS | V | 推荐 | ☐ |
| 23 | 驱动器温度（若有） | Sguan.foc.Real_Temp | ℃ | 可选 | ☐ |
| 24 | 当前模式给定目标（统一出口） | 我封装（模式→对应 Target） | 随模式 | 推荐 | ☐ |
| 25 | 给定/反馈误差（位置环） | 我封装 | rad | 可选 | ☐ |
| 26 | 编码器原始计数/偏置 | Sguan.encoder.Pos_offset | - | 可选 | ☐ |
| 27 | 标定结果标志（是否已学习/相序映射） | 我加（Flash 读出） | 枚举 | 推荐 | ☐ |
| 28 | CAN 节点 ID / 状态（组网后） | 我加（CAN 层） | - | 组网后必选 | ☐ |
| 29 | CAN 心跳计数/冲突标志 | 我加 | - | 组网后推荐 | ☐ |
| 30 | 错误码/保护触发码 | 我封装（库故障+自检故障） | 枚举 | 推荐 | ☐ |

### 3.3 其它待定
- R3-2 ⬜ 发送节拍与哪级中断挂钩：默认 **1kHz（TIM2 或主循环计数）** 发送；是否需要在高速动态过程加密到 2kHz？☐ 是（默认 1kHz）
- R3-3 ☐ 是否需要 Debug 文本混发（printf 与 JustFloat 共用一根线会互相干扰，默认：**不开**，只用 JustFloat；日志单独用 RGB/错误码表达）
- R3-4 ☐ 三相电流里若出现负数/方向问题你主要看哪组（决定我默认把它排在前面）：⬜ 填

---

# 第 4 章 需求④：多电机 CAN 串联 + 按键 ID 分配

### 4.1 硬件/拓扑 ⬜
- R4-1 ☐ CAN 物理层：板上 FDCAN1 是接 CAN 收发器吗？⬜ 收发器型号（附图 📎 原理图 CAN 部分）
- R4-2 ☐ 拓扑：**一条总线串联多个节点**（每板进出两条线并联到总线）？最大节点数默认 32，⬜ 你实际最多接几台？
- R4-3 ☐ 波特率：☐ 经典 CAN 500k ☐ 1M ☐ CAN-FD（需收发器支持）—— 默认 **经典 CAN 1Mbps**（简单可靠；库工程当前 FDCAN 波特率需按此重配，会列入 CubeMX 变更清单）
- R4-4 ☐ 总线两端 120Ω 终端电阻：板上有没有？⬜

### 4.2 按键（ID 分配触发）⬜
- R4-5 ⬜ 按键接在哪个 GPIO（原理图附图 📎），按下为高还是低？
- R4-6 ☐ 按键功能分配建议：
  - ☐ 上电按住 = 进入"ID 申请/分配"模式
  - ☐ 运行时单击 = 申请新 ID（重分配）
  - ☐ 长按(如 3s) = 清除自身 ID 回 UNASSIGNED
  - ☐ 长按(如 5s) = 清除自学习结果
  - 请勾选你想要的组合，或直接写你的用法：
- R4-7 ☐ 按键是否需要兼顾其它功能（如 RGB 灯状态切换）？

### 4.3 节点状态机（按你的要求，已定为如下）✅ 核对
```
UNASSIGNED ──(按键/上电申请)──▶ WAITING_GRANT ──(收到协调者 Grant)──▶ ASSIGNED
    ▲                                                                    │
    └──────(超时/被拒绝/冲突, 重试 N 次)───────────────────────────────────┘
ASSIGNED 且 ID==0(第一个节点) 额外进入子状态 COORDINATOR
```
- R4-8 ☐ 上电时：节点是**直接按 Flash 里存的 ID 进 ASSIGNED**（不再申请），还是**每次上电都回到 UNASSIGNED 重新按键申请**？
  推荐：**有 ID 则直接 ASSIGNED（并按 ID==0 提升为 COORDINATOR）；按键用于主动重新申请/换 ID**。请确认。
- R4-9 ⬜ 超时/重试参数默认值（做成宏，后续可改）：
  - 等待 Grant 超时 = **500ms**，总重试次数 = **5**
  - 协调者心跳周期 = **100ms**，业务心跳周期 = **500ms**
  - 无心跳判定离线 = **3 个周期**
- R4-10 ☐ ID 冲突：两个节点同 ID → 后申请者被拒重排，或按"序号小者胜"？（默认：**冲突帧广播，冲突双方回到 UNASSIGNED 重新申请**）

### 4.4 CAN 帧编码表（这部分最容易乱，先单独确认；我给出"建议默认"，你只需确认或改数字）
⬜ 请逐行确认或修改。默认使用 11 位标准帧，**ID 规划 = 功能基址 + 节点号**，建议：

| 帧类型 | 方向 | 建议 ID 规划 | 数据字节布局（建议默认，可改） | 确认 |
|---|---|---|---|---|
| ID 请求 Request | 节点→总线(协调者听) | 0x200 + 0（广播用节点0 发，或 0x200 广播） | Byte0=请求节点当前临时号(0xFE 表示无) | ☐ |
| ID 授予 Grant | 协调者→指定节点 | 0x210 + 目标节点号 | Byte0=新分配的 ID，Byte1=0xAA(有效) | ☐ |
| 分配拒绝/总线满 | 协调者→广播 | 0x220 | Byte0=0x01 满 / 0x02 冲突 | ☐ |
| 协调者心跳 COORD_HB | 协调者→广播 | 0x230 | Byte0=0x5A；Byte1=已分配节点掩码低8位；Byte2=…高 | ☐ |
| 节点业务心跳 NODE_HB | 节点→广播 | 0x240 + 节点号 | Byte0=递增计数；Byte1=状态(0运行/1故障/2学习)；Byte2=错误码 | ☐ |
| 冲突通知 | 冲突节点→广播 | 0x250 + 节点号 | Byte0=冲突的 ID | ☐ |
| 业务数据(目标下发) | 协调者→指定节点 | 0x300 + 目标节点号 | 4B float 目标(如位置) + Byte4=目标类型(0位置/1速度/2电流) + Byte5=模式 | ☐ |
| 业务数据(状态回传) | 节点→协调者 | 0x310 + 节点号 | 4B float 实际(位置)+4B float 速度+Byte8=模式 | ☐ |

- R4-11 ⬜ 上位机在组网时的位置：⬜ 上位机(VOFA/USB转串)接在**协调者**上，通过协调者转发到其它节点？（默认方案：PC 只与 COORDINATOR 串口通信，协调者把三环目标经 CAN 分发给各节点）
- R4-12 ☐ 多机场景每节点是否都独立三环运行（各自闭环、只收目标）？⬜ 还是有"主从联动/位置同步"需求（若需要同步，我要加同步周期与时间戳设计，请说明）？

### 4.5 需要附图 📎
- 多板连接示意图（或告诉我：每块板 2 个 CAN 座子进出？）
- 按键所在原理图局部 + 引脚号

---

# 第 5 章 需求⑤：代码约束与配置变更

### 5.1 代码约束承诺（写入我的工作准则，供你监督）✅
| 对象 | 处理方式 |
|---|---|
| CubeMX 生成的 `Core/Src|Inc` 中**非 USER CODE 段** | **一律不改**，需要接线时只在 USER CODE BEGIN/END 段内添加 |
| `.ioc` / Keil 工程文件 | 需要改配置时**不改文件本身**，改为给你一份"配置变更清单"（见下），由你在 CubeMX 里改并重新生成 |
| SguanFOC V3.0.1 库核心（SguanFOC.c/.h、Sguan_PID 等） | **不修改**（本拷贝内已有的阶段0修复视为基线，若发现必须改库的 bug，先报告你并单独说明，不经你同意不改） |
| 用户配置 | 一律通过 `UserData_*.h`（Motor/Parameter/UserControl/Function/Status）、`Sguan_Config.h` 与 `BSP/APP` 新增文件实现 |
| 我们的新功能 | 放进 `BSP\`（驱动）、`APP\`（应用）、`SguanFOC V3.0.1\UserData_*.h`（配置/钩子） |

### 5.2 CubeMX / 工程配置变更清单（我会维护在独立文件 `CubeMX配置变更清单.md`）
格式示例（实际清单我已另建，随时追加）：

| # | 需要你在 CubeMX/Keil 里改什么 | 为什么 | 状态 |
|---|---|---|---|
| C-1 | FDCAN1 波特率改为 1M（当前非标） | CAN 组网需求④ | ⬜ 未完成 |
| C-2 | 确认 TIM1 更新中断已勾选并加入 NVIC | FOC 20kHz 电流环挂载 | ⬜ 未完成 |
| C-3 | 按键 GPIO 配置（上拉/下拉+EXTI） | 需求④ ID 分配 | ⬜ 未完成 |
| … | … | … | … |

**提醒机制承诺**：此后每次我交付文档/代码/回答时，会检查该清单，只要有"未完成"项就再次提醒你，直到你确认完成。
> 注：在 CubeMX 改完重新生成代码前，请先把我加到 USER CODE 段的代码**备份**思路确认好（默认 CubeMX 重新生成会保留 USER CODE 段内容；若你勾选了"全量覆盖"选项需提前关闭）。

### 5.3 未按文档配置时的行为 ⬜
R5-1 ☐ 若某配置项未完成，我交付的代码应：☐ 仍交付代码并大字标注依赖项（默认）☐ 拒绝交付相关部分直到你完成

---

# 第 6 章 交付物清单（冻结后我按此产出）

| # | 交付物 | 说明 |
|---|---|---|
| D1 | 代码修改 | 落点见 R0-1，含新增/修改文件清单与 diff 说明 |
| D2 | 上位机调试步骤文档 | VOFA 接线→配置→通道→切模式→各环整定（第 2 章 2.6） |
| D3 | VOFA 模板/配置文件 | 导入即用 |
| D4 | CAN 协议文档 | 帧编码表定稿（4.4）+ 状态机 + 宏参数表 |
| D5 | CubeMX 配置变更清单（持续维护） | 见 5.2 |
| D6 | 编译验证 | 按 R0-2 选定方式执行并回报 |
| D7 | Flash 存储布局文档 | 自学习结果与节点 ID 的地址/格式 |
| D8 | 需求冻结快照 | 归档最终确认版 |

---

# 附录 A：需要你一次性提供的附图/资料（可分批）
放到 `01_需求确认\附图_原理图与硬件资料\`，并在这张表里登记"文件名 ↔ 对应问题编号"，我会 AI 识别后回填对应章节：

| 文件名（你放入后登记） | 内容 | 对应问题 |
|---|---|---|
| （示例）board_schematic_power.pdf | 电源/驱动/采样/电机端子原理图 | R1-4、1.4、R4-1、R4-5 |
| （示例）motor_gim6010_datasheet.png | 电机官网参数表 | 1.4、2.4 |
| （示例）encoder_mount.jpg | 编码器安装 | 1.4 |
| （示例）vofa_ui.png | 你上位机界面/想用的操作方式 | R2-2 |
| （示例）can_wiring.jpg | 多板串联实物接线 | R4-1~R4-4 |
| | | |

# 附录 B：变更记录
| 版本 | 日期 | 内容 | 状态 |
|---|---|---|---|
| v0.1 | 首次创建 | 需求清单初稿，等待填写 | 待确认 |
| v0.2 | 第一轮答复 | 已收到 R0~R5 答复，固化见 `03_工程归档\需求快照_v1.md`；待澄清 Q1~Q7 | 待澄清 |
| v0.3 | 第二轮答复 | Q1/Q2/Q5/Q6/Q7 已定；固化见 `03_工程归档\需求快照_v2.md`；遗留 I4(温度引脚)/I5(电机参数)/I6(带宽) | 待澄清 |
| v0.4 | 第三轮答复 | 引脚提取完成(`01_需求确认\硬件引脚映射表.md`)；I4/I6 已定，固化见 `03_工程归档\需求快照_v3.md`；仅剩 I5(电机参数) | 待电机参数 |
