zxs18261/GIM6010/3、SguanFOC库文件/02_设计文档/07_代码修改清单.md

# 07 代码修改清单

> 生成代码改动位置汇总（遵守"不改 HAL 生成段 / 不改 SguanFOC 库核心"）。

## 新增文件
| 文件 | 说明 |
|---|---|
| `BSP\BSP_ADC.h/.c` | 相电流(注入)/VBUS/温度NTC(DMA) 驱动 |
| `BSP\BSP_WS2812B.h/.c` | 板载 RGB 灯位带驱动 |
| `BSP\bsp_flash.h/.c` | 内部 Flash 末2页双备份配置存储 |
| `APP\app_api.h` | APP 访问接口 |
| `APP\app_can.h/.c` | CAN 帧编码 + ID 分配状态机 |
| `APP\app_autotune.h/.c` | 首上电自学习 |
| `APP\app_protocol.h/.c` | 命令/VOFA/状态灯/按键/心跳聚合 |

## 修改文件（含改动点）
| 文件 | 改动 | 位置 |
|---|---|---|
| `Core\Src\main.c` | +`#include "app_protocol.h"/"BSP_ADC.h"`；+`APP_Init()`；主循环 +`APP_Task()`/`BSP_ADC_UpdateSlow()`；删旧 auto-init 块 | 仅 USER CODE 段 |
| `SguanFOC V3.0.1\UserData_Motor.h` | 电机参数 24V/14对极/Ld=Lq=115.4µH/Rs=0.22Ω/Flux=0.003/增益20/Current_Num=2/限流15A | 用户配置区 |
| `SguanFOC V3.0.1\UserData_Function.h` | 实现 User_InitialInit(PWM启动+ADC+编码器)/User_PwmDuty_Set/User_ReadADC_Raw/User_VBUS_DataGet/User_Temperature_DataGet | 用户配置区 |
| `SguanFOC V3.0.1\UserData_UserControl.h` | User_UserTX 19通道 + AO/BO/CO 语义 | 用户配置区 |
| `SguanFOC V3.0.1\Sguan_printf.h` | `CH_COUNT` 12→19（用户可配宏） | 唯一非 UserData 的库头文件改动 |
| `MDK-ARM\GIM6010_V0.0.uvprojx` | +APP 组(3个.c) + bsp_flash.c/.h；IncludePath +`../APP`、修正 `../SguanFOC V3.0.1` | 工程文件 |

## 关键设计决策（代码内注释均有标注）
1. **相位映射**：TIM1_CH1=PA8(W)、CH2=PA9(V)、CH3=PA10(U) → `User_PwmDuty_Set` 里 CH1←Duty_w、CH2←Duty_v、CH3←Duty_u。
2. **电流采样**：`Current_Num=2`(BC相)，`User_ReadADC_Raw(0)=IV(JDR1)`、`(1)=IW(JDR2)`。
3. **温度**：PA2=驱动器(板载NTC)、PA3=电机(外部)，常规组 DMA1_Channel3 一次读 3 通道，1kHz。
4. **VOFA**：19 通道 @1kHz（80B/帧，占 921600 的 86.8%）；5 备用通道=把 `CH_COUNT` 提到 24 再启用（需升波特率或降频）。
5. **CAN**：`ID=(功能码<<5)|节点号`，经典 1M，轮询收发（FDCAN 未开中断）。
6. **Flash**：0x0801F000/0x0801F800 双页交替 + CRC32 + 序号。
7. **按键**：SW1=NRST/PG10（上电按住=ID分配；长按5s=清ID白灯）。

## 遗留 TODO（上机联调后补）
1. 相序自学习 6 排列遍历（现仅保存方向/零位/零偏，`phase_remap` 恒等）。
2. NTC 的 R25/B 常数需按实际传感器校准。
3. Flux=0.003 为估算，上机辨识微调。
4. High_Loop 频率核对：库 `TIM_T=1e-4`(10kHz)，若 TIM1 更新中断实为 20kHz 需把 `UserData_Config.h` 的 `TIM_T` 改为 `5e-5`。
5. MIT 模式(0x04) 占位，后续实现。
6. 输出轴位置环限位(粗零点) 待加限位开关后实现。
