zxs18261/GIM6010/SguanFOC库文件/MDK-ARM/GIM6010_V0.0/build_out.txt

*** Using Compiler 'V6.23', folder: 'C:\Users\Xushengzhu\AppData\Local\Keil_v5\ARM\ARMCLANG\Bin'
Build target 'GIM6010_V0.0'
compiling Sguan_MotorStatus.c...
compiling main.c...
compiling Sguan_printf.c...
compiling stm32g4xx_it.c...
compiling Timer.c...
compiling BSP_RGB.c...
compiling SguanFOC.c...
linking...
Program Size: Code=31782 RO-data=2790 RW-data=20 ZI-data=4452  
FromELF: creating hex file...
"GIM6010_V0.0\GIM6010_V0_0.axf" - 0 Error(s), 0 Warning(s).
Build Time Elapsed:  00:00:02
