zxs18261/GIM6010/1、SguanFOC库文件/docs/foc/debug-records/2026-08-24-calibration-no-visible-motion.md

# FOC故障记录：烧录后未观察到预定位动作

- Record ID：GIM6010-CAL-20260824-01
- 日期、操作者：2026-08-24，用户台架反馈
- 控制板ID、电机ID、编码器ID：GIM6010控制器/GIM6010电机/MT6816，实例序列号待补
- Git分支/提交/脏差异摘要：HEAD `8928aed`，工作区存在尚未提交的控制、校准、ADC和文档修改
- 构建产物：`MDK-ARM/GIM6010_V0.0/GIM6010_V0_0.hex`，SHA-256 `11BF358C531B535BF4961B6AF4473E5EE1E79B45D53D95556526FCD570489818`
- 构建结果：Keil构建日志显示Code=52042、RO-data=2814、0 error、0 warning
- FOC库：当前工作区SguanFOC
- 母线、电源限流、负载、机械固定和急停：用户尚未提供
- 授权范围：只读诊断与文档记录；本轮不修改控制代码、不编译、不烧录、不带电测试

## 现象和最小复现

- 用户可见现象：当前代码烧录后，没有观察到预计的预定位，电机轴没有动作。
- 最小操作：烧录当前固件后上电；具体是否执行全片擦除、烧录时母线是否已经存在、观察持续时间尚不明确。
- 发生率与重复次数：尚未提供。
- 最后已知正常版本：HEAD `8928aed`对应的旧开环版本曾由用户确认可开环运行；当前校准修订没有台架通过记录。

### 2026-08-24台架反馈补充

- 按复位后Ch0变为十进制15，持续约2 s后变为0。
- 上电后Ch12显示约23.15 V，万用表测得母线约24 V。
- 状态码定义确认：15=`MOTOR_STATUS_UNDERVOLTAGE`，0=`MOTOR_STATUS_STANDBY`。
- 正常首次校准至少包含200 ms母线稳定、800 ms固定Ud、800 ms正转扫描、100 ms稳定、800 ms反转扫描、100 ms稳定和400 ms释放，合计约3.2 s。没有观察到Ch0=3且很快进入15，不符合完整首次校准路径，更支持“有效Flash记录被加载、预定位被跳过”。

## 源码与构建侧证据

- `main.c`在进入主循环前设置`MOTOR_STATUS_UNINITIALIZED`，所以正常冷启动不依赖VOFA发送`CO=1?`。
- 无有效校准记录时，程序先进入Ch0=3校准态，并等待实测Ch12母线稳定处于10～48 V；未满足时PWM保持高阻，电机按设计不动。
- 母线满足后，代码直接写SVPWM比较值并打开TIM1 MOE：先以`Ud=0.04×24 V=0.96 V`固定800 ms，再让强制电角度正向一圈并反向返回。因此常规20 kHz控制分支不处理Ch0=3不是本现象的直接解释。
- 校准记录位于`0x0801F800`；链接区上限为`0x08000000 + 0x1F800`，烧录HEX不包含最后2 KiB数据页。普通扇区下载可能保留旧校准记录。
- 如果校准记录的epoch、校验和和固件签名都有效，启动代码会直接加载记录并进入Ch0=4空闲态，按设计不产生任何预定位动作。
- 当前实现无法识别“同一份完全相同的HEX又烧录了一次”：固件签名不变、保留页也不变，因此它仍会跳过校准。这与“每次发生烧录操作后都必须重做一次”的字面要求存在差距。
- Ch0=15只能由欠压判断写入：ADC必须至少出现过一次有效但低于12 V的采样。Ch12最终稳定在23.15 V不能排除启动瞬态，因为500 Hz上位机不一定捕获到首次低值，而故障状态会被锁存。
- 欠压恢复逻辑存在方向错误：`Status_VBUS_UNDERVOLTAGE()`在`Real_VBUS < VBUS_MIN`仍然成立时调用`Status_Switch_STANDBY()`；也就是故障仍存在时反而退出到Ch0=0。该源码路径与用户观察到的`15 → 0`一致，属于独立的安全状态机缺陷。
- 故障门控还存在范围缺口：High Loop允许所有`status > 3 && status < 19`的状态继续控制，因此14～18的过压、欠压、温度和过流状态没有自动阻断控制计算；只有19以上故障才显式关闭MOE。
- `Status_Switch_STANDBY()`只把状态写成0，没有清零DQ/目标量或关闭MOE。若故障发生前存在非零输出，自动进入0后可能保留最后一次比较值和MOE状态。当前实验目标为0时未观察到动作，不能据此证明该路径安全。

## 反馈信号

- 最小观察量：上电后连续观察5 s的Ch0（状态）和Ch12（母线显示）。辅助量为Ch5（U相比值）、Ch14（编码器机械角）和电源电流。
- 可观测性限制：Ch12在ADC尚无有效样本时会回退显示配置值24 V，而校准门控使用原始值`-9999 V`并继续等待。因此Ch12=24 V不一定是实测24 V，不能单独证明母线门控已经通过。
- 分支判据：
  - Ch0很快为4：已有有效Flash记录，程序主动跳过预定位。
  - Ch0持续为3且Ch12实测<10 V或>48 V：母线门控正在阻止预定位。
  - Ch0为3且Ch12显示24 V时：还必须确认ADC有效性；现有VOFA通道不能区分“实测24 V”和“无效后回退24 V”。
  - Ch0为3、万用表确认母线在10～48 V，但Ch5/Ch14/电源电流均无响应：继续检查ADC有效性、实际烧录镜像、TIM1 MOE、驱动级使能/供电和0.96 V对齐强度。
  - Ch0最终为19：编码器数据不新鲜；Ch0最终为20：相序往返位移检查失败或Flash保存失败。
- 原始数据路径：尚未提供。

## 候选原因（按当前证据排序）

1. **strongly supported：旧校准页被普通下载保留且仍有效。** 证据为没有出现完整Ch0=3校准窗口，而程序很快进入只有运行态才会检查的欠压状态15；同一HEX重烧不会改变固件签名。
2. **source-confirmed defect：启动ADC至少出现一次低于12 V的有效采样并锁存欠压，随后错误的恢复条件把状态15切到0。** 用户观测与唯一路径一致；首次低值的原始ADC数据尚未捕获。14～18故障未阻断High Loop、自动待机未显式关闭MOE，是同一区域必须一并回归的安全缺陷。
3. **hypothesis：烧录的不是上述最新HEX。** 预测：产物哈希/时间戳与烧录工具记录不一致。

## 下一单变量实验

- 已完成第一轮信号采集：Ch0=`15 → 0`，Ch12最终23.15 V，结果支持Flash跳过并发现欠压状态机缺陷。
- 下一单变量实验应捕获复位后最初100 ms的母线ADC最小值/有效标志；现有500 Hz且带回退的Ch12不足以可靠观察首个异常样本，需先获得修改代码的授权再增加临时诊断通道或调试器观察点。
- 在修正欠压状态机、故障PWM门控和明确强制校准语义前，不擦除校准页、不提高`USER_ALIGN_UD_RATIO`，避免将安全状态机缺陷与带电校准混在一次实验中。

## 结论与回归

- 根因：没有预定位动作主要由有效Flash记录导致主动跳过；状态随后变为0则由启动欠压锁存及错误恢复路径解释。首次ADC为何出现低于12 V的样本仍待仪器/临时通道确认。
- 修复或回退：2026-08-25已修改欠压去抖/恢复、14以上故障关断、STANDBY零输出和VOFA诊断；尚未烧录回归。
- 证据标签：`15 → 0`与23.15 V为bench-observed；Flash布局、状态码、状态写入和恢复条件为source-confirmed；首次低ADC样本来源为hypothesis。
- 剩余风险：尚无复位最初100 ms母线最小值、ADC有效时序、PWM波形、电流或编码器变化的台架证据；14～18故障门控和自动待机零输出路径尚未通过。

## 2026-08-25修复修订

- 欠压从“单样本立即锁存”改为1 kHz下连续20 ms确认；过压确认保持最多1 ms。
- 过压/欠压恢复条件改为回到带1 V滞环的安全区并连续稳定1 s，随后进入STANDBY；删除故障超时强制IDLE。
- High Loop运行范围从4～18收紧为4～13；14以上故障和自动STANDBY统一清零目标、写零矢量并关闭MOE。
- D/Q过流补齐负方向比较；AO/BO/VO和开环积分在14以上故障中全部阻断。
- 新增Ch21～Ch35，包含校准结果、实际对齐Ud、相序、Flash/ADC有效、复位后母线最小值、方向/映射、MOE和当前Ud。
- Keil Arm Compiler 6.23最终全量构建通过0 error、0 warning；Code=53546，HEX SHA-256=`10368D03DFBD9E6111E8F10F2C0222C0D43DE2D1924D84C27C208F07A07FD644`。
- 当前证据：修复实现与编译为source-confirmed；原现象不再复现、首次新校准、故障Ch34=0和掉电加载仍为bench pending。
