zxs18261/GIM6010/1、SguanFOC库文件/docs/adr/0003-persist-assembly-calibration-with-invalidation.md

# 装配校准写入Flash并按身份变化失效

三相焊接、编码器安装和控制板电流通道属于装配实例关系，不应每次上电重复施加定位电流，也不能永久写死为所有电机的源码默认值。项目决定首次有效母线上电完成方向与偏置校准后写入专用Flash记录，后续上电仅在magic、格式/epoch、固件签名、校验和提交标记均有效时加载；更换电机、接线、编码器关系、映射或相关算法时必须使旧记录失效并重新校准。
