zxs18261/GIM6010/1、SguanFOC库文件/docs/foc/debug-records/README.md

# 调试记录

每个有意义的问题或实验使用独立Markdown文件，文件名为`YYYY-MM-DD-<简短英文主题>.md`。原始CSV、截图、逻辑分析仪和构建日志保留在原目录，记录中使用相对路径链接。

## 当前记录

- [当前对话与已完成修改摘要](2026-08-24-current-conversation-summary.md)：开环、方向、速度限幅、VOFA非法命令、校准和待验证事项。
- [烧录后未观察到预定位动作](2026-08-24-calibration-no-visible-motion.md)：记录Flash跳过、母线门控和功率输出三条诊断分支，等待Ch0/Ch12台架数据。

## 新建记录

复制[故障记录模板](../templates/debug-record-template.md)。不要覆盖旧记录；同一问题的新修订回归应新建文件，并在两份记录之间互相链接。

## 关闭条件

问题只有同时满足以下条件才标为resolved：根因被证据支持；修复与根因对应；原始现象不再复现；相关安全零输出路径通过；当前固件和硬件身份已记录；不存在被修复掩盖的第二个故障。
