zxs18261/GIM6010/3、SguanFOC库文件/02_设计文档/06_上位机调试步骤_VOFA.md

# 06 上位机调试步骤（VOFA+）— 交付文档

> 适用：GIM6010 控制器（本固件）。上行 JustFloat **19 通道 @1kHz**（帧尾 `00 00 80 7F`）；下行文本命令。
> 串口：USART1，PB6(TX)/PB7(RX)，**921600 8N1**。板子 TX 接 USB-TTL 的 RX，RX 接 TX，共地。

## 一、接线与启动
1. USB-TTL 接板子 `CN9` 调试座的 TX/RX/GND（RX→TX、TX→RX、GND→GND）。
2. 打开 **VOFA+**（v1.3.10+），左上 **Data Engine**：
   - 点 `+` 新建引擎 → 选 **JustFloat**。
   - 参数：**波特率 921600**，无校验，8 数据位，1 停止位，打开对应 COM 口。
   - 通道数量填 **19**（`Float` 类型）。
3. 连接后应看到数据刷新（先看通道 1 心跳计数是否**单调递增**——递增=控制器活着）。

## 二、19 通道含义表（VOFA 里按此命名）
| # | 含义 | 单位 | # | 含义 | 单位 |
|---|---|---|---|---|---|
| 1 | 控制器心跳(自增) | 1 | 11 | 实际Q电流 | A |
| 2 | 状态机状态 | 枚举 | 12 | U相电流 | A |
| 3 | 当前模式 | 0开环/1电流/2速度/3位置/4MIT | 13 | U相计数值(马鞍波) | 计数 |
| 4 | 电角度 | rad | 14 | 母线电压 | V |
| 5 | 减速后出轴角度 | rad | 15 | 驱动器温度 | ℃ |
| 6 | 出轴机械角速度 | rad/s | 16 | 电机温度 | ℃ |
| 7 | 给定数据(模式相关) | 随模式 | 17 | 标定标志 | 0未/1中/2成功/3失败 |
| 8 | 给定D电流 | A | 18 | CAN节点ID | 255=未分配 |
| 9 | 给定Q电流 | A | 19 | CAN心跳计数 | 1 |
| 10 | 实际D电流 | A | | | |

状态机常用值：0=待机STANDBY，1=未初始化，2=初始化中，3=校准中，4=空闲IDLE，0x0E~0x17=各保护/故障（≥0x0E 即保护锁定）。

## 三、命令发送（文本）
在 VOFA 里选 **发送区**（文本模式），逐条发：
| 命令 | 作用 | 示例 |
|---|---|---|
| `AO=<值>?` | 按当前模式设目标 | 位置模式 `AO=0.5?`（0.5rad） |
| `BO=<n>?` | 切模式 0/1/2/3/4 | `BO=2?` 切速度环 |
| `CO=<0\|1>?` | 0=停止(软关)，1=使能 | `CO=1?` 使能 |
| `CAL=1?` | 触发标定 | |
| `FAC=1?` | 恢复出厂(清标定+清ID，复位) | |
| `PID=1?`/`PID=0?` | 进/出 PID 在线调参模式 | |

## 四、首上电流程（标定）
1. 电机**空载**、24V 电源**限流 2A**，上电。
2. 固件检测无标定 → 自动进入标定：蓝灯(标定中) → 堵转对齐(电机可能微动) → 完成后**绿灯**。
3. 通道 17 标定标志：1=标定中 → 2=成功（通道 2 状态机应走到 4=IDLE）。
4. 失败则**红灯快闪** + 状态机进保护(≥0x0E)；检查接线/限流，发 `CAL=1?` 重试。
5. 标定成功后：`CO=1?` 使能 → 按下面逐环调试。

## 五、三环调试步骤
### 电流环（力矩模式）
1. `BO=1?`（电流模式）→ `CO=1?` 使能。
2. `AO=0.5?`（0.5A 给定）→ 观察通道 9/11（给定/实际Q电流）跟随；通道 13 出现马鞍波。
3. 逐渐加大到 2~3A，检查无啸叫/发热。异常先 `CO=0?` 停机。

### 速度环
1. `CO=0?` 停机 → `BO=2?` → `CO=1?`。
2. `AO=5?`（5 rad/s 出轴）→ 通道 6 跟踪、通道 9 电流平稳。
3. 反转 `AO=-5?`。调参：需先发 `PID=1?` 进调参模式（调参接口后续版本开放）。

### 位置环
1. 停机 → `BO=3?` → `CO=1?`。
2. `AO=0.5?`（出轴 0.5 rad）→ 通道 5 到位、通道 9 力矩收敛。
3. 注意：单圈编码器+8:1，出轴有效范围 **0~2π/8≈0.785 rad**，给定请限制在此内（限位加入后再扩展）。

## 六、多节点 CAN 组网（ID 分配）
1. 所有板 CAN_H/CAN_L 并联成一条总线（**仅两端板保留 120Ω**，中间板摘 R96）。
2. 第 1 块板**按住按键上电** → 分配 ID=0（协调者，专属颜色）。
3. 依次给后续板按住按键上电 → ID=1、2、3…（**不同 ID 灯色不同**，方便区分）。
4. 分配成功后断电量启，ID 已存 Flash、直接上线（通道 18 显示 ID）。
5. 清 ID：运行中**长按按键 5s** → 常亮白灯 → 重新按住上电再分配。
6. 上位机只连协调者(ID=0)的串口，目标经 CAN 下发（业务帧见 `01_CAN协议帧编码表.md`）。

## 七、常见问题
| 现象 | 排查 |
|---|---|
| VOFA 无数据 | 波特率/接线/COM口；看板子灯是否亮 |
| 心跳不涨 | 控制器死机/复位，检查供电与硬件 |
| 标定失败红灯 | 限流太低/负载/编码器读数异常(通道4无变化) |
| 使能后不转 | 检查 CO=1 后状态机(通道2)是否到 4 |
| 反向 | 标定已按磁编正方向校正；如仍反，发我调 Encoder_Dir |
