zxs18261/GIM6010/1、SguanFOC库文件/资料/文档/GIM6010_预定位故障与VOFA诊断修改说明.md

# GIM6010预定位故障与VOFA诊断修改说明

日期：2026-08-25。

## 1. 故障现象与确认结果

用户台架观察到：复位后Ch0先为15约2 s，随后变为0；Ch12约23.15 V，万用表母线约24 V；电机没有发生预计的预定位动作。

源码与台架信号共同说明存在两条连续路径：

- 普通下载保留`0x0801F800`校准页；同一份HEX再次烧录时签名不变，旧记录会被加载并跳过预定位。
- 状态15是欠压。启动时一次低ADC样本会立刻锁存欠压；旧恢复函数在电压仍低于下限时反而进入状态0，并且14～18故障仍允许20 kHz控制、自动待机未统一关闭MOE。

## 2. 本次代码修改

- 欠压必须在1 kHz Low Loop连续低于12 V达20 ms才锁存，过滤ADC启动首样本。
- 过压高于48 V最多确认1 ms，避免为滤波而延迟危险关断。
- 欠压恢复要求母线连续高于13 V达1 s；过压恢复要求连续低于47 V达1 s；恢复后只进入STANDBY，不自动恢复运行。
- 状态14及以上立即清零Ud/Uq、Id/Iq/速度/位置目标，写零矢量并关闭TIM1 MOE。
- 20 kHz High Loop只允许状态4～13执行FOC和PWM计算；故障期间拒绝AO/BO/VO并停止开环角积分。
- 自动STANDBY先写状态0，再执行统一安全清零，避免低频清零时被高频中断重新开启PWM。
- D/Q过流判断同时覆盖正负电流。
- ADC BSP保存复位后未滤波母线最小值，仅用于诊断，不参与控制。
- VOFA从Ch21追加到Ch35，原Ch0～Ch20不移动、不复用。

所有新增或删除的控制逻辑都在源码邻近位置写有中文备注，说明时基、单位或安全原因。

## 3. 校准结果码

- Ch21=0：尚未检查Flash。
- Ch21=1：Flash无有效记录，保持高阻并等待10～48 V功率母线稳定。
- Ch21=2：正在对齐或检查相序。由于校准流程会占用主循环，这个中间值可能不会被VOFA及时绘出。
- Ch21=3：本次新校准完成并成功保存、回读Flash。
- Ch21=4：本次从Flash加载，按设计不施加Ud、不转动。
- Ch21=5：编码器样本失效。
- Ch21=6：相序正反扫描位移不可信。
- Ch21=7：Flash保存或回读失败。

## 4. 首次新校准成功后的VOFA期望值

- Ch0=4：进入IDLE。
- Ch3、Ch4接近0 A：释放后Id/Iq应回到采样噪声附近。
- Ch5约2125 count：零矢量逻辑比较值位于TIM1中点；此时Ch34必须为0，所以三相主输出实际关闭。
- Ch7=0 V：Uq已经清零。
- Ch10位于0～2π rad：本次保存的电机轴机械零偏，具体数值由安装位置决定，没有固定标准值。
- Ch11=0：默认开环FOC模式。
- Ch12约23.15 V：当前实测比例下的母线显示；与24 V万用表差约3.5%，不影响12 V欠压阈值判断。
- Ch18=0 rad/s：开环积分速度已清零。
- Ch21=3：本次确实执行并保存了新校准。
- Ch22约0.96 V：`0.04×24 V`，表示本次曾实际施加该对齐Ud；它是历史诊断值，不代表预定位后仍有输出。
- Ch23=1：最终相序检查通过；如第一次为-1，代码翻转`Motor_Dir`后复测，最终仍应为1。
- Ch24=1：Flash保存并回读有效。
- Ch25=1：母线ADC有效。
- Ch26为复位后最低母线采样[V]：可低于Ch12，用于判断启动瞬态；若持续母线正常但Ch26偶发低值，20 ms欠压去抖应阻止Ch0进入15。
- Ch27通常为-1：当前源码默认编码器方向；以实际装配校准记录为准。
- Ch28为1或-1：相序检查后的最终`Motor_Dir`，没有统一固定值。
- Ch29通常为-1：当前板级PWM极性默认值。
- Ch30=1、Ch31=1、Ch32=2：当前板级BC两电阻采样默认映射；以最终Flash记录为准。
- Ch33=14：极对数。
- Ch34=0：TIM1 MOE关闭，预定位后电机应可轻松手动转动。
- Ch35=0 V：当前Ud已经清零。

Ch13/Ch14和Ch15/Ch16是当前电角/机械角，具体值随安装位置变化，不要求等于0。预定位保存的是Ch10偏置，不是强行让绝对编码器原始值Ch14变成0。

## 5. 后续掉电重启加载Flash的VOFA期望值

- 电机不应发生预定位动作。
- Ch0=4、Ch21=4、Ch22=0 V、Ch23=0、Ch24=1。
- Ch10应与上一次保存值一致，允许浮点显示末位误差。
- Ch34=0、Ch35=0 V、Ch7=0 V、Ch18=0 rad/s。
- Ch27～Ch33应与首次新校准成功后保持一致。

## 6. 失败与立即停机判据

- Ch0=14～23时，Ch34必须立即为0；否则立即断开母线，不继续发送运动命令。
- Ch21=5/6/7时不得继续闭环或开环运行，应记录Ch0、Ch10、Ch12、Ch14、Ch21～Ch35和电源电流。
- 出现电源过流保护、异响、剧烈抖动、反复撞限位或Ch34在故障时为1，立即断开母线。

## 7. 烧录语义说明

本次源码变化会改变固件签名，因此烧录本次新HEX后，旧校准记录应自动失效，第一次满足母线条件时会重新校准。以后若把完全相同的HEX再次普通下载，MCU无法区分“同一镜像重烧”和“普通复位”，仍会加载记录；需要强制重做时应递增`USER_CALIBRATION_EPOCH`后重新构建，或明确擦除校准页。

## 8. 构建与待验证项

- Keil Arm Compiler 6.23最终全量构建已通过0 error、0 warning；Code=53546、RO-data=2814、RW-data=52、ZI-data=5276。
- `GIM6010_V0_0.hex`的SHA-256为`10368D03DFBD9E6111E8F10F2C0222C0D43DE2D1924D84C27C208F07A07FD644`。
- 当前结论属于source-confirmed；Ch0、Ch21～Ch35序列、实际转动、MOE关断和Flash掉电重载仍需用户台架回归后才能标为bench-verified。
