zxs18261/GIM6010/2、SguanFOC库文件/MDK-ARM/build_log.txt

*** Using Compiler 'V5.06 update 7 (build 960)', folder: 'C:\Users\18261\AppData\Local\Keil_v5\ARM\ARMCC\Bin'
Build target 'GIM6010_V0.0'
compiling app_joint.c...
compiling Sguan_printf.c...
compiling SguanFOC.c...
linking...
Program Size: Code=39420 RO-data=4964 RW-data=212 ZI-data=4740  
FromELF: creating hex file...
"GIM6010_V0.0\GIM6010_V0_0.axf" - 0 Error(s), 0 Warning(s).
Build Time Elapsed:  00:00:08
