zxs18261/GIM6010/1、SguanFOC库文件/docs/foc/debug-records/2026-08-24-current-conversation-summary.md

# 当前对话与FOC调试摘要

- Record ID：GIM6010-2026-08-24-CONSOLIDATION
- 记录日期：2026-08-24
- 固件基点：`main` / `8928aed`（“能够开环运行”）
- 工作区：脏；该提交之后包含采样、编码器DMA、母线、校准、Flash、VOFA和文档改动
- 证据来源：当前源码、Git历史、用户在本对话中的实物反馈；旧原始串口数据位于`VOFA控件/VOFA相关数据`及用户消息，尚未逐条绑定到当前固件哈希

## 已报告现象

1. 早期VOFA下发命令后电机曾不转，串口同时出现JustFloat和ASCII回显数据。
2. 用户观察到SVPWM使用角度与编码器机械角方向相反。
3. 早期速度上限表现为几十rad/s，继续增大给定没有反应。
4. 开环中增加“转矩给定”后速度上升；后来明确该给定实际是Uq电压作用量，不是闭环N·m。
5. 发送字面量`VO=%f?`时，用户观察到电源瞬间触发过流保护。
6. 用户要求首次有效母线上电进行装配校准，后续使用Flash结果；换电机/接线/编码器关系时重新校准。
7. 用户确认提交`8928aed`对应阶段能够开环运行。

## 当前源码中的处理

- **source-confirmed**：开环模式已经明确为纯开环FOC：`Ud=0`，AO→Uq[V]，VO→输出轴rad/s，经过8:1减速比和14极对数换算后，以20 kHz积分电角度。
- **source-confirmed**：VO与Uq默认独立，保留的V/f软限默认关闭；因此无负载开环中提高Uq可能提高实际可跟随速度，这不等于实现了转矩闭环。
- **source-confirmed**：输出轴速度命令限幅±30.787608 rad/s，即额定25.656340 rad/s的1.2倍。
- **source-confirmed**：ASCII解析只允许普通十进制格式，`%f`、NaN、Inf、指数、残缺和未知命令返回失败，不进入任何AO/BO/CO/VO调整函数。
- **source-confirmed**：普通电流模式串口Iq限制为±6.6 A；30.47 A峰值能力未向普通命令开放。
- **source-confirmed**：VOFA已扩展为36通道；Ch0～Ch20保留原定义，Ch21～Ch35追加校准结果、母线启动诊断、方向映射、MOE和Ud。
- **source-confirmed**：首次母线上电装配校准包含母线门控、800 ms Ud对齐、正反电角周期方向检查、释放后Ud/Uq清零、Flash签名和epoch失效。

## 尚不能确认的根因

- 早期“不转”现象可能涉及状态机门控、Uq/速度语义、方向或当时固件版本，但现有证据不足以把其中某一项写成唯一根因。
- `VO=%f?`导致过流的旧解析路径和当时所有控制量快照未完整保存；当前严格解析是安全修复，但仍需用当前固件验证该命令无副作用。
- SVPWM角与机械角看似反向，不一定单独说明相序错误；编码器方向、Motor_Dir、PWM_Dir、极对数和电角偏置必须独立验证。
- 当前Flash校准实现尚无完整台架记录，因此不能宣称已经自动消除所有焊接相序差异。

## 当前回归清单

- 编译当前脏工作区，保存编译器版本、错误和警告。
- 在低风险母线和限流条件下发送`VO=%f?`、NaN、Inf、指数和残缺命令，确认模式、状态、Ud/Uq、速度和PWM均无变化。
- 完成首次母线校准，保存Ch0、Ch10、Ch13、Ch14、母线、电流、方向和Flash重载结果。
- 完成受限开环正反转：从小AO和小VO开始，确认CO=0立即清零并关闭PWM。
- 验证±30.787608 rad/s软件限幅和Ch18实际积分速度。
- 在进入电流环前标定电流零偏、比例、符号、相映射和ADC采样时刻。

## 当前状态

结果：**inconclusive for current dirty revision**。旧提交开环成功保留为用户报告证据；当前源码行为可以确认，但所有带电安全和闭环能力需按[阶段状态](../stage-status.md)重新验证。
