zxs18261/GIM6010/手搓与AI编写/参考文件和说明文件/硬件电路板相关文件/SCH_Schematic1_1_2026-07-11.pdf

## 0.003采样电阻阻值*20相电流幅值=0.06电压

0.06*20倍=1.2V

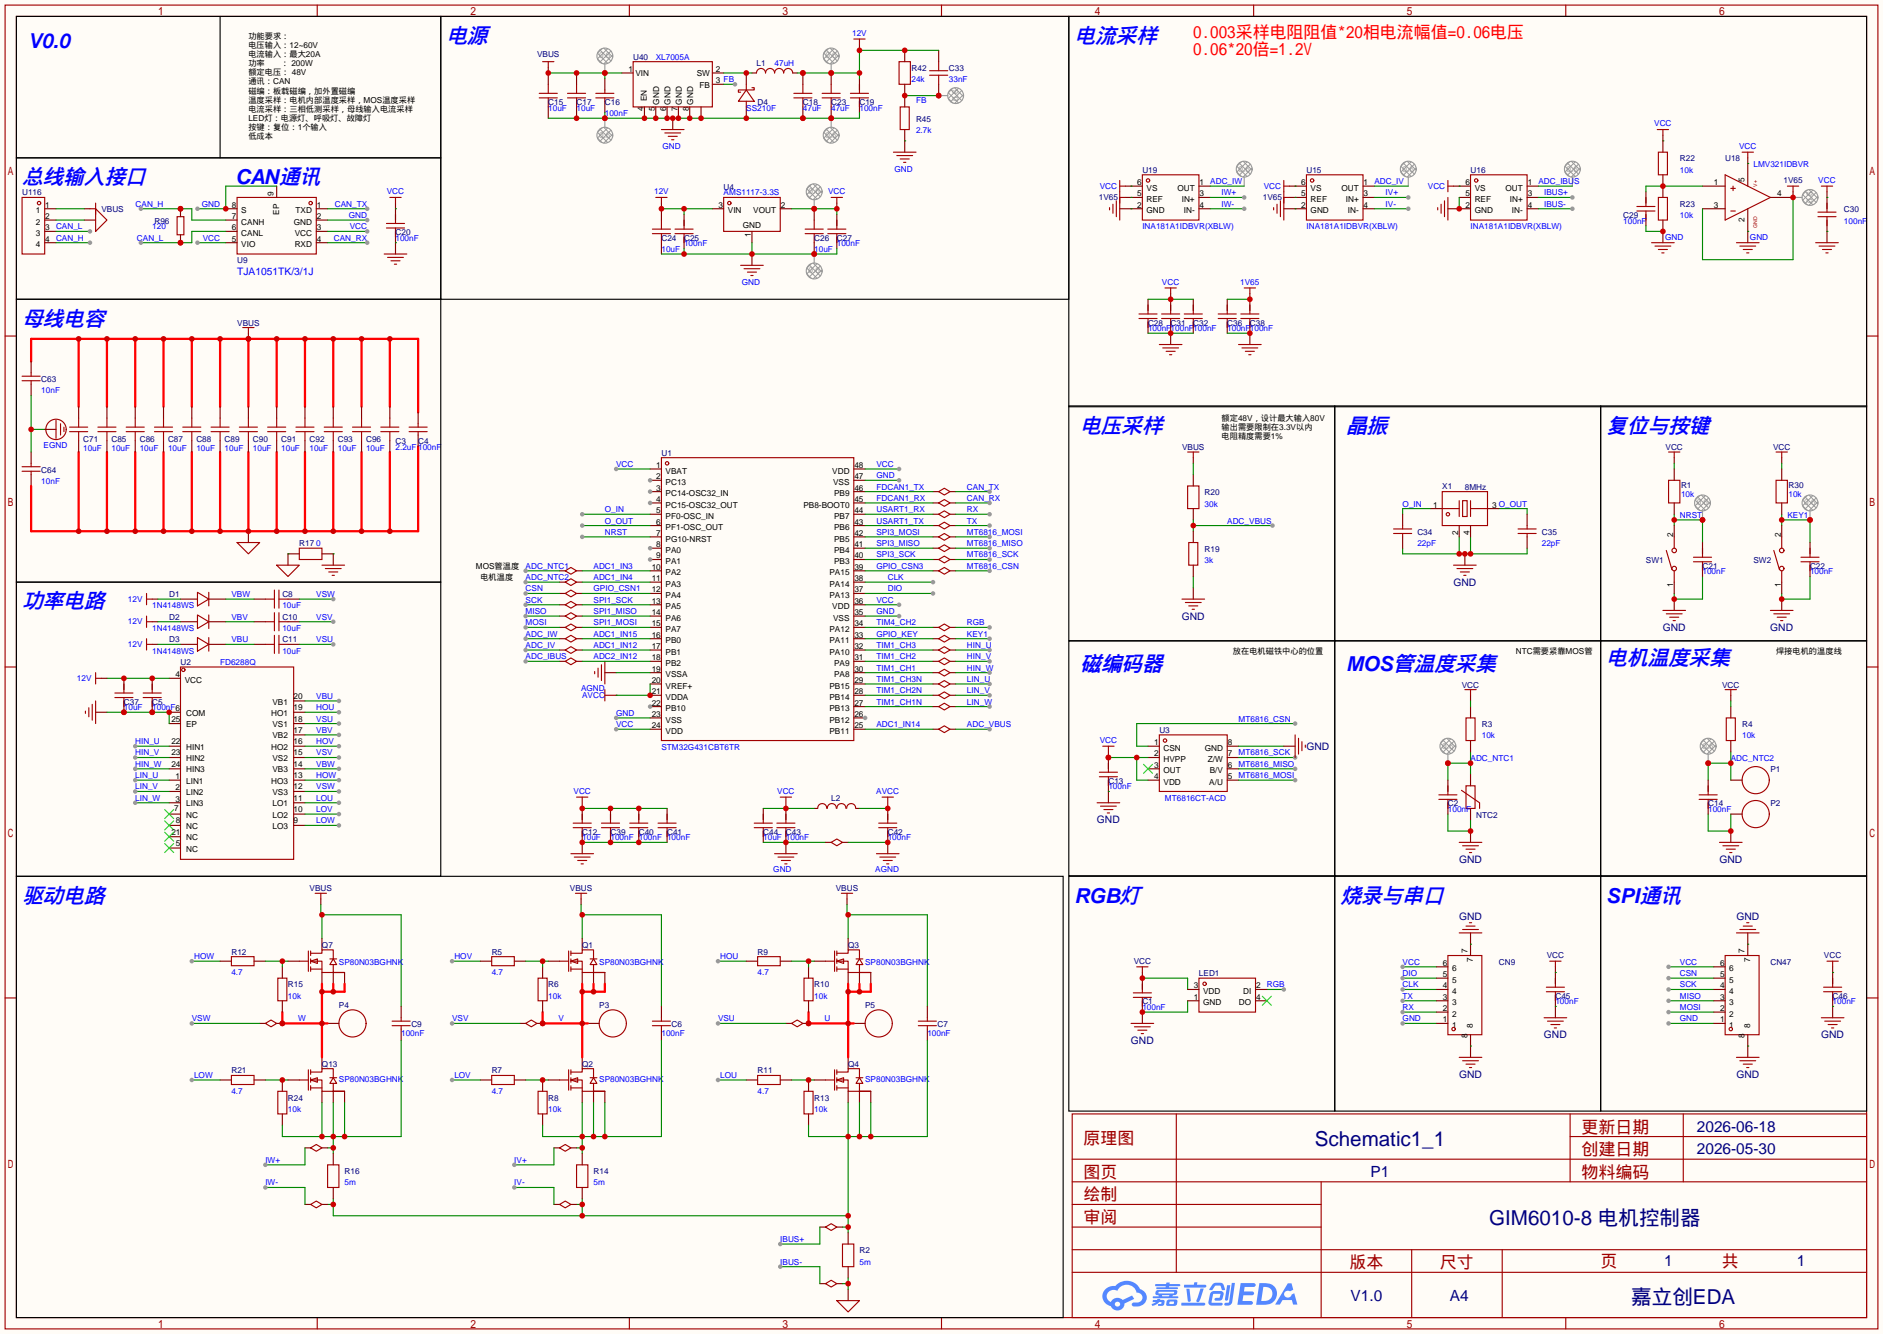
[picture p8: page 1]

功能要求：
电压输入：12~60V
电流输入：最大20A
额定电压： 48V
通讯：CAN
磁编：板载磁编，加外置磁编
温度采样：电机内部温度采样，MOS温度采样
电流采样：三相低测采样，母线输入电流采样
LED灯：电源灯、呼吸灯、故障灯
按键：复位：1个输入
低成本
