zxs18261/GIM6010/1、SguanFOC库文件/Core/Inc/main.h

#define ADC_NTC1_Pin GPIO_PIN_2
#define ADC_NTC1_GPIO_Port GPIOA
#define ADC_NTC2_Pin GPIO_PIN_3
#define ADC_NTC2_GPIO_Port GPIOA
#define CSN_Pin GPIO_PIN_4
#define CSN_GPIO_Port GPIOA
#define ADC_IW_Pin GPIO_PIN_0
#define ADC_IW_GPIO_Port GPIOB
#define ADC_IV_Pin GPIO_PIN_1
#define ADC_IV_GPIO_Port GPIOB
#define ADC_IBUS_Pin GPIO_PIN_2
#define ADC_IBUS_GPIO_Port GPIOB
#define ADC_VBUS_Pin GPIO_PIN_11
#define ADC_VBUS_GPIO_Port GPIOB
#define LIN_W_Pin GPIO_PIN_13
#define LIN_W_GPIO_Port GPIOB
#define LIN_V_Pin GPIO_PIN_14
#define LIN_V_GPIO_Port GPIOB
#define LIN_U_Pin GPIO_PIN_15
#define LIN_U_GPIO_Port GPIOB
#define HIN_W_Pin GPIO_PIN_8
#define HIN_W_GPIO_Port GPIOA
#define HIN_V_Pin GPIO_PIN_9
#define HIN_V_GPIO_Port GPIOA
#define HIN_U_Pin GPIO_PIN_10
#define HIN_U_GPIO_Port GPIOA
#define KEY1_Pin GPIO_PIN_11
#define KEY1_GPIO_Port GPIOA
#define RGB_Pin GPIO_PIN_12
#define RGB_GPIO_Port GPIOA
#define MT6816_CSN_Pin GPIO_PIN_15
#define MT6816_CSN_GPIO_Port GPIOA
#define MT6816_SCK_Pin GPIO_PIN_3
#define MT6816_SCK_GPIO_Port GPIOB
#define MT6816_MISO_Pin GPIO_PIN_4
#define MT6816_MISO_GPIO_Port GPIOB
#define MT6816_MOSI_Pin GPIO_PIN_5
#define MT6816_MOSI_GPIO_Port GPIOB
