zxs18261/GIM6010/1、SguanFOC库文件/Core/Src/main.c

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
/* Includes ------------------------------------------------------------------*/
#include "main.h"
#include "adc.h"
#include "dma.h"
#include "fdcan.h"
#include "spi.h"
#include "tim.h"
#include "usart.h"
#include "gpio.h"

/* USER CODE BEGIN Includes */
#include "SguanFOC.h"
#include "BSP_RGB.h"
/* USER CODE END Includes */


void SystemClock_Config(void);
/**
  * @brief  The application entry point.
  * @retval int
  */
int main(void)
{

  /* MCU Configuration--------------------------------------------------------*/

  /* Reset of all peripherals, Initializes the Flash interface and the Systick. */
  HAL_Init();

  /* Configure the system clock */
  SystemClock_Config();

  /* Initialize all configured peripherals */
  MX_GPIO_Init();
  MX_DMA_Init();
  MX_ADC1_Init();
  MX_ADC2_Init();
  MX_FDCAN1_Init();
  MX_SPI3_Init();
  MX_TIM1_Init();
  MX_TIM4_Init();
  MX_USART1_UART_Init();
  MX_TIM2_Init();
  /* USER CODE BEGIN 2 */
  HAL_UARTEx_ReceiveToIdle_DMA(&huart1, Sguan_PrintfBuff, sizeof(Sguan_PrintfBuff));
  __HAL_DMA_DISABLE_IT(huart1.hdmarx, DMA_IT_HT);
  /* TIM1 只作 PWM（User_InitialInit 里 Start），不要开 Update 中断：
   * 20kHz High_Loop 由 ADC 注入完成回调触发。 */
  HAL_TIM_Base_Start_IT(&htim2);  /* 1kHz：Low_Loop */
  BSP_RGB_Init();





  /* USER CODE END 2 */

  /* Infinite loop */
  /* USER CODE BEGIN WHILE */


//  Sguan.mode = VelCur_DOUBLE_MODE; //设置电机控制模式为速度+电流模式
  Sguan.mode = Velocity_OPEN_MODE; //设置电机控制模式为开环
  Sguan.status = MOTOR_STATUS_UNINITIALIZED;
  while (1)
  {
    /* 灯效示例：改调用预设即可，参数在 BSP_RGB.h / BSP_RGB.c 中配置 */
    //BSP_RGB_Solid(BSP_RGB_ID_GREEN, 200U);                              /* 1. 常亮 */
    //BSP_RGB_Blink(HAL_GetTick(), &BSP_RGB_BLINK_3x1S_PAUSE5S,
    //               BSP_RGB_ID_RED, 255U);                                 /* 3. 分组闪 */
    BSP_RGB_Breath(HAL_GetTick(), &BSP_RGB_BREATH_GREEN);                /* 4. 单色呼吸 */
    //BSP_RGB_RainbowBreath(HAL_GetTick(), &BSP_RGB_RAINBOW);                  /* 5. 彩色呼吸 */
    BSP_RGB_Poll();

    SguanFOC_main_Loop();   //库函数初始化
    /* USER CODE END WHILE */

    /* USER CODE BEGIN 3 */
  
  
  }
  /* USER CODE END 3 */
}

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
