zxs18261/GIM6010/3、SguanFOC库文件/SguanFOC V3.0.1/UserData_Function.h

#ifndef __USERDATA_FUNCTION_H
#define __USERDATA_FUNCTION_H


#include "usart.h"

/* 电机控制User用户设置·功能接口 */
/* 用户自己的CODE BEGIN Includes */
// like: #include "main.h"


/* 用户自己的CODE END Includes */

static inline void User_InitialInit(void){
    /* Your code for initing TIM and gate driver and encoder and ADC here */
    /* like: 
    // 开启SD使能栅极驱动器
    HAL_GPIO_WritePin(SD1_GPIO_Port,SD1_Pin,GPIO_PIN_SET);
    HAL_GPIO_WritePin(SD2_GPIO_Port,SD2_Pin,GPIO_PIN_SET);
    HAL_GPIO_WritePin(SD3_GPIO_Port,SD3_Pin,GPIO_PIN_SET);
    // 开启PWM输出
    HAL_TIM_PWM_Start(&htim1,TIM_CHANNEL_1);
    HAL_TIM_PWM_Start(&htim1,TIM_CHANNEL_2);
    HAL_TIM_PWM_Start(&htim1,TIM_CHANNEL_3);
    HAL_TIM_Encoder_Start(&htim3, TIM_CHANNEL_ALL);
    // 设置TIM3计数器初始值
    __HAL_TIM_SET_COUNTER(&htim3, 0);
    */
}

static inline void User_Delay(unsigned int ms){
    /* Your code for Delay_ms here */
    // like: HAL_Delay(ms);
	
}

static inline signed int User_ReadADC_Raw(unsigned char Current_CH){
    // 电流采样通道0->AB相，1->AC相，2->BC相
    // Sguan.motor.Current_Num值自定义采样通道
    // 用户在UserData_Motor.h中定义“这个值”
    signed int ADC_num = 0;
    switch (Current_CH){
    case 0:
        /* Your code for Motor CH0 raw */
        // like: ADC_num = (signed int)ADC_InjectedValues[1];
        break;
    case 1:
        /* Your code for Motor CH1 raw */
        // like: ADC_num = (signed int)ADC_InjectedValues[2];
        break;
    default:
        break;
    }
    return ADC_num;
}

static inline float User_Encoder_ReadRad(void){
    float Rad_num = 0.0f;
    /* Your code for encoder radian position (0-2pi) if you use SensorFOC */
    // like: Rad_num = Encoder_GetRad();
    return Rad_num;
}

static inline void User_PwmDuty_Set(unsigned short int Duty_u,
                                unsigned short int Duty_v,
                                unsigned short int Duty_w){
    /* Your code for Motor PWM_CH0~2 duty set */
    /* 若是使用正常6相，设置死区补偿，可在此设计 */
    /* like: 
    __HAL_TIM_SET_COMPARE(&htim1,TIM_CHANNEL_1,Duty_u);
    __HAL_TIM_SET_COMPARE(&htim1,TIM_CHANNEL_2,Duty_v);
    __HAL_TIM_SET_COMPARE(&htim1,TIM_CHANNEL_3,Duty_w);
    */
}

static inline float User_VBUS_DataGet(void){
    // float VBUS_num = 0.0f;
    /* Your code for motor VBUS_Voltage Data return if you use it */
    
    // 如果不使用电压功能，返回-9999.0f（正常电压不会是负数）
    return -9999.0f;
}

static inline float User_Temperature_DataGet(void){
    // float Temp_num = 0.0f;
    /* Your code for motor Temperature Data return if you use it */
    
    // 如果不使用温度功能，返回-9999.0f（正常温度不会是这么大的负数）
    return -9999.0f;
}

/* ================= 驱动代码(驱动层) ================= */
static inline void User_CorrespondSet(unsigned char *ch, unsigned short int size){
    /* Your code for UART or CAN Signal Transmit Driver */
    // like: HAL_UART_Transmit(&huart1, ch, size, 0xFFFF);
    if (HAL_UART_GetState(&huart1) == HAL_UART_STATE_READY) {
        (void)HAL_UART_Transmit_DMA(&huart1, ch, size);
    }
	
	
	
	
}


#endif // USERDATA_FUNCTION_H
