zxs18261/GIM6010/3、SguanFOC库文件/SguanFOC V3.0.1/Sguan_printf.h

#ifndef __SGUAN_PRINTF_H
#define __SGUAN_PRINTF_H

/* SguanFOC配置文件声明 */
#include "Sguan_Config.h"

/**
 * @description: 自定义数据发送的个数(默认为8)
 * @return {*}
 */
#define CH_COUNT 20 // UART或者CAN发送的数据个数

typedef struct{
    float fdata[CH_COUNT];
    uint8_t tail[4];
}PRINTF_STRUCT;

extern uint8_t Sguan_PrintfBuff[200];

// 函数定义声明
void Printf_Init(PRINTF_STRUCT *str);
void Printf_Loop(PRINTF_STRUCT *str);
void Printf_Adjust(void);


#endif // SGUAN_PRINTF_H
