zxs18261/GIM6010/(commit log)

2026-07-13 完成开环验证、灯色正常，编码器正常
2026-07-28 在原来的文件基础上新开了一个文件夹，里面使用SguanFOC库文件，目前使用AI进行数据输入，还未进行代码编写以及调试
2026-07-29 完成RGB灯的初版编写，基础功能正常，后续功能继续测试补充
2026-07-31 更新RGB的BSP文件，目前能够满足我的需求，后续根据情况修改
2026-08-01 完成VOFA上位机对接
2026-08-02 能够简单开环运行，并且上位机可以控制
2026-08-02 能够简单开环运行以及上位机控制
2026-08-04 清理过期的 MDK-ARM 构建产物，并同步本地 Keil 配置。
2026-08-05 补充 SVPWM 扇区计算与限幅处理的注释说明
2026-08-23 能够开环运行
2026-09-08 纳入 1、2、3 三个版本目录，原 SguanFOC库文件 重命名为 3、SguanFOC库文件
    3、为当前源工程（新增 01~03 流程目录、APP 应用层、SguanFOC V3.0.1）；1、2 为历史版本。zip 与 手搓与AI编写 未纳入，磁盘上原样保留。
2026-09-17 同步 BSP 按键/RGB/TIM 模块与 FOC 源码，更新文档并清理过期归档（不含构建产物）
