zxs18261/GIM6010/(notices)

Notices in the files:
1、SguanFOC库文件/Core/Src/adc.c:
Copyright (c) 2026 STMicroelectronics.
All rights reserved.
This software is licensed under terms that can be found in the LICENSE file
